rightsum/gerdoo/docs/images/front-cover-v1.png

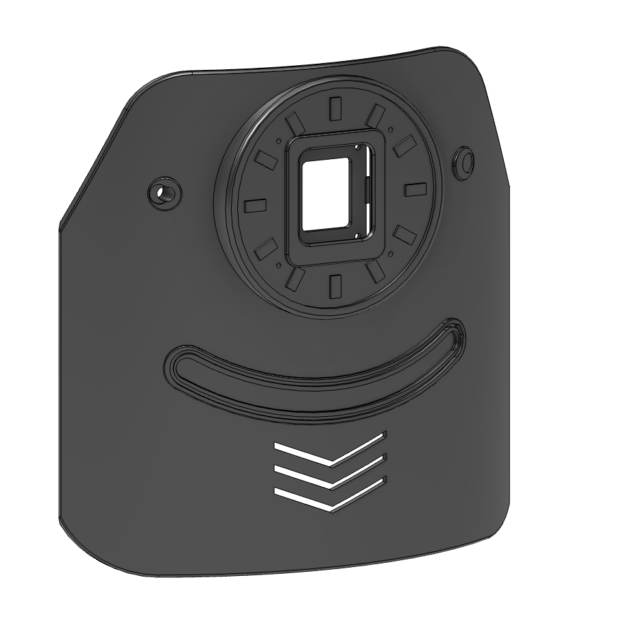
docs/images/front-cover-v1.png
