rightsum/gerdoo/print/3mf/gerdoo_coil_pads_A1.3mf

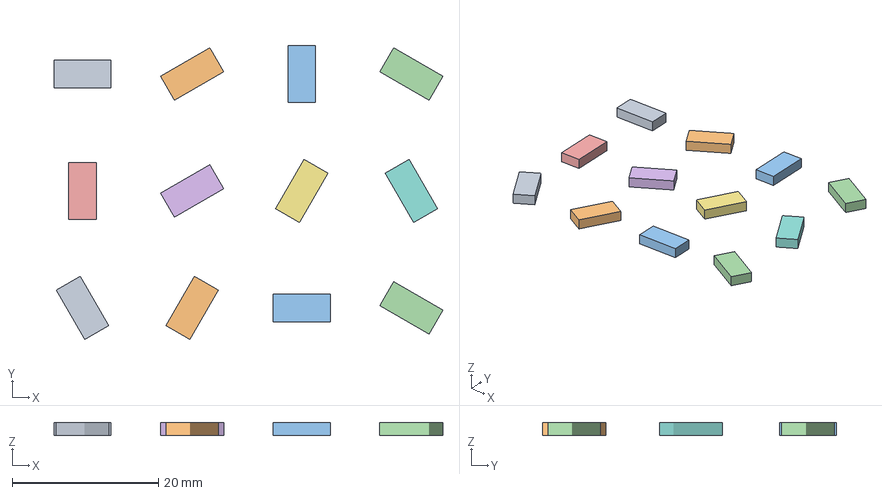
[picture p5: CAD file, 2026-11-07]
print/3mf/gerdoo_coil_pads_A1.3mf
53.2 x 40.2 x 1.80 mm
coil pad 01
coil pad 02
coil pad 03
coil pad 04
coil pad 05
coil pad 06
coil pad 07
coil pad 08
coil pad 09
coil pad 10
coil pad 11
coil pad 12
