rightsum/gerdoo/print/stl/01-1st-layer/1st-layer-v5.stl

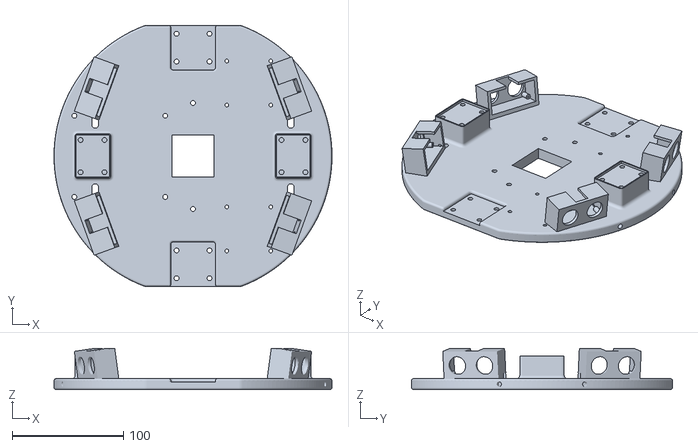
[picture p6: CAD file, 2026-11-07]
print/stl/01-1st-layer/1st-layer-v5.stl
250.0 x 234.9 x 37.3
