rightsum/gerdoo/print/stl/02-arm-bases-separators/arm-base-r.stl

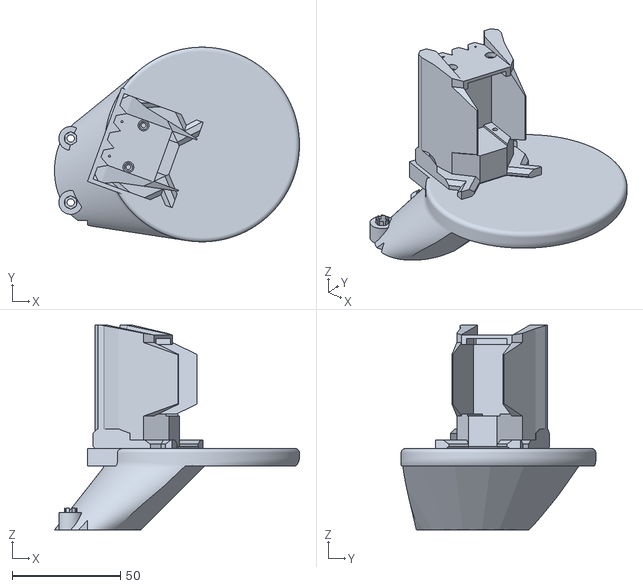
[picture p7: CAD file, 2026-11-07]
print/stl/02-arm-bases-separators/arm-base-r.stl
113.3 x 90.0 x 94.6
