rightsum/gerdoo/print/stl/04-base-board-holders/side-wall-robot-left.stl

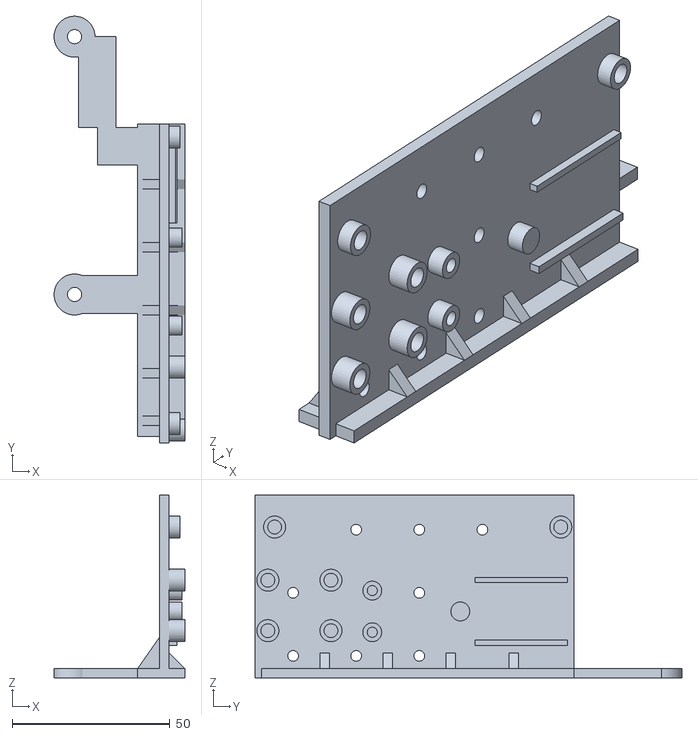
[picture p9: CAD file, 2026-11-07]
print/stl/04-base-board-holders/side-wall-robot-left.stl
41.5 x 135.2 x 58.0
