rightsum/gerdoo/print/stl/05-m3-spacers/m3-threaded-hex-spacer.stl

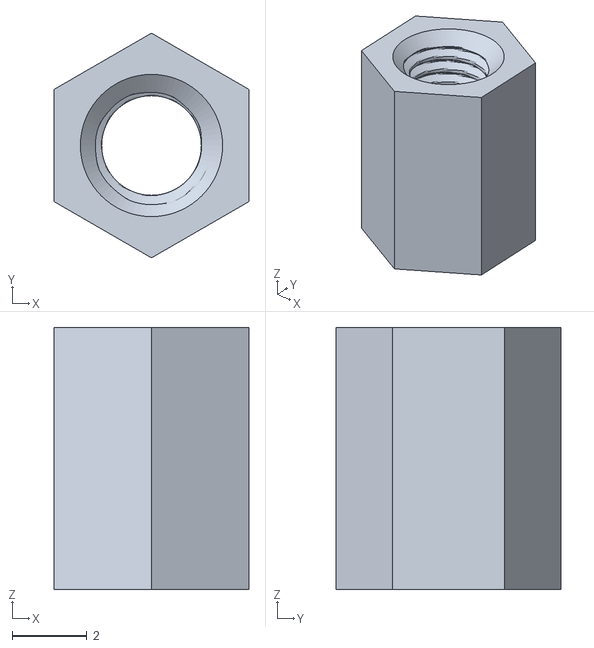
[picture p10: CAD file, 2026-11-07]
print/stl/05-m3-spacers/m3-threaded-hex-spacer.stl
5.20 x 6.00 x 7.00
