rightsum/gerdoo/print/stl/06-2nd-floor/2nd-3rd-separator.stl

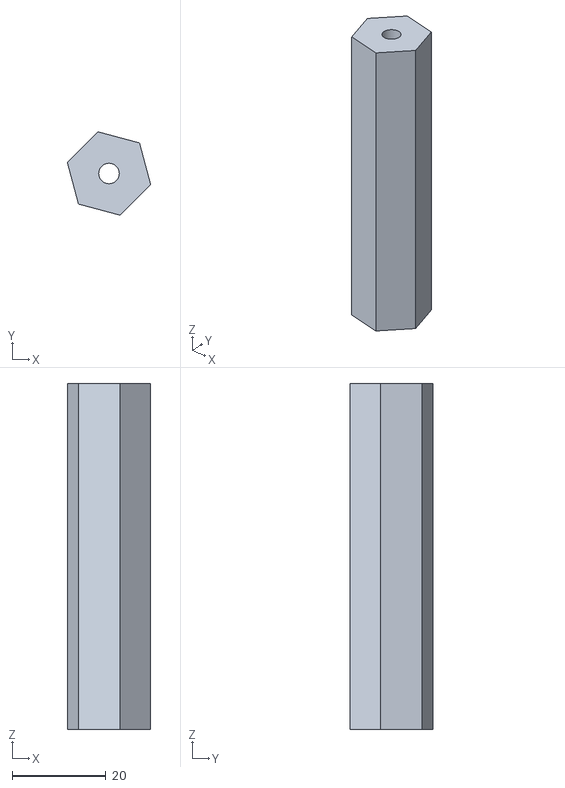
[picture p11: CAD file, 2026-11-07]
print/stl/06-2nd-floor/2nd-3rd-separator.stl
17.8 x 17.8 x 74.0
