rightsum/gerdoo/print/stl/07-3rd-floor/antenna-bracket-back-v2.stl

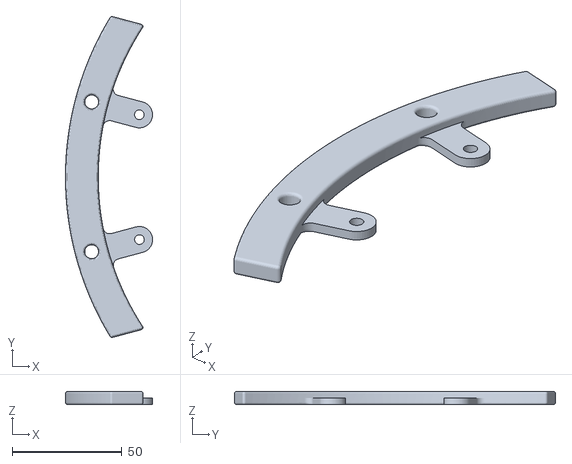
[picture p12: CAD file, 2026-11-07]
print/stl/07-3rd-floor/antenna-bracket-back-v2.stl
39.8 x 146.4 x 6.00
