rightsum/gerdoo/print/stl/08-neck-lidar/neck-pan-base.stl

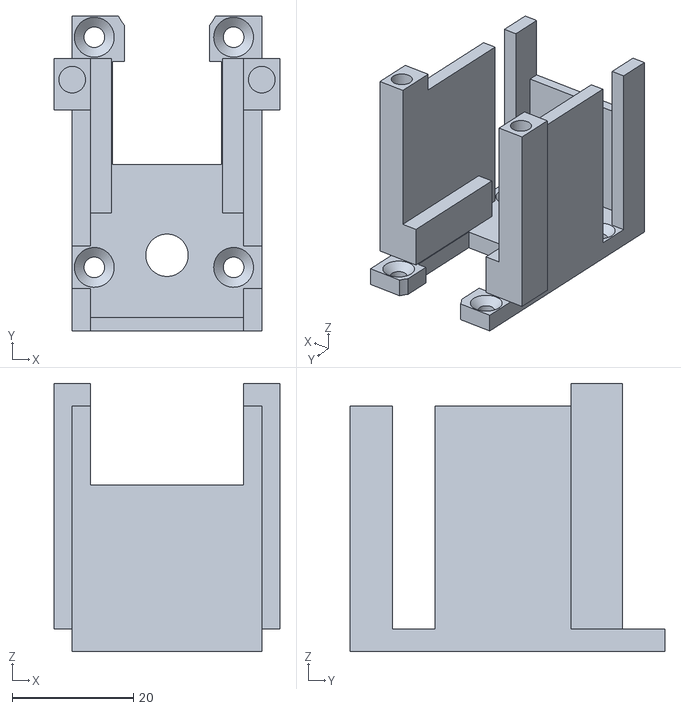
[picture p13: CAD file, 2026-11-07]
print/stl/08-neck-lidar/neck-pan-base.stl
37.3 x 52.0 x 44.2
