rightsum/gerdoo/print/stl/09-front-cover/front-cover-v12.stl

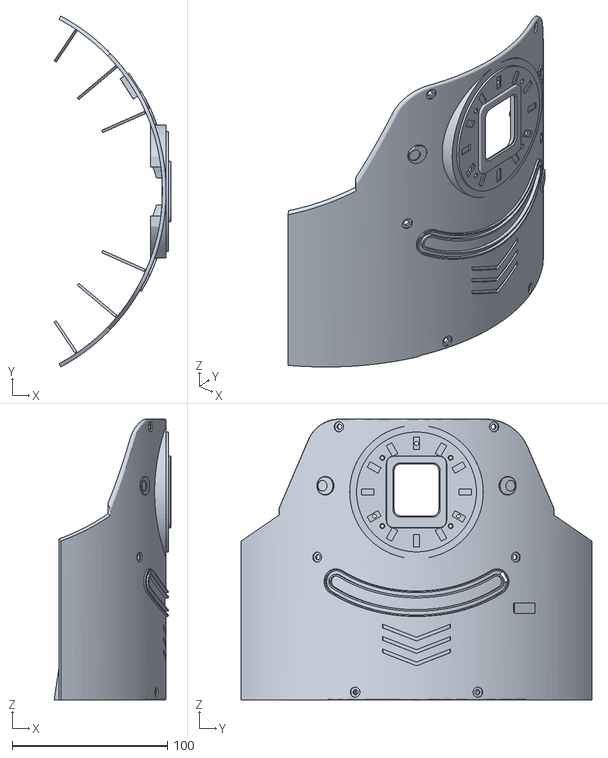
[picture p14: CAD file, 2026-11-07]
print/stl/09-front-cover/front-cover-v12.stl
75.2 x 226.0 x 181.0
