rightsum/gerdoo/print/stl/10-back-cover/ldr-cradle-v7.stl

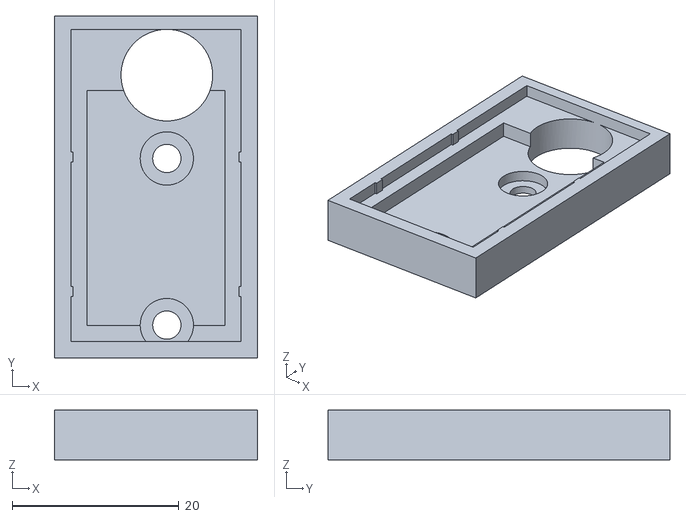
[picture p15: CAD file, 2026-11-07]
print/stl/10-back-cover/ldr-cradle-v7.stl
24.4 x 41.0 x 6.00
