rightsum/gerdoo/print/stl/11-display-retainer/display-retainer.stl

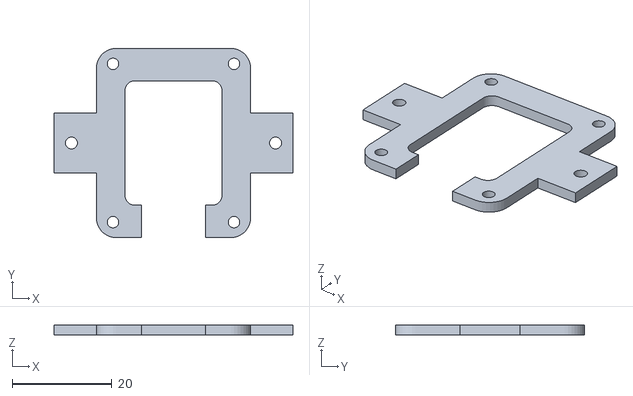
[picture p16: CAD file, 2026-11-07]
print/stl/11-display-retainer/display-retainer.stl
48.0 x 38.0 x 2.00
