rightsum/gerdoo/print/stl/12-coil-pads/coil-pad.stl

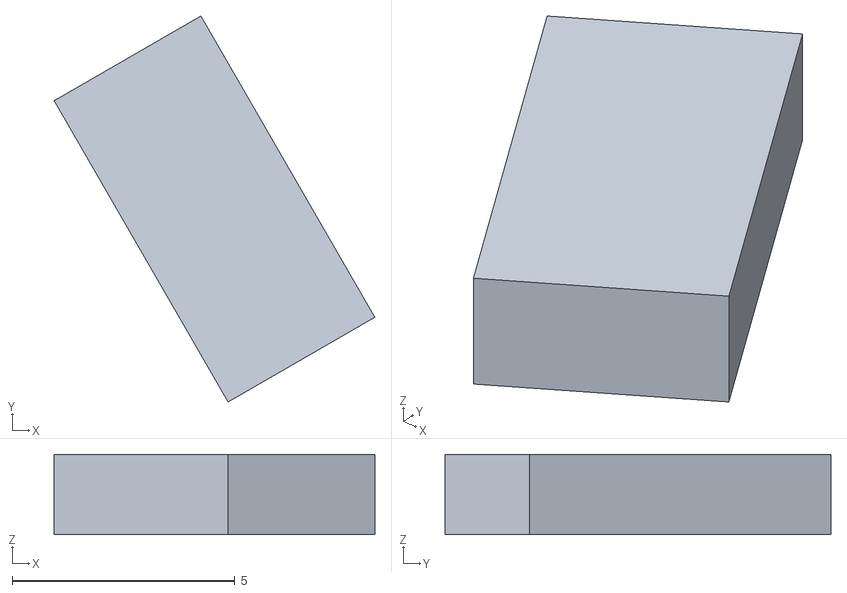
[picture p17: CAD file, 2026-11-07]
print/stl/12-coil-pads/coil-pad.stl
7.19 x 8.65 x 1.80
