rightsum/gerdoo/print/stl/15-dock-sign/sign-head.stl

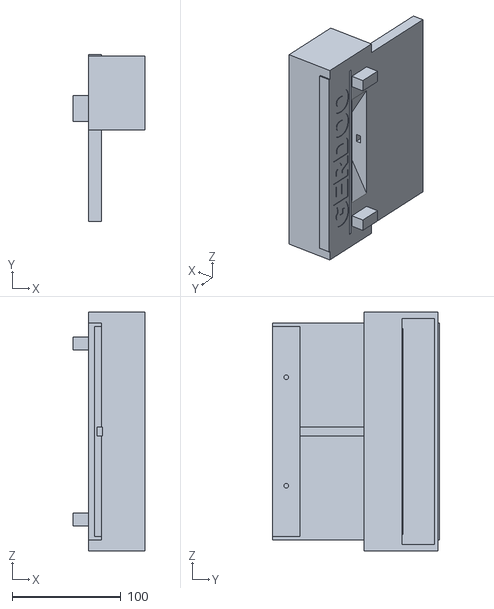
[picture p18: CAD file, 2026-11-07]
print/stl/15-dock-sign/sign-head.stl
66.0 x 153.3 x 220.0
