rightsum/gerdoo/print/stl/16-dock-letters/letter-5-r.stl

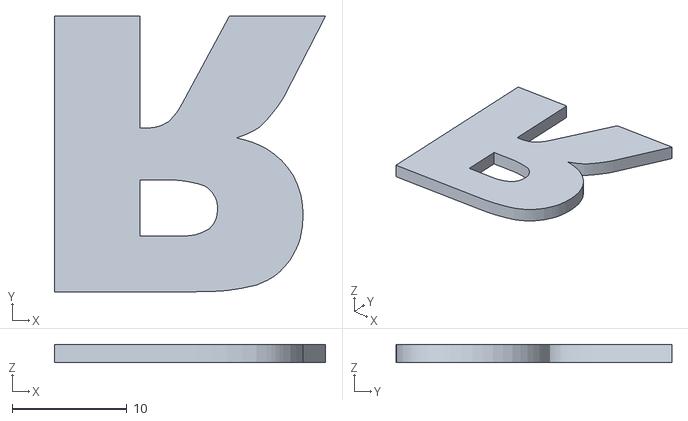
[picture p19: CAD file, 2026-11-07]
print/stl/16-dock-letters/letter-5-r.stl
23.6 x 24.0 x 1.60
