rightsum/gerdoo/sim/web/meshes/gerdoo/antennas.stl

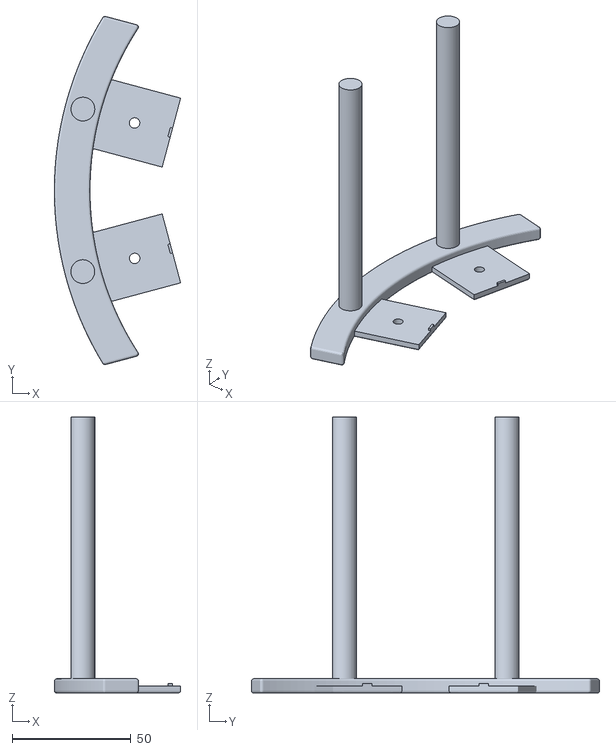
[picture p20: CAD file, 2026-11-07]
sim/web/meshes/gerdoo/antennas.stl
53.1 x 146.4 x 116.0
