rightsum/gerdoo/print/3mf/gerdoo_neck_lidar_v3_A1.3mf

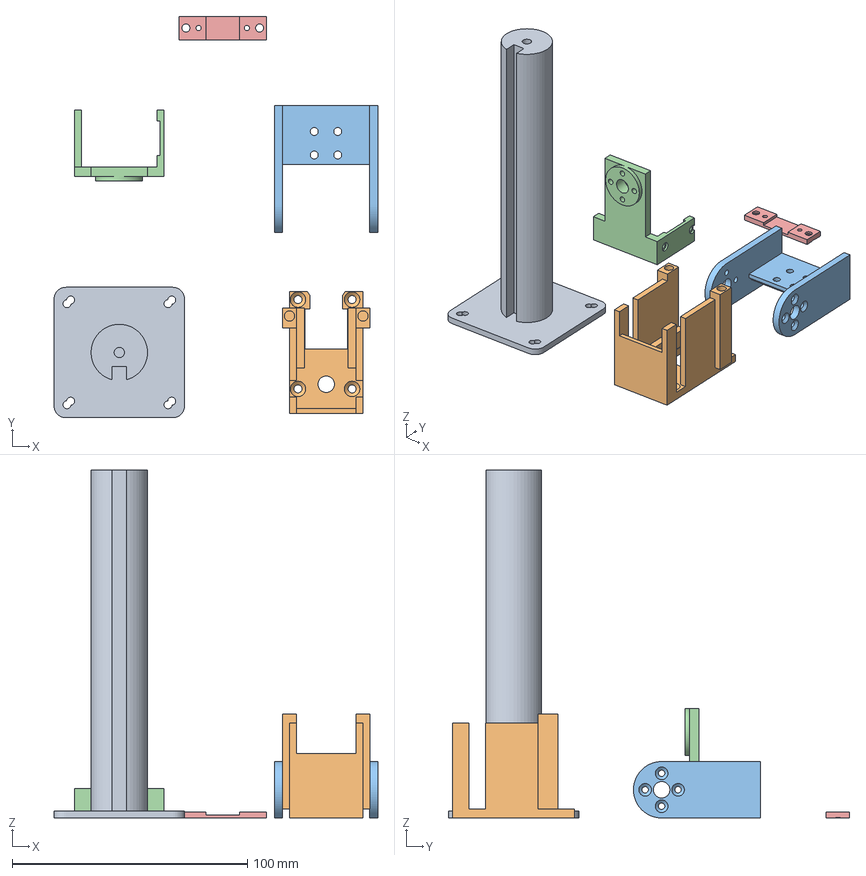
[picture p21: CAD file, 2026-11-07]
print/3mf/gerdoo_neck_lidar_v3_A1.3mf
137.8 x 170.8 x 148.0 mm
lidar holder v2 (plate down, post up)
neck pan base (floor down)
neck head yoke (on its back; support + PETG interface under the pad)
neck arm (on its side, +z up)
neck pan clamp (flipped)
