rightsum/gerdoo/print/stl/02-arm-bases-separators/separator-round-80.stl

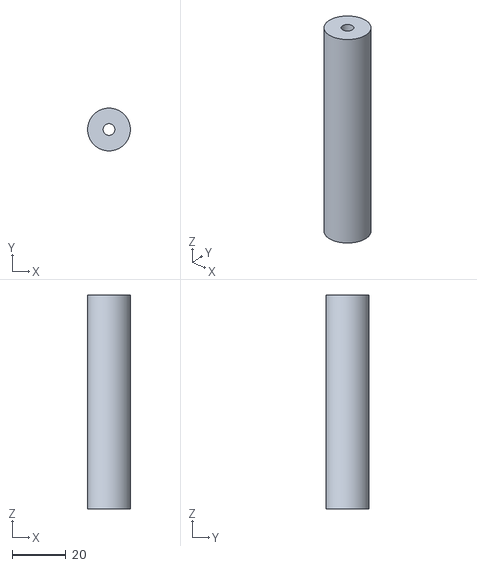
[picture p22: CAD file, 2026-11-07]
print/stl/02-arm-bases-separators/separator-round-80.stl
16.0 x 16.0 x 80.0
