rightsum/gerdoo/print/stl/03-motor-shims/motor-bracket-shim-1-48-mm.stl

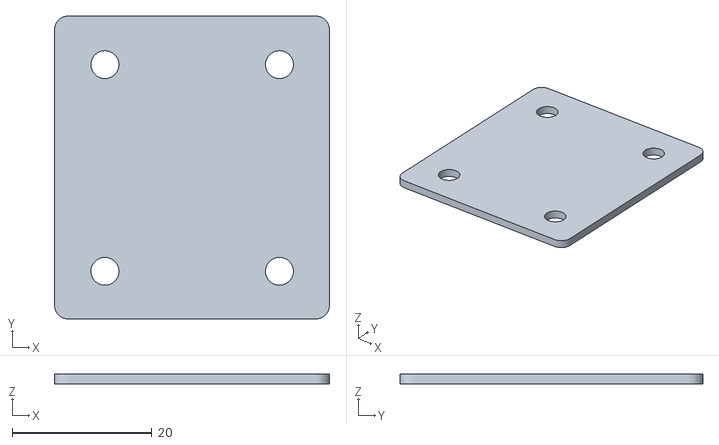
[picture p23: CAD file, 2026-11-07]
print/stl/03-motor-shims/motor-bracket-shim-1-48-mm.stl
39.4 x 43.4 x 1.48
