rightsum/gerdoo/print/stl/04-base-board-holders/side-wall-robot-right.stl

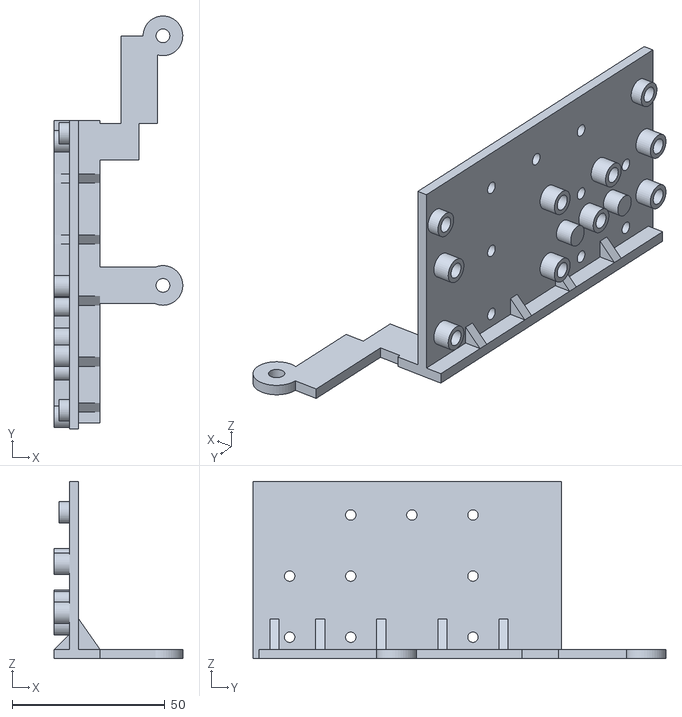
[picture p24: CAD file, 2026-11-07]
print/stl/04-base-board-holders/side-wall-robot-right.stl
42.1 x 135.2 x 58.0
