rightsum/gerdoo/print/stl/06-2nd-floor/hub-rear-spacer.stl

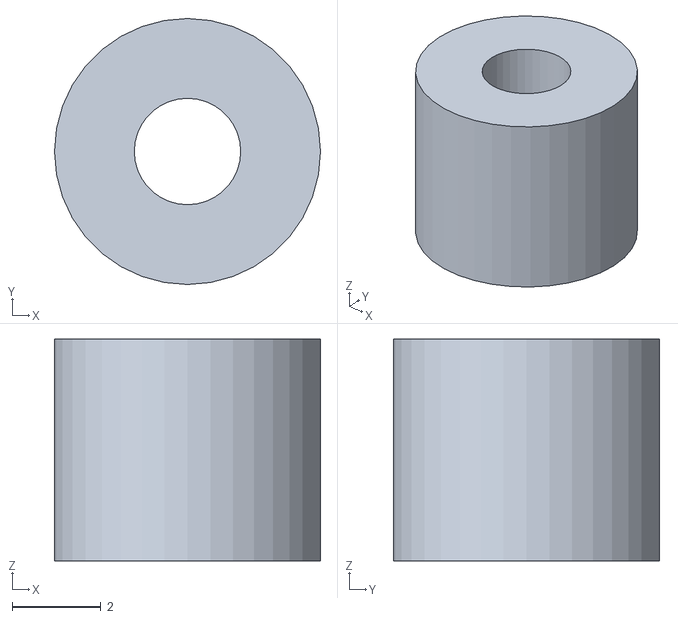
[picture p25: CAD file, 2026-11-07]
print/stl/06-2nd-floor/hub-rear-spacer.stl
6.00 x 6.00 x 5.00
