rightsum/gerdoo/print/stl/07-3rd-floor/speaker-grille-cap.stl

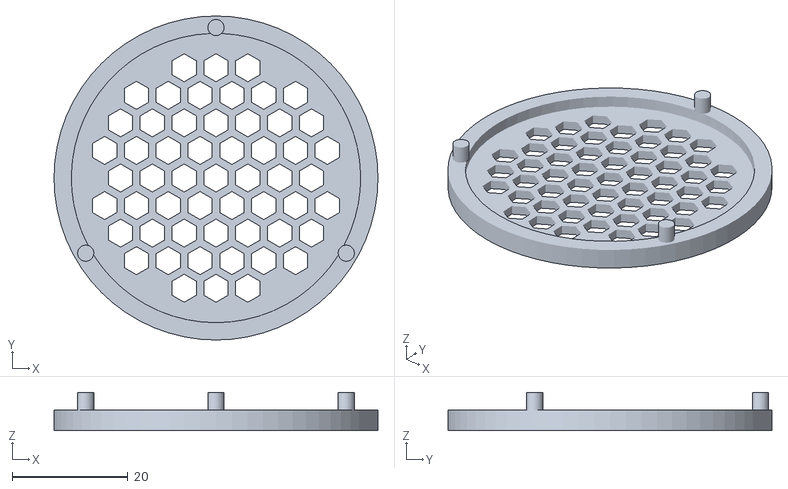
[picture p26: CAD file, 2026-11-07]
print/stl/07-3rd-floor/speaker-grille-cap.stl
56.0 x 56.0 x 6.60
