rightsum/gerdoo/print/stl/08-neck-lidar/neck-head-yoke.stl

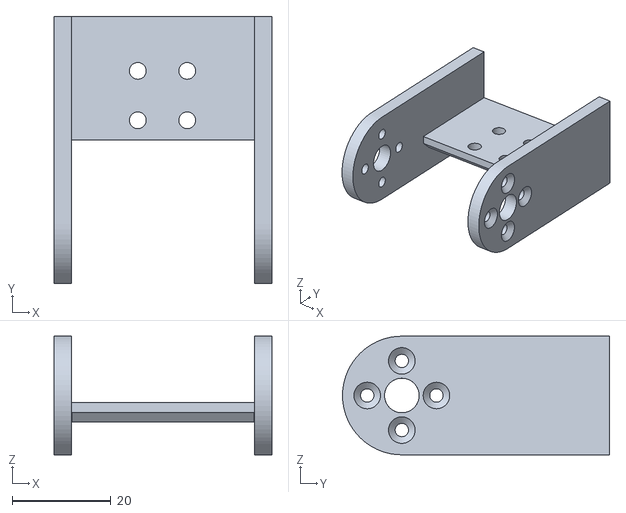
[picture p27: CAD file, 2026-11-07]
print/stl/08-neck-lidar/neck-head-yoke.stl
44.0 x 54.0 x 24.0
