rightsum/gerdoo/print/stl/10-back-cover/back-cover-v11.stl

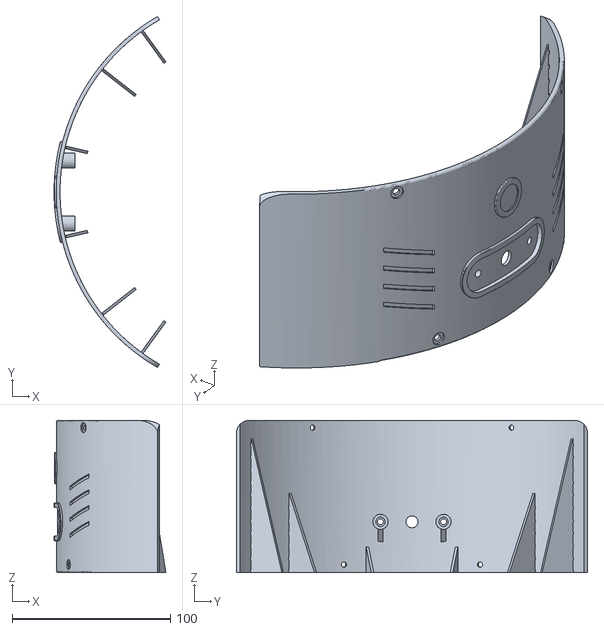
[picture p28: CAD file, 2026-11-07]
print/stl/10-back-cover/back-cover-v11.stl
70.7 x 221.7 x 96.0
