rightsum/gerdoo/print/stl/16-dock-letters/letter-o.stl

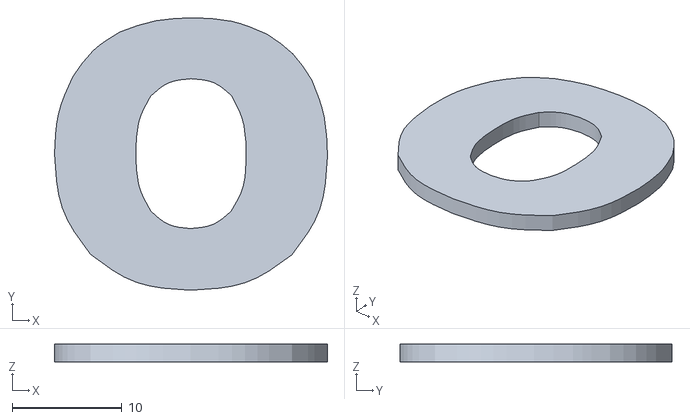
[picture p29: CAD file, 2026-11-07]
print/stl/16-dock-letters/letter-o.stl
24.9 x 24.8 x 1.60
