rightsum/gerdoo/sim/web/meshes/gerdoo/brain.stl

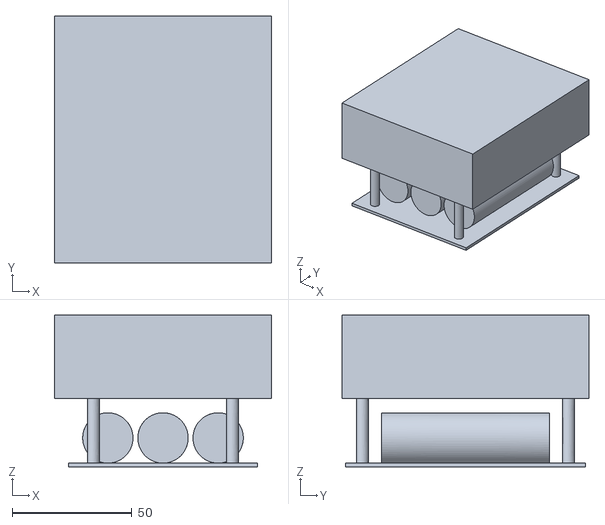
[picture p30: CAD file, 2026-11-07]
sim/web/meshes/gerdoo/brain.stl
90.5 x 103.0 x 63.4
