rightsum/gerdoo/print/stl/02-arm-bases-separators/separator-hex-77.stl

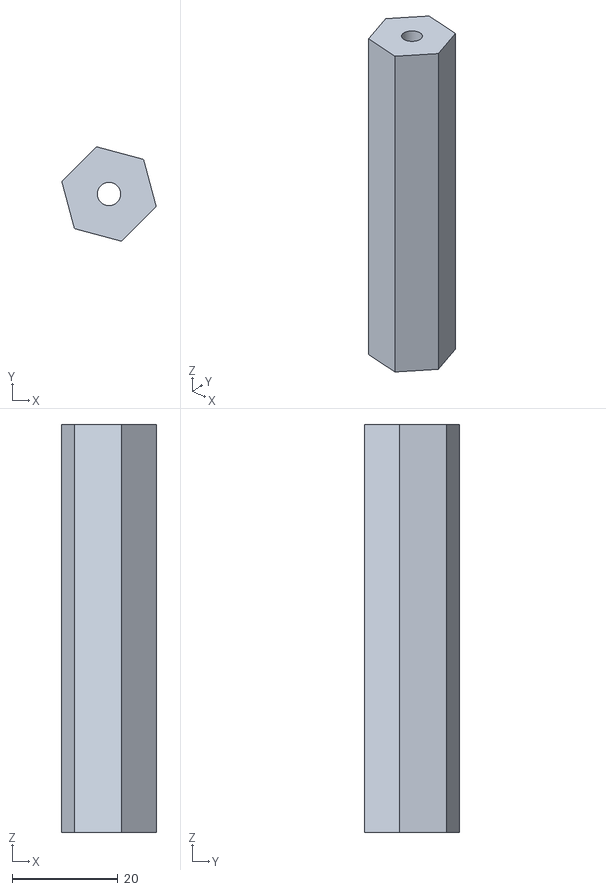
[picture p31: CAD file, 2026-11-07]
print/stl/02-arm-bases-separators/separator-hex-77.stl
17.8 x 17.8 x 77.0
