rightsum/gerdoo/print/stl/07-3rd-floor/3rd-floor-v2.stl

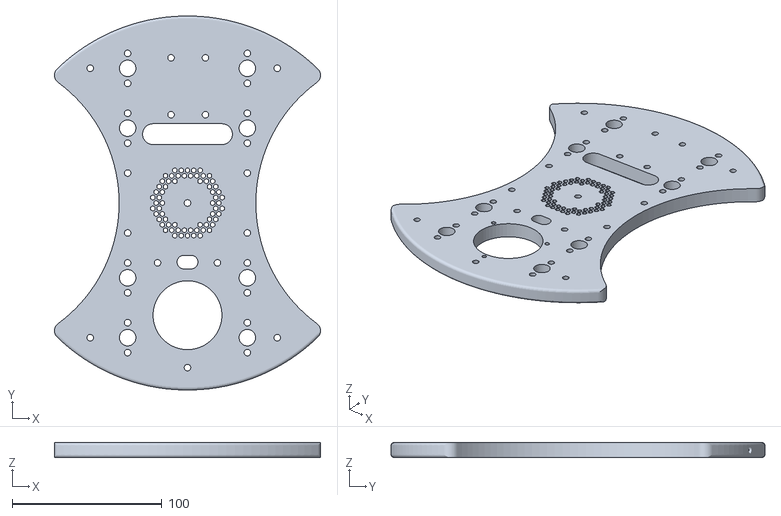
[picture p33: CAD file, 2026-11-07]
print/stl/07-3rd-floor/3rd-floor-v2.stl
177.8 x 249.9 x 10.0
