rightsum/gerdoo/print/stl/08-neck-lidar/lidar-holder-v2.stl

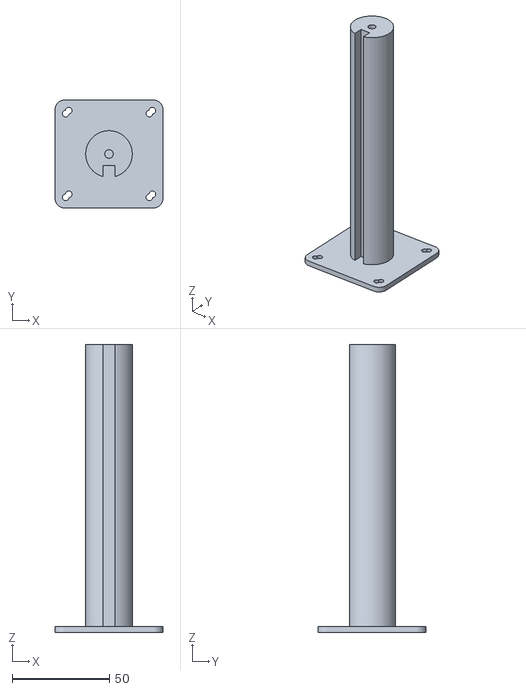
[picture p34: CAD file, 2026-11-07]
print/stl/08-neck-lidar/lidar-holder-v2.stl
55.5 x 55.5 x 148.0
