rightsum/gerdoo/print/stl/16-dock-letters/letter-4-d.stl

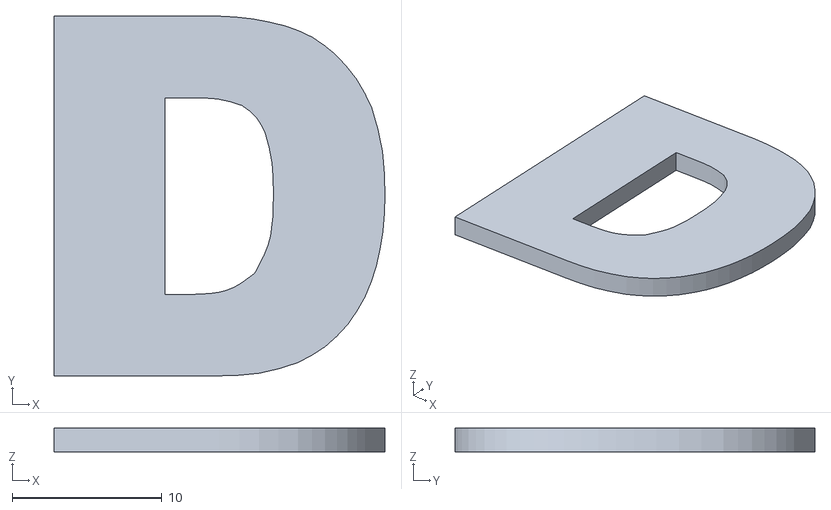
[picture p35: CAD file, 2026-11-07]
print/stl/16-dock-letters/letter-4-d.stl
22.1 x 24.0 x 1.60
