rightsum/gerdoo/sim/web/meshes/gerdoo/neck_tilt.stl

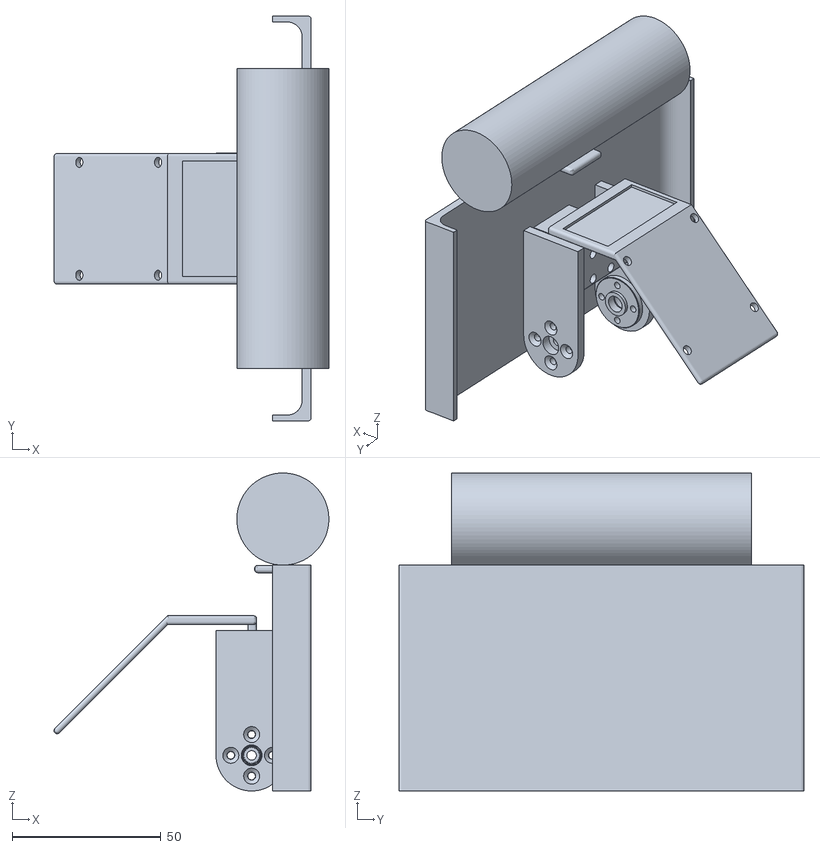
[picture p36: CAD file, 2026-11-07]
sim/web/meshes/gerdoo/neck_tilt.stl
92.5 x 136.3 x 107.0
