rightsum/gerdoo/print/3mf/gerdoo_dock_cradle_A1.3mf

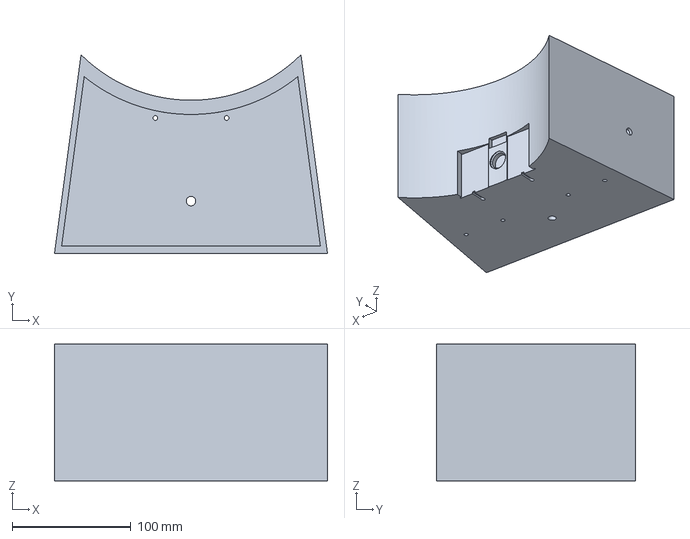
[picture p37: CAD file, 2026-11-07]
print/3mf/gerdoo_dock_cradle_A1.3mf
230.0 x 167.4 x 115.0 mm
