rightsum/gerdoo/print/stl/03-motor-shims/motor-bracket-shim-0-68-mm.stl

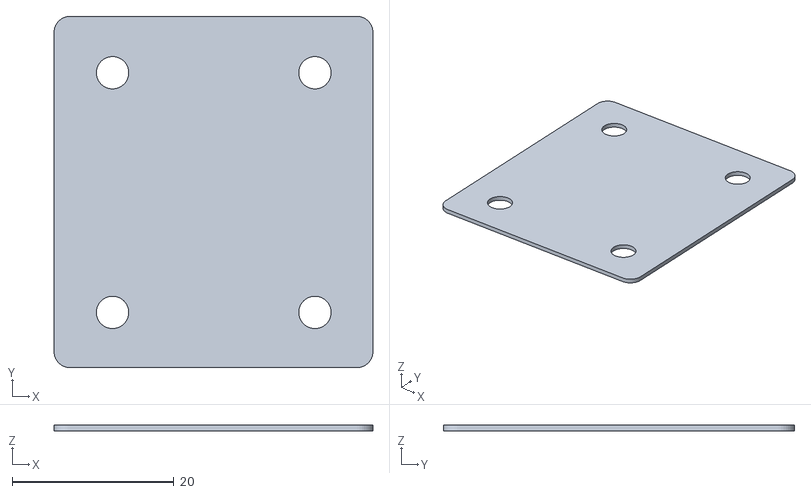
[picture p38: CAD file, 2026-11-07]
print/stl/03-motor-shims/motor-bracket-shim-0-68-mm.stl
39.4 x 43.4 x 0.68
