rightsum/gerdoo/print/stl/04-base-board-holders/servo-tower.stl

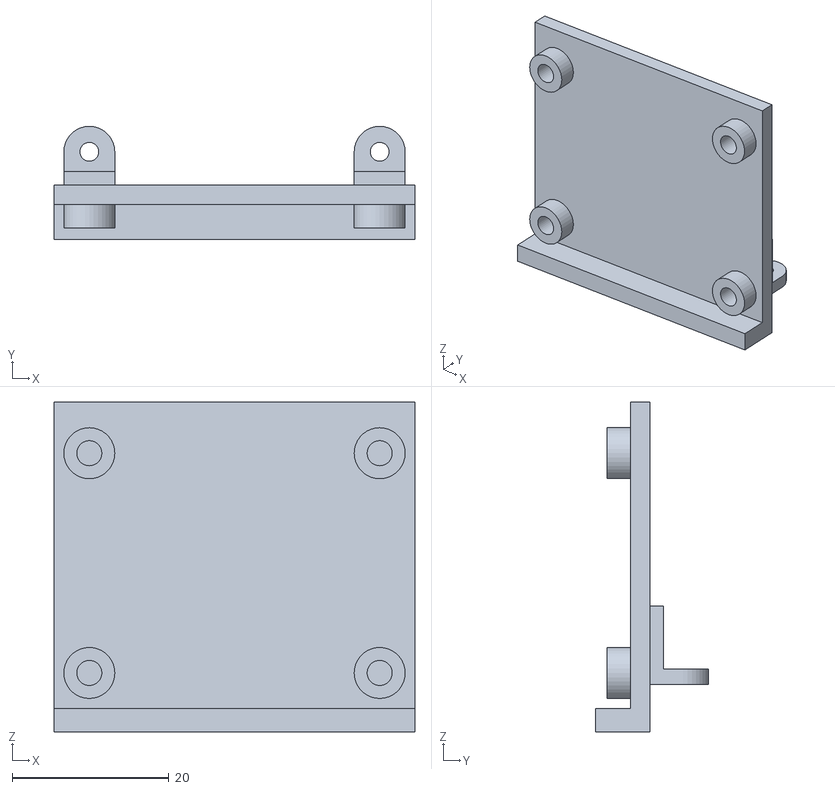
[picture p39: CAD file, 2026-11-07]
print/stl/04-base-board-holders/servo-tower.stl
46.0 x 14.4 x 42.0
