rightsum/gerdoo/print/stl/08-neck-lidar/neck-arm.stl

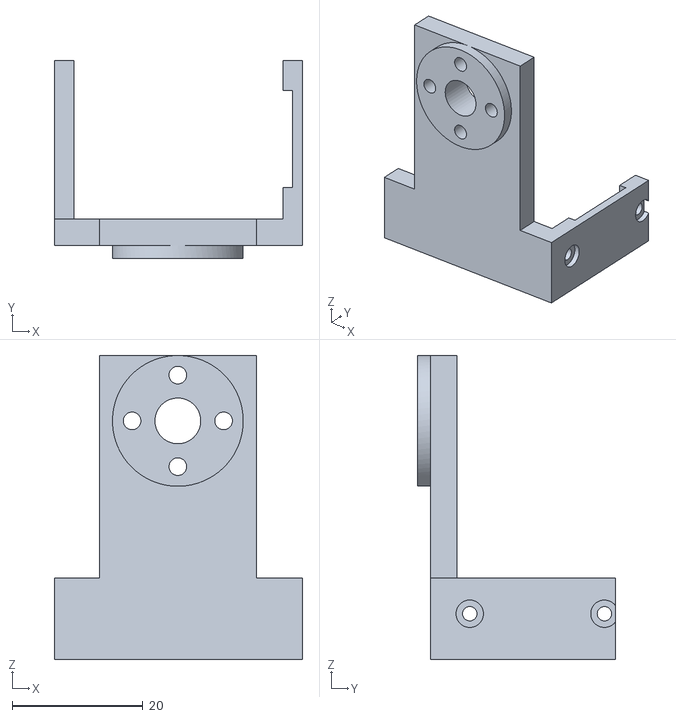
[picture p40: CAD file, 2026-11-07]
print/stl/08-neck-lidar/neck-arm.stl
38.0 x 30.3 x 46.5
