rightsum/gerdoo/sim/web/meshes/gerdoo/armbase.stl

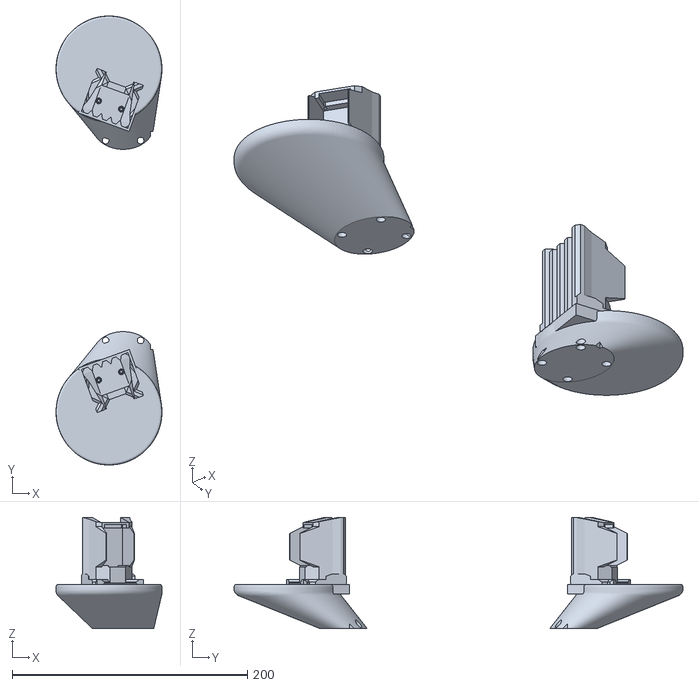
[picture p41: CAD file, 2026-11-07]
sim/web/meshes/gerdoo/armbase.stl
90.0 x 381.3 x 94.6
