rightsum/gerdoo/print/3mf/gerdoo_gold_ring_A1.3mf

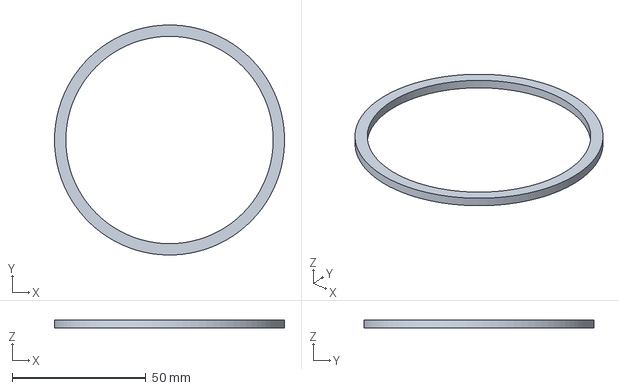
[picture p42: CAD file, 2026-11-07]
print/3mf/gerdoo_gold_ring_A1.3mf
86.0 x 86.0 x 3.00 mm
