rightsum/gerdoo/sim/web/meshes/gerdoo/cover_back.stl

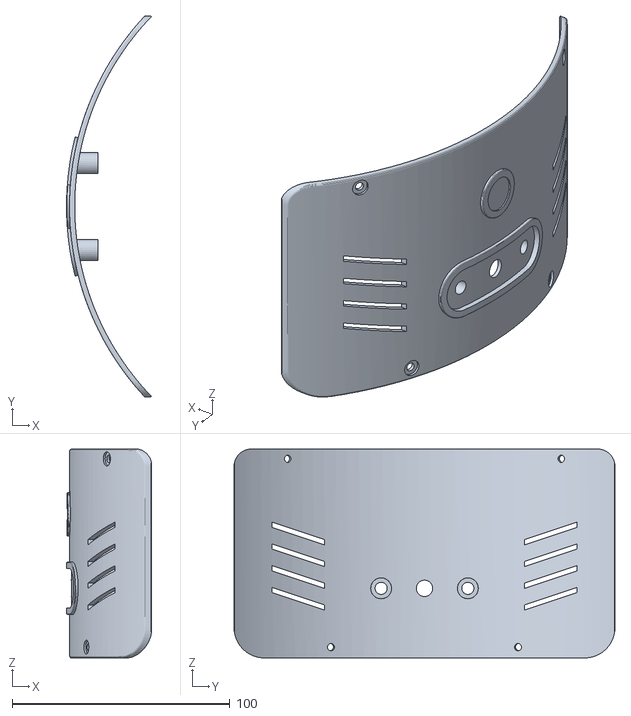
[picture p43: CAD file, 2026-11-07]
sim/web/meshes/gerdoo/cover_back.stl
39.0 x 175.0 x 96.0
