rightsum/gerdoo/print/3mf/gerdoo_base_board_holders_v5_A1.3mf

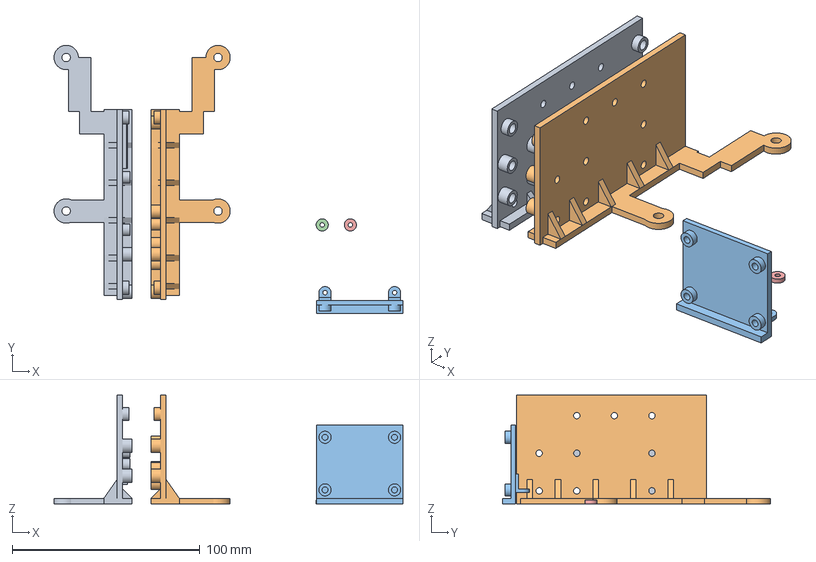
[picture p44: CAD file, 2026-11-07]
print/3mf/gerdoo_base_board_holders_v5_A1.3mf
185.7 x 142.8 x 58.0 mm
side wall robot-left (+x)
side wall robot-right (-x)
servo tower (ears supported, PETG interface)
Teensy washer 1
Teensy washer 2
