rightsum/gerdoo/print/3mf/gerdoo_2nd_floor_A1.3mf

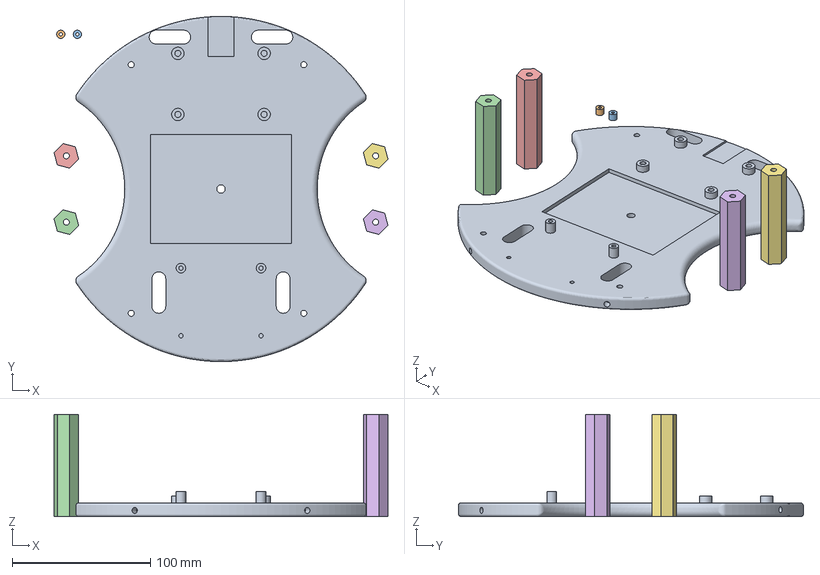
[picture p45: CAD file, 2026-11-07]
print/3mf/gerdoo_2nd_floor_A1.3mf
241.8 x 250.0 x 74.0 mm
2nd-floor-v2
hub rear spacer 1
hub rear spacer 2
2nd-3rd separator 1 (hex 74)
2nd-3rd separator 2 (hex 74)
2nd-3rd separator 3 (hex 74)
2nd-3rd separator 4 (hex 74)
