rightsum/gerdoo/print/3mf/gerdoo_arm_bases_separators_A1_v2.3mf

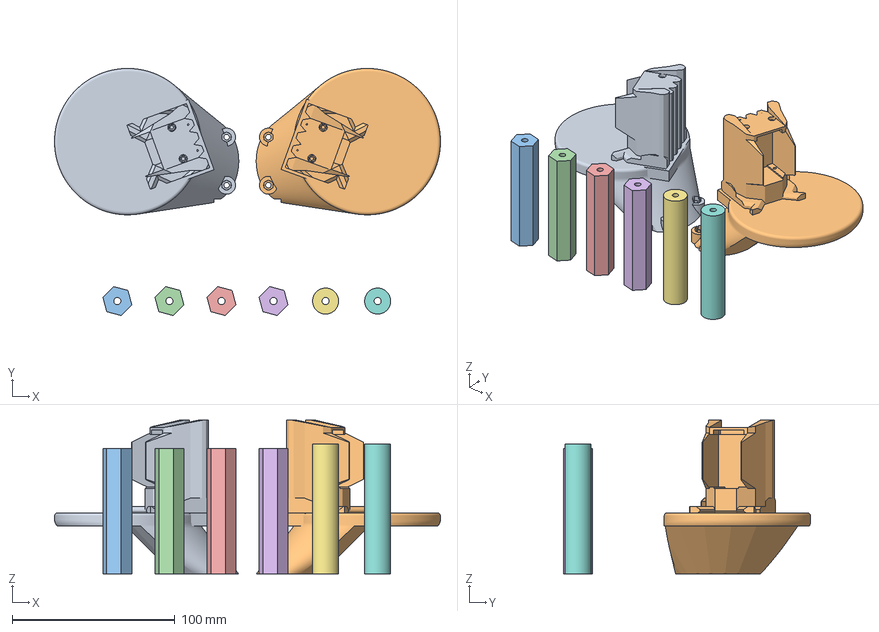
[picture p46: CAD file, 2026-11-07]
print/3mf/gerdoo_arm_bases_separators_A1_v2.3mf
237.3 x 151.9 x 94.6 mm
arm base L
arm base R
separator hex 77 #1
separator hex 77 #2
separator hex 77 #3
separator hex 77 #4
separator round 80 #1
separator round 80 #2
