rightsum/gerdoo/(list of files, cad)

Other CAD files:
print/3mf/gerdoo_1st_layer_A1_v5.3mf
print/stl/04-base-board-holders/teensy-washer.stl
