rightsum/gerdoo/teensy_microros/teensy_microros.ino

/*
  Teensy 4.1 — micro-ROS node over USB, with the debug console kept alive.

  Step 3: adds main battery voltage monitoring on A0 via a Voltage Sensor
  Module (Max 25V, 5:1 divider). The 3S pack (12.6V max) produces 2.52V on
  A0 — safely within the 3.3V ADC range.

  ---------------------------------------------------------------------------
  DUAL SERIAL — the reason this builds with usb=serial2
  ---------------------------------------------------------------------------
  micro-ROS consumes the serial port it runs on: that port becomes XRCE-DDS
  framing, so Serial.print debugging on it is impossible. On a robot still
  being brought up that is painful, and it is exactly what makes micro-ROS
  failures feel opaque.

  Teensy solves it for free. USB Type = Dual Serial gives two CDC interfaces:

    Serial      -> /dev/ttyACM0  human console. Same line protocol as
                                 teensy_bringup, so health_check.py still works.
    SerialUSB1  -> /dev/ttyACM1  micro-ROS transport. Agent attaches here.

  micro_ros_arduino's default transport is hardcoded to `Serial`
  (src/default_transport.cpp), but its four entry points are declared
  __attribute__((weak)). Defining strong versions below overrides them and
  moves micro-ROS onto SerialUSB1. No library edits, so an upgrade cannot
  silently revert this.

  ---------------------------------------------------------------------------
  ROS 2 interface
  ---------------------------------------------------------------------------
    publish   /teensy/heartbeat      std_msgs/Int32     seq, 1 Hz
    publish   /teensy/temperature    std_msgs/Float32   die temp C, 1 Hz
    publish   /teensy/battery_main   std_msgs/Float32   main battery V, 1 Hz
    subscribe /teensy/led            std_msgs/Bool      onboard LED

  The LED is the only actuator that exists yet. It proves the subscribe path
  end to end without touching a single robot peripheral.

  ---------------------------------------------------------------------------
  RECONNECTION
  ---------------------------------------------------------------------------
  A naive micro-ROS sketch hangs forever if the agent is not up at boot, and
  stays dead if the agent restarts. On a robot both happen routinely — the
  Jetson reboots, the agent gets restarted. So this runs a connection state
  machine that pings for the agent, builds its entities when one appears, and
  tears them down cleanly when it vanishes. The console keeps working in every
  state, which is the whole point of Dual Serial.
*/

#include "arm_types.h"
#include <EEPROM.h>
#include <micro_ros_arduino.h>

#include <stdio.h>
#include <rcl/rcl.h>
#include <rcl/error_handling.h>
#include <rclc/rclc.h>
#include <rclc/executor.h>

#include <std_msgs/msg/int32.h>
#include <std_msgs/msg/float32.h>
#include <std_msgs/msg/bool.h>

#include <Servo.h>  // Neck pan/tilt servos (SG90)
#include "drive_types.h"  // drive motors; encoders on the RT1062's hardware decoders

// ---------------------------------------------------------------------------
// Transport override: move micro-ROS from Serial to SerialUSB1.
// These are strong definitions of the library's weak symbols.
// ---------------------------------------------------------------------------
extern "C" {

bool arduino_transport_open(struct uxrCustomTransport * transport) {
  (void)transport;
  SerialUSB1.begin(115200);
  return true;
}

bool arduino_transport_close(struct uxrCustomTransport * transport) {
  (void)transport;
  SerialUSB1.end();
  return true;
}

// NOTE: micro_ros_arduino.h declares buf as `const uint8_t *` while
// default_transport.cpp defines it non-const. The header wins here, since we
// include it — C linkage means the symbol still overrides the weak definition.
size_t arduino_transport_write(struct uxrCustomTransport * transport,
                               const uint8_t * buf, size_t len, uint8_t * errcode) {
  (void)transport; (void)errcode;
  return SerialUSB1.write(buf, len);
}

size_t arduino_transport_read(struct uxrCustomTransport * transport,
                              uint8_t * buf, size_t len, int timeout,
                              uint8_t * errcode) {
  (void)transport; (void)errcode;
  SerialUSB1.setTimeout(timeout);
  return SerialUSB1.readBytes((char *)buf, len);
}

}  // extern "C"

// ---------------------------------------------------------------------------

const char *FW_VERSION = "microros-0.5.1";
const int LED_PIN = 13;
const uint32_t HEARTBEAT_MS = 1000;

// --- Main battery voltage sensor (A0) ---
// Voltage Sensor Module Max 25V: 30k/7.5k divider = factor 5.
// 3S Li-ion pack: 12.6V max → 2.52V on A0 (safe for 3.3V ADC).
const int BATTERY_MAIN_PIN = A0;
const float BATTERY_DIVIDER = 5.0;
const float ADC_REF = 3.3;
const int ADC_MAX = 4095;  // 12-bit

// Cached readings (updated every heartbeat, published when agent is up).
float batteryMainV = 0.0;
float powerPackV = 0.0;        // from the servos, see readPackVoltage()
uint8_t powerPackId = 0;
uint32_t lastPackRead = 0;
int   batteryMainRaw = 0;

// --- COB LED strip via D4184 MOSFET module (pin 4) ---
// Low-side switch: the strip sits across OUT+/OUT- and the module chops OUT-
// against VIN-. 18 kHz is inside the module's 0-20 kHz spec, above adult
// hearing so the strip does not whine, and far above any camera shutter so it
// cannot band the OV9281s or the Brio.
const int LED_STRIP_PIN = 4;
const int STRIP_PWM_HZ  = 18000;
const int STRIP_MAX     = 4095;   // 12-bit, matches analogWriteResolution

// Brightness ceiling. Held at ~39% while the strip shared the LM2596S 5V rail
// with the neck servos — at full brightness it sagged the pack ~200 mV and made
// the servos strain. Lifted to full 2026-08-26 once the strip moved onto its own
// MINI560 (5A) fed from the 12.6V pack. Drop it again if the strip is ever put
// back on a shared rail.
const int STRIP_DUTY_MAX = STRIP_MAX;

// --- Ambient light sensor (Keyestudio photoresistor module, A1) ---
// The 10k half of the divider is on the module; S is its midpoint. Powered
// from 3.3V, so S can never exceed the ADC limit.
const int LDR_PIN = A1;

// Which way the module's divider is wired — batches differ. true = a lit
// sensor reads high. Flip this if covering the sensor makes the strip go
// DARKER instead of brighter.
const bool LDR_BRIGHT_IS_HIGH = true;

// Raw ADC values bracketing the useful range; readings outside clamp. Tune
// with the CAL console commands, then paste the results back here — they are
// not persisted across a reboot or a reflash.
//
// Measured 2026-08-26 with the Keyestudio module on A1:
//   529  — sensor covered by a hand
//   3163 — full daylight
//   ~950-1270 — normally lit room at night
//
// The bright endpoint is deliberately NOT the 3163 daylight figure. Against
// that ceiling a lit evening room maps to ~78% brightness and the strip would
// run near-full every night. 1400 means "the room is adequately lit, strip
// off", and anything brighter simply clamps. Raise it to make the strip more
// eager, lower it to make it lazier.
int ldrRawDark   = 529;
int ldrRawBright = 1400;

// Slow enough that the strip lighting its own sensor cannot start an
// oscillation. At 20 Hz updates this is roughly a one-second time constant.
const float STRIP_SMOOTH = 0.05f;
const uint32_t STRIP_UPDATE_MS = 50;

int   ldrRaw        = 0;
float ldrNormalized = 0.0;   // 0 = dark room, 1 = bright room
float stripSmoothed = 0.0;   // 0..1, before gamma
int   stripDuty     = 0;     // last value written to the pin
float stripManual   = -1.0;  // <0 = follow the sensor, 0..1 = forced level
uint32_t lastStripUpdate = 0;

// --- Neck pan/tilt servos (SG90, 5V from LM2596S) ---
Servo servoPan;
Servo servoTilt;
const int SERVO_PAN_PIN = 2;
const int SERVO_TILT_PIN = 3;
// Straight ahead on this bracket, found by adjustment — not the midpoint of
// the servo range, because the gimbal is not mounted symmetrically.
int servoPanPos = 110;
int servoTiltPos = 110;
const int SERVO_PAN_MIN = 70;   // pan limits
const int SERVO_PAN_MAX = 140;
const int SERVO_TILT_MIN = 60;  // tilt limits
const int SERVO_TILT_MAX = 120;

// The tilt servo is mounted reversed, so a larger logical angle means a
// smaller pulse. Wrapped in a function because this has to be applied
// identically at boot and in the loop; two copies of it would drift.
static inline void writeTilt(int logical) {
  servoTilt.write(SERVO_TILT_MAX + SERVO_TILT_MIN - logical);
}

// Smooth motion.
//
// This used to ease by a fixed FRACTION per loop iteration, which sounds gentle
// until you notice the loop runs at ~999 Hz: 3% of the remaining distance a
// thousand times a second is a peak of roughly 1200 deg/s. A human neck manages
// 100-200. It looked and sounded like a machine snapping to position.
//
// Now it is time-based and speed-limited, updating at 50 Hz because that is the
// rate an SG90 actually samples its input — writing faster is churn the servo
// cannot see.
const uint32_t SERVO_UPDATE_MS = 20;      // 50 Hz, the servo's own PWM rate
const float SERVO_MAX_DPS = 70.0;         // top speed, degrees per second
const float SERVO_EASE_TAU = 0.18;        // seconds; softens the last few degrees

// Holding position is what makes an SG90 buzz. Pan carries no weight against
// gravity, so once it has settled it can be released and go quiet. Tilt holds
// the screen up and must stay energised or the head drops.
const uint32_t PAN_IDLE_DETACH_MS = 1500;

uint32_t lastServoUpdate = 0;
uint32_t panSettledAt = 0;
bool panAttached = true;

float servoPanCurrent = 110.0;
float servoTiltCurrent = 110.0;

// Move `current` toward `target` for one tick: an exponential ease so it settles
// softly, capped by a top speed so a large jump does not start out violently.
static inline float easeToward(float current, float target, float dt) {
  float delta = target - current;
  if (fabsf(delta) < 0.05f) return (float)target;
  float step = delta * (dt / SERVO_EASE_TAU);
  float cap = SERVO_MAX_DPS * dt;
  if (step > cap) step = cap;
  if (step < -cap) step = -cap;
  return current + step;
}
int lastPanWritten = 110;
int lastTiltWritten = 110;

// How often to look for an agent while disconnected. Cheap ping, so half a
// second keeps reconnection prompt without flooding the link.
const uint32_t AGENT_PING_MS = 500;

rcl_allocator_t   allocator;
rclc_support_t    support;
rcl_node_t        node;
rclc_executor_t   executor;

rcl_publisher_t   pub_heartbeat;
rcl_publisher_t   pub_temperature;
rcl_publisher_t   pub_battery_main;
rcl_publisher_t   pub_light;
rcl_subscription_t sub_led;
rcl_subscription_t sub_strip;

std_msgs__msg__Int32   msg_heartbeat;
std_msgs__msg__Float32 msg_temperature;
std_msgs__msg__Float32 msg_battery_main;
std_msgs__msg__Float32 msg_light;
std_msgs__msg__Bool    msg_led;
std_msgs__msg__Float32 msg_strip;

enum AgentState { WAITING_AGENT, AGENT_AVAILABLE, AGENT_CONNECTED, AGENT_DISCONNECTED };
AgentState agentState = WAITING_AGENT;

uint32_t bootMillis = 0;
uint32_t lastHeartbeat = 0;
uint32_t lastAgentPing = 0;
uint32_t heartbeatSeq = 0;
uint32_t loopCount = 0;
uint32_t loopsPerSec = 0;
uint32_t lastRateCalc = 0;
uint32_t agentConnects = 0;
uint32_t agentDrops = 0;
bool ledState = false;

char cmdBuf[128];
uint8_t cmdLen = 0;

// Run fn; on failure return false from the calling function. Used during
// entity creation so a partial build is reported rather than half-committed.
#define RCCHECK(fn) { rcl_ret_t rc = fn; if (rc != RCL_RET_OK) return false; }
// Fire and forget — a failed publish is reported via the console, not fatal.
#define RCSOFT(fn)  { rcl_ret_t rc = fn; (void)rc; }

const char *restartCause() {
  uint32_t s = SRC_SRSR;
  if (s & (1 << 6)) return "temp_panic";
  if (s & (1 << 5)) return "watchdog3";
  if (s & (1 << 4)) return "jtag_sw";
  if (s & (1 << 3)) return "jtag_hw";
  if (s & (1 << 2)) return "watchdog";
  if (s & (1 << 1)) return "lockup";
  if (s & (1 << 0)) return "power_on";
  return "unknown";
}

const char *agentStateName() {
  switch (agentState) {
    case WAITING_AGENT:      return "waiting";
    case AGENT_AVAILABLE:    return "available";
    case AGENT_CONNECTED:    return "connected";
    case AGENT_DISCONNECTED: return "disconnected";
  }
  return "?";
}

void led_callback(const void *msgin) {
  const std_msgs__msg__Bool *m = (const std_msgs__msg__Bool *)msgin;
  ledState = m->data;
  digitalWrite(LED_PIN, ledState ? HIGH : LOW);
  Serial.print("EVENT led=");
  Serial.println(ledState ? "on" : "off");
}

// Perceived brightness tracks roughly the square of duty cycle, so a linear
// ramp looks wrong at the bottom end. Gamma 2.0 is cheap and close enough.
static inline int stripGamma(float level) {
  return (int)(level * level * STRIP_MAX + 0.5);
}

void updateStrip() {
  ldrRaw = analogRead(LDR_PIN);

  int lo = min(ldrRawDark, ldrRawBright);
  int hi = max(ldrRawDark, ldrRawBright);
  float span = (float)(hi - lo);
  float n = (span > 1.0) ? ((float)constrain(ldrRaw, lo, hi) - lo) / span : 0.0;
  ldrNormalized = LDR_BRIGHT_IS_HIGH ? n : (1.0 - n);

  // Darker room -> brighter strip, unless a manual level is in force.
  float target = (stripManual >= 0.0) ? stripManual : (1.0 - ldrNormalized);

  stripSmoothed += (target - stripSmoothed) * STRIP_SMOOTH;
  int duty = stripGamma(constrain(stripSmoothed, 0.0, 1.0));
  duty = min(duty, STRIP_DUTY_MAX);
  if (duty != stripDuty) {
    stripDuty = duty;
    analogWrite(LED_STRIP_PIN, stripDuty);
  }
}

void strip_callback(const void *msgin) {
  const std_msgs__msg__Float32 *m = (const std_msgs__msg__Float32 *)msgin;
  // Negative hands control back to the light sensor.
  stripManual = (m->data < 0.0) ? -1.0 : constrain(m->data, 0.0, 1.0);
  Serial.print("EVENT strip=");
  if (stripManual < 0.0) Serial.println("auto");
  else                   Serial.println(stripManual, 2);
}

bool createEntities() {
  allocator = rcl_get_default_allocator();
  RCCHECK(rclc_support_init(&support, 0, NULL, &allocator));
  RCCHECK(rclc_node_init_default(&node, "teensy_node", "", &support));

  RCCHECK(rclc_publisher_init_default(
      &pub_heartbeat, &node,
      ROSIDL_GET_MSG_TYPE_SUPPORT(std_msgs, msg, Int32), "teensy/heartbeat"));

  RCCHECK(rclc_publisher_init_default(
      &pub_temperature, &node,
      ROSIDL_GET_MSG_TYPE_SUPPORT(std_msgs, msg, Float32), "teensy/temperature"));

  RCCHECK(rclc_publisher_init_default(
      &pub_battery_main, &node,
      ROSIDL_GET_MSG_TYPE_SUPPORT(std_msgs, msg, Float32), "teensy/battery_main"));

  RCCHECK(rclc_publisher_init_default(
      &pub_light, &node,
      ROSIDL_GET_MSG_TYPE_SUPPORT(std_msgs, msg, Float32), "teensy/light_level"));

  RCCHECK(rclc_subscription_init_default(
      &sub_led, &node,
      ROSIDL_GET_MSG_TYPE_SUPPORT(std_msgs, msg, Bool), "teensy/led"));

  RCCHECK(rclc_subscription_init_default(
      &sub_strip, &node,
      ROSIDL_GET_MSG_TYPE_SUPPORT(std_msgs, msg, Float32), "teensy/led_strip"));

  // Handle count must match the number of subscriptions added below.
  executor = rclc_executor_get_zero_initialized_executor();
  RCCHECK(rclc_executor_init(&executor, &support.context, 2, &allocator));
  RCCHECK(rclc_executor_add_subscription(
      &executor, &sub_led, &msg_led, &led_callback, ON_NEW_DATA));
  RCCHECK(rclc_executor_add_subscription(
      &executor, &sub_strip, &msg_strip, &strip_callback, ON_NEW_DATA));

  return true;
}

void destroyEntities() {
  // Stop the session from blocking on a dead link during teardown.
  rmw_context_t *rmw_context = rcl_context_get_rmw_context(&support.context);
  (void)rmw_uros_set_context_entity_destroy_session_timeout(rmw_context, 0);

  rcl_publisher_fini(&pub_heartbeat, &node);
  rcl_publisher_fini(&pub_temperature, &node);
  rcl_publisher_fini(&pub_battery_main, &node);
  rcl_publisher_fini(&pub_light, &node);
  rcl_subscription_fini(&sub_led, &node);
  rcl_subscription_fini(&sub_strip, &node);
  rclc_executor_fini(&executor);
  rcl_node_fini(&node);
  rclc_support_fini(&support);
}

// ---------------------------------------------------------------------------
// Console — same protocol as teensy_bringup so health_check.py still works,
// plus micro-ROS specific fields.
// ---------------------------------------------------------------------------

void sendInfo() {
  Serial.print("INFO fw=");           Serial.print(FW_VERSION);
  Serial.print(" board=teensy41 mcu=imxrt1062");
  Serial.print(" cpu_hz=");           Serial.print(F_CPU_ACTUAL);
  Serial.print(" serial=");           Serial.print(HW_OCOTP_MAC0 & 0xFFFFFF);
  Serial.print(" usb=serial");        // Dual Serial: this is CDC #1
  Serial.print(" transport=SerialUSB1");
  Serial.print(" built=" __DATE__ " " __TIME__);
  Serial.println();
}

void sendHealth() {
  Serial.print("HEALTH temp_c=");     Serial.print(tempmonGetTemp(), 1);
  Serial.print(" uptime_ms=");        Serial.print(millis() - bootMillis);
  Serial.print(" loop_hz=");          Serial.print(loopsPerSec);
  Serial.print(" restart=");          Serial.print(restartCause());
  Serial.print(" heartbeats=");       Serial.print(heartbeatSeq);
  Serial.println();
}

void sendRos() {
  Serial.print("ROS agent=");         Serial.print(agentStateName());
  Serial.print(" connects=");         Serial.print(agentConnects);
  Serial.print(" drops=");            Serial.print(agentDrops);
  Serial.print(" led=");              Serial.print(ledState ? "on" : "off");
  Serial.println();
}

void sendBattery() {
  Serial.print("BATTERY main_v=");    Serial.print(batteryMainV, 3);
  Serial.print(" raw=");              Serial.print(batteryMainRaw);
  Serial.print(" pin_v=");            Serial.print((float)batteryMainRaw * ADC_REF / ADC_MAX, 3);
  Serial.print(" pack_v=");           Serial.print(powerPackV, 1);
  Serial.print(" pack_from_id=");     Serial.print(powerPackId);
  Serial.print(" source=");           Serial.print(batteryMainV > 0 && batteryMainV == powerPackV ? "servo" : "a0");
  Serial.println();
}

void sendLight() {
  Serial.print("LIGHT raw=");      Serial.print(ldrRaw);
  Serial.print(" norm=");          Serial.print(ldrNormalized, 3);
  Serial.print(" cal_dark=");      Serial.print(ldrRawDark);
  Serial.print(" cal_bright=");    Serial.print(ldrRawBright);
  Serial.print(" duty=");          Serial.print(stripDuty);
  Serial.print("/");               Serial.print(STRIP_DUTY_MAX);
  Serial.print(" (cap of ");       Serial.print(STRIP_MAX);  Serial.print(")");
  Serial.print(" mode=");          Serial.print(stripManual >= 0.0 ? "manual" : "auto");
  Serial.print(" level=");         Serial.print(stripManual, 2);   // manual level 0..1, -1 in auto
  Serial.println();
}

// ---------------------------------------------------------------------------
// Arm servo bus — Feetech STS3215 through the Waveshare driver board
// ---------------------------------------------------------------------------
// READ-ONLY. BUS SCAN sends PING (0x01) and READ (0x02) packets and nothing
// else: no WRITE, no SYNC_WRITE, no torque enable, no RESET. A servo answers
// a ping or a read without moving.
//
// Wiring: Teensy SerialN TX/RX to the board's UART header, board jumper on A
// (UART mode), grounds common. The board turns the two-wire UART into the
// servos' one-wire bus. The port is opened on the first scan, not at boot, so
// nothing drives its pins until asked to. Serial3 is not offered: its RX is
// pin 15, the light sensor.

const uint32_t BUS_BAUD = 1000000;           // ElRobot / Feetech factory default
const uint8_t  STS_PING = 0x01, STS_READ = 0x02;
const uint8_t  STS_REG_MODEL = 3;            // u16
const uint8_t  STS_REG_TORQUE_ENABLE = 40;   // u8
const uint8_t  STS_REG_PRESENT = 56;         // position u16, speed u16, load u16, volt u8 (0.1 V), temp u8
const uint32_t BUS_REPLY_US = 2000;
bool busOpened[9] = {false};
uint32_t busRxBytes = 0;     // every byte seen during a scan, echoes included

HardwareSerial *busPort(int n) {
  switch (n) {
    case 1: return &Serial1;
    case 2: return &Serial2;
    case 7: return &Serial7;
    case 8: return &Serial8;
  }
  return nullptr;
}

// Find a valid status packet from `id` in buf. The board's one-wire bus can
// echo our own request back on RX, so an exact copy of it at the start is
// skipped. Returns the parameter count, -1 if nothing valid yet, and sets
// *garbled when bytes arrived that do not form a valid reply — what two
// servos with the same ID answering at once looks like.
int busParse(const uint8_t *buf, uint8_t n, const uint8_t *req, uint8_t reqLen, uint8_t id,
             uint8_t *out, uint8_t outMax, uint8_t *err, bool *garbled) {
  uint8_t i = (n >= reqLen && memcmp(buf, req, reqLen) == 0) ? reqLen : 0;
  *garbled = n > i;
  for (; i + 4 <= n; i++) {
    if (buf[i] != 0xFF || buf[i + 1] != 0xFF || buf[i + 2] != id) continue;
    uint8_t len = buf[i + 3];
    if (len < 2 || i + 4 + len > n) return -1;
    uint8_t sum = 0;
    for (uint8_t k = i + 2; k <= i + 2 + len; k++) sum += buf[k];
    if ((uint8_t)~sum != buf[i + 3 + len]) continue;
    *err = buf[i + 4];
    uint8_t m = min((uint8_t)(len - 2), outMax);
    memcpy(out, buf + i + 5, m);
    *garbled = false;
    return m;
  }
  return -1;
}

// One request and its reply. Returns the reply's parameter count, or -1.
int busTransact(HardwareSerial &s, uint8_t id, uint8_t instr, const uint8_t *params, uint8_t np,
                uint8_t *out, uint8_t outMax, uint8_t *err, bool *garbled) {
  uint8_t req[16];          // header 5 + up to 10 params + checksum
  uint8_t len = np + 2, sum = id + len + instr;
  req[0] = 0xFF; req[1] = 0xFF; req[2] = id; req[3] = len; req[4] = instr;
  for (uint8_t i = 0; i < np; i++) { req[5 + i] = params[i]; sum += params[i]; }
  req[5 + np] = ~sum;
  uint8_t reqLen = 6 + np;

  while (s.available()) s.read();
  s.write(req, reqLen);
  s.flush();

  uint8_t buf[64];
  uint8_t n = 0;
  int got = -1;
  *garbled = false;
  elapsedMicros t;
  while (t < BUS_REPLY_US && n < sizeof(buf)) {
    if (!s.available()) continue;
    buf[n++] = s.read();
    busRxBytes++;
    got = busParse(buf, n, req, reqLen, id, out, outMax, err, garbled);
    if (got >= 0) return got;
  }
  if (n > 0) busParse(buf, n, req, reqLen, id, out, outMax, err, garbled);
  return got;
}

void busScan(int portNum) {
  HardwareSerial *s = busPort(portNum);
  if (!s) {
    Serial.println("ERR bus_port (use 1, 2, 7 or 8)");
    return;
  }
  if (!busOpened[portNum]) {
    s->begin(BUS_BAUD);
    busOpened[portNum] = true;
  }
  Serial.print("BUS SCAN port=Serial");  Serial.print(portNum);
  Serial.print(" baud=");                Serial.print(BUS_BAUD);
  Serial.println(" (ping + read only)");

  uint8_t found[253], nFound = 0;
  busRxBytes = 0;
  uint8_t out[8], err;
  bool garbled;
  for (int id = 0; id <= 252; id++) {
    if (busTransact(*s, id, STS_PING, nullptr, 0, out, sizeof(out), &err, &garbled) >= 0) {
      found[nFound++] = id;
    } else if (garbled) {
      Serial.print("BUS id=");  Serial.print(id);
      Serial.println(" garbled reply (two servos sharing this ID?)");
    }
  }

  for (uint8_t k = 0; k < nFound; k++) {
    uint8_t id = found[k];
    uint8_t model[2] = {0, 0}, torque[1] = {0}, present[8] = {0};
    const uint8_t qModel[2] = {STS_REG_MODEL, 2};
    const uint8_t qTorque[2] = {STS_REG_TORQUE_ENABLE, 1};
    const uint8_t qPresent[2] = {STS_REG_PRESENT, 8};
    bool okModel = busTransact(*s, id, STS_READ, qModel, 2, model, 2, &err, &garbled) == 2;
    bool okTorque = busTransact(*s, id, STS_READ, qTorque, 2, torque, 1, &err, &garbled) == 1;
    bool okPresent = busTransact(*s, id, STS_READ, qPresent, 2, present, 8, &err, &garbled) == 8;
    Serial.print("BUS id=");  Serial.print(id);
    if (okModel) { Serial.print(" model=");  Serial.print(model[0] | (model[1] << 8)); }
    if (okPresent) {
      Serial.print(" pos=");    Serial.print(present[0] | (present[1] << 8));
      Serial.print(" volt=");   Serial.print(present[6] / 10.0, 1);
      Serial.print(" temp=");   Serial.print(present[7]);
    }
    if (okTorque) { Serial.print(" torque=");  Serial.print(torque[0]); }
    Serial.print(" err=0x");  Serial.println(err, HEX);
  }

  // rx_bytes=0 means nothing reached RX at all: wiring, jumper or power,
  // not the servos.
  Serial.print("BUS SCAN done rx_bytes=");  Serial.print(busRxBytes);
  Serial.print(" found=");  Serial.print(nFound);
  Serial.print(" ids=");
  for (uint8_t k = 0; k < nFound; k++) {
    if (k) Serial.print(",");
    Serial.print(found[k]);
  }
  Serial.println();
}

// Debug: one READ to one ID, then every byte that comes back, raw. Read-only.
void busReadRaw(int portNum, int id, int addr, int len) {
  HardwareSerial *s = busPort(portNum);
  if (!s || id < 0 || id > 252 || addr < 0 || addr > 255 || len < 1 || len > 32) {
    Serial.println("ERR usage: BUS READ <id> <addr> <len>  (port 7)");
    return;
  }
  if (!busOpened[portNum]) {
    s->begin(BUS_BAUD);
    busOpened[portNum] = true;
  }
  uint8_t req[8] = {0xFF, 0xFF, (uint8_t)id, 4, STS_READ, (uint8_t)addr, (uint8_t)len, 0};
  req[7] = ~(uint8_t)(req[2] + req[3] + req[4] + req[5] + req[6]);
  while (s->available()) s->read();
  s->write(req, 8);
  s->flush();
  uint8_t buf[64];
  uint8_t n = 0;
  elapsedMicros t;
  while (t < 5000 && n < sizeof(buf)) {
    if (s->available()) buf[n++] = s->read();
  }
  Serial.print("BUS RAW id=");  Serial.print(id);
  Serial.print(" addr=");       Serial.print(addr);
  Serial.print(" len=");        Serial.print(len);
  Serial.print(" got=");        Serial.print(n);
  Serial.print(" :");
  for (uint8_t i = 0; i < n; i++) {
    Serial.print(buf[i] < 16 ? " 0" : " ");
    Serial.print(buf[i], HEX);
  }
  Serial.println();
}

// Change one servo's ID. The only write in this file. It touches the EEPROM
// lock (55) and the ID register (5) and nothing else, so torque stays off and
// nothing moves. Refuses unless exactly one servo answers at `from` (five
// clean position reads in a row; two servos with one ID garble their replies)
// and nothing answers at `to`.
const uint8_t STS_WRITE = 0x03, STS_REG_ID = 5, STS_REG_LOCK = 55;

bool busOnlyOne(HardwareSerial &s, uint8_t id) {
  const uint8_t q[2] = {STS_REG_PRESENT, 2};
  uint8_t out[2], err;
  bool garbled;
  for (int i = 0; i < 5; i++) {
    if (busTransact(s, id, STS_READ, q, 2, out, 2, &err, &garbled) != 2) return false;
  }
  return true;
}

void busSetId(int portNum, int from, int to) {
  HardwareSerial *s = busPort(portNum);
  if (!s || from < 0 || from > 252 || to < 1 || to > 252 || from == to) {
    Serial.println("ERR usage: BUS SETID <from> <to>  (to = 1..252, port 7)");
    return;
  }
  if (!busOpened[portNum]) {
    s->begin(BUS_BAUD);
    busOpened[portNum] = true;
  }
  uint8_t out[2], err;
  bool garbled;
  if (busTransact(*s, to, STS_PING, nullptr, 0, out, 2, &err, &garbled) >= 0 || garbled) {
    Serial.print("BUS SETID refused: something already answers at id=");  Serial.println(to);
    return;
  }
  if (!busOnlyOne(*s, from)) {
    Serial.print("BUS SETID refused: id=");  Serial.print(from);
    Serial.println(" is missing or shared by more than one servo; isolate one servo first");
    return;
  }
  const uint8_t unlock[2] = {STS_REG_LOCK, 0};
  const uint8_t setId[2] = {STS_REG_ID, (uint8_t)to};
  const uint8_t lock[2] = {STS_REG_LOCK, 1};
  busTransact(*s, from, STS_WRITE, unlock, 2, out, 2, &err, &garbled);
  busTransact(*s, from, STS_WRITE, setId, 2, out, 2, &err, &garbled);
  delay(20);
  busTransact(*s, to, STS_WRITE, lock, 2, out, 2, &err, &garbled);
  delay(20);

  const uint8_t qId[2] = {STS_REG_ID, 1};
  uint8_t idNow[1] = {0};
  bool ok = busTransact(*s, to, STS_READ, qId, 2, idNow, 1, &err, &garbled) == 1 && idNow[0] == to;
  bool oldGone = busTransact(*s, from, STS_PING, nullptr, 0, out, 2, &err, &garbled) < 0 && !garbled;
  Serial.print(ok && oldGone ? "BUS SETID ok " : "BUS SETID FAILED ");
  Serial.print(from);  Serial.print(" -> ");  Serial.print(to);
  Serial.print(" (reads back id=");  Serial.print(idNow[0]);
  Serial.print(", old id ");  Serial.print(oldGone ? "silent" : "STILL ANSWERS");
  Serial.println(")");
}

// ---------------------------------------------------------------------------
// Arms — position control for the control panel
// ---------------------------------------------------------------------------
// Two ElRobot followers on one bus: L = IDs 1..8, R = IDs 11..18, base to
// gripper. Commands: "ARM <L|R> STATE | TORQUE ON | TORQUE OFF | SPEED <n> |
// MOVE <joint 1-8> <pos 0-4095> | CALIBRATE <joint> <mid> <half> |
// MULTITURN | RANGE <joint> <lo> <hi>".
//
// Two frames (log 028):
//   * The servo's own position, signed. Each servo's encoder rolls over at a
//     physical point that, on most of these joints, sits inside the joint's
//     travel. In single-turn mode the servo can never drive through it and
//     takes the long way round into its end stop instead. Multi-turn mode
//     (Phase bit 4 on, servo angle limits 0/0) counts straight through it.
//   * The display position: the servo's position mod 4096. After calibration
//     each joint's travel is one contiguous stretch of it, centred on 2048.
//     That is what the panel shows and sends.
// A move is sent as "this far from where the servo is now":
//   goal = present + (target - present display)
// which takes the physical short path from any starting count, including after
// a power cycle resets the servo's turn count.
//
// With the servos' own limits at 0/0, each joint's limits live here, in the
// Teensy's EEPROM, one record per servo ID.
//
// Guard rails:
//   * MOVE is refused while that arm's torque is off, for a joint not in
//     multi-turn mode, outside the joint's limits, or (uncalibrated joint)
//     more than half a turn away.
//   * TORQUE ON writes each joint's present position as its goal before
//     enabling it, and reads back that torque really came on.
//   * Strength (the servos' torque limit) starts at 300/1000, ElRobot's value
//     while exploring a joint's range, and is set per arm with STRENGTH
//     (100-1000). 30% cannot hold the joints that carry the arm (log 028).
//     Speed starts at 400 steps/s (about 35 deg/s).
//   * A watchdog resets any holding joint whose goal is more than half a turn
//     from where it is.
// TORQUE OFF releases all eight joints of that arm: the panel's emergency stop.

const uint8_t  ARM_PORT = 7, ARM_JOINTS = 8;
const uint8_t  STS_REG_ACC = 41, STS_REG_GOAL = 42, STS_REG_TORQUE_LIMIT = 48;   // goal block starts at ACC
const uint8_t  STS_REG_MIN_LIMIT = 9;          // min u16, then max u16 at 11
const uint8_t  STS_REG_PHASE = 18, STS_REG_OFFSET = 31, STS_REG_MODE = 33;
const uint8_t  ARM_ACC = 50;
const int      ARM_SEAM_LIMIT = 2048;          // half a turn
const int      ARM_CAL_MARGIN = 30;            // steps (about 2.6 deg) kept clear of each recorded end stop
const uint32_t ARM_WATCH_MS = 200;
const int      RANGE_EEPROM_BASE = 256;        // 8 bytes per servo ID
uint32_t armLastWatch = 0;

// 2026-11-06: the arm with servos 1-8 is mounted on the robot's right and 11-18 on
// its left, so the sides are relabelled here. Joint limits are stored per servo ID,
// and calibration offsets live in the servos, so both follow their arm unchanged.
Arm arms[2] = {{'L', 11, false, 400, 300, 0}, {'R', 1, false, 400, 300, 0}};

Arm *armBySide(char c) {
  if (c == 'L') return &arms[0];
  if (c == 'R') return &arms[1];
  return nullptr;
}

int mod4096(int v) { return ((v % 4096) + 4096) % 4096; }
int decodeSigned15(uint16_t v) { return (v & 0x8000) ? -(int)(v & 0x7FFF) : (int)(v & 0x7FFF); }
uint16_t encodeSigned15(int v) { return v < 0 ? (uint16_t)(0x8000 | (-v & 0x7FFF)) : (uint16_t)(v & 0x7FFF); }
int decodeOffset(uint16_t v) { return (v & 0x800) ? -(int)(v & 0x7FF) : (int)(v & 0x7FF); }
uint16_t encodeOffset(int o) { return (uint16_t)((o < 0 ? 0x800 : 0) | (abs(o) & 0x7FF)); }

// --- joint limits, in the Teensy's EEPROM --------------------------------
// Record per servo ID: magic 0xC7, lo u16, hi u16, checksum. Missing or
// damaged records read as uncalibrated, 0..4095.
void rangeLoad(uint8_t id, int16_t *lo, int16_t *hi) {
  int addr = RANGE_EEPROM_BASE + id * 8;
  uint8_t b[6];
  for (int i = 0; i < 6; i++) b[i] = EEPROM.read(addr + i);
  uint8_t sum = (b[0] + b[1] + b[2] + b[3] + b[4]) & 0xFF;
  int l = b[1] | (b[2] << 8), h = b[3] | (b[4] << 8);
  if (b[0] == 0xC7 && b[5] == sum && l >= 0 && h <= 4095 && l < h) {
    *lo = l;
    *hi = h;
  } else {
    *lo = 0;
    *hi = 4095;
  }
}

void rangeSave(uint8_t id, int lo, int hi) {
  int addr = RANGE_EEPROM_BASE + id * 8;
  uint8_t b[6] = {0xC7, (uint8_t)(lo & 0xFF), (uint8_t)(lo >> 8), (uint8_t)(hi & 0xFF), (uint8_t)(hi >> 8), 0};
  b[5] = (b[0] + b[1] + b[2] + b[3] + b[4]) & 0xFF;
  for (int i = 0; i < 6; i++) EEPROM.update(addr + i, b[i]);
}

void armLoadRanges() {
  for (Arm &a : arms)
    for (uint8_t j = 0; j < ARM_JOINTS; j++) rangeLoad(a.firstId + j, &a.lo[j], &a.hi[j]);
}

bool armCalibrated(const Arm &a, uint8_t j) { return !(a.lo[j] == 0 && a.hi[j] == 4095); }

// --- bus helpers -----------------------------------------------------------
HardwareSerial *armBus() {
  HardwareSerial *s = busPort(ARM_PORT);
  if (!busOpened[ARM_PORT]) {
    s->begin(BUS_BAUD);
    busOpened[ARM_PORT] = true;
  }
  return s;
}

// The power pack's voltage, as measured by the servos it feeds (register 62, 0.1 V steps).
// Fallback for the A0 voltage sensor: batteryMainV uses A0 when it reads a real voltage and
// this otherwise (log 055: on 2026-11-05 the sensor's input got no 12 V; it was rewired to the
// motor pack on 11-06, log 056). The neck servos are asked first: they are idle most of the
// time, so their reading is the least sagged. 0 when no servo answers.
const uint8_t STS_REG_VOLT = 62;
const uint8_t PACK_VOLT_IDS[] = {21, 22, 1, 11};
const uint32_t PACK_READ_MS = 5000;
void readPackVoltage() {
  HardwareSerial &s = *armBus();
  for (uint8_t id : PACK_VOLT_IDS) {
    uint8_t v;
    if (busReadBytes(s, id, STS_REG_VOLT, 1, &v) && v > 0) {
      powerPackV = v / 10.0;
      powerPackId = id;
      return;
    }
  }
  powerPackV = 0.0;
  powerPackId = 0;
}

bool busWrite(HardwareSerial &s, uint8_t id, const uint8_t *params, uint8_t np) {
  uint8_t out[2], err;
  bool garbled;
  return busTransact(s, id, STS_WRITE, params, np, out, 2, &err, &garbled) >= 0;
}

bool busReadBytes(HardwareSerial &s, uint8_t id, uint8_t addr, uint8_t n, uint8_t *out) {
  const uint8_t q[2] = {addr, n};
  uint8_t err;
  bool garbled;
  return busTransact(s, id, STS_READ, q, 2, out, n, &err, &garbled) == n;
}

// The servo's own position, signed: in multi-turn mode it counts past 4095
// and below 0. In single-turn mode it is 0..4095 and this reads the same.
bool readPos(HardwareSerial &s, uint8_t id, int *pos) {
  uint8_t out[2];
  if (!busReadBytes(s, id, STS_REG_PRESENT, 2, out)) return false;
  *pos = decodeSigned15(out[0] | (out[1] << 8));
  return true;
}

bool isMultiturn(HardwareSerial &s, uint8_t id) {
  uint8_t ph[1], lim[4];
  return busReadBytes(s, id, STS_REG_PHASE, 1, ph) && busReadBytes(s, id, STS_REG_MIN_LIMIT, 4, lim) &&
         (ph[0] & 0x10) && !lim[0] && !lim[1] && !lim[2] && !lim[3];
}

// Acceleration, goal (signed), goal time 0, goal speed — one write, as the
// Feetech SDK's WritePosEx does it.
bool armWriteGoal(HardwareSerial &s, uint8_t id, int goal, uint16_t speed) {
  uint16_t g = encodeSigned15(constrain(goal, -30719, 30719));
  const uint8_t p[8] = {STS_REG_ACC, ARM_ACC, (uint8_t)(g & 0xFF), (uint8_t)(g >> 8),
                        0, 0, (uint8_t)(speed & 0xFF), (uint8_t)(speed >> 8)};
  return busWrite(s, id, p, 8);
}

// A write's status reply only says the packet arrived. Torque is read back:
// the first multi-turn test showed a torque write can simply not happen.
bool armSetTorque(HardwareSerial &s, uint8_t id, bool on) {
  const uint8_t p[2] = {STS_REG_TORQUE_ENABLE, (uint8_t)(on ? 1 : 0)};
  for (int attempt = 0; attempt < 3; attempt++) {
    busWrite(s, id, p, 2);
    uint8_t te[1];
    if (busReadBytes(s, id, STS_REG_TORQUE_ENABLE, 1, te) && te[0] == (on ? 1 : 0)) return true;
    delay(5);
  }
  return false;
}

// Offset, Phase and angle limits go to the servo's EEPROM. Each write is
// spaced out and the registers are read back; up to three attempts. limits
// 0/0 together with Phase bit 4 is multi-turn mode.
bool servoWriteConfig(HardwareSerial &s, uint8_t id, int ofs, uint8_t phase, int lo, int hi) {
  uint16_t v = encodeOffset(ofs);
  const uint8_t unlock[2] = {STS_REG_LOCK, 0};
  const uint8_t wofs[3] = {STS_REG_OFFSET, (uint8_t)(v & 0xFF), (uint8_t)(v >> 8)};
  const uint8_t wph[2] = {STS_REG_PHASE, phase};
  const uint8_t wlim[5] = {STS_REG_MIN_LIMIT, (uint8_t)(lo & 0xFF), (uint8_t)(lo >> 8),
                           (uint8_t)(hi & 0xFF), (uint8_t)(hi >> 8)};
  const uint8_t lock[2] = {STS_REG_LOCK, 1};
  for (int attempt = 0; attempt < 3; attempt++) {
    busWrite(s, id, unlock, 2);  delay(15);
    busWrite(s, id, wofs, 3);    delay(15);
    busWrite(s, id, wph, 2);     delay(15);
    busWrite(s, id, wlim, 5);    delay(15);
    busWrite(s, id, lock, 2);    delay(15);
    uint8_t o[2], ph[1], l[4];
    if (busReadBytes(s, id, STS_REG_OFFSET, 2, o) && busReadBytes(s, id, STS_REG_PHASE, 1, ph) &&
        busReadBytes(s, id, STS_REG_MIN_LIMIT, 4, l) &&
        (uint16_t)(o[0] | (o[1] << 8)) == v && ph[0] == phase &&
        (l[0] | (l[1] << 8)) == lo && (l[2] | (l[3] << 8)) == hi)
      return true;
  }
  return false;
}

// --- commands ----------------------------------------------------------------
void armState(Arm &a) {
  HardwareSerial &s = *armBus();
  int pos[ARM_JOINTS], load[ARM_JOINTS], temp[ARM_JOINTS], seam[ARM_JOINTS];
  int lmin[ARM_JOINTS], lmax[ARM_JOINTS], mt[ARM_JOINTS];
  uint8_t torqued = 0;
  for (uint8_t j = 0; j < ARM_JOINTS; j++) {
    uint8_t id = a.firstId + j;
    // Torque as the servos report it, not as this firmware remembers it: a
    // reboot or reflash forgets, while the servos keep holding.
    uint8_t te[1];
    if (busReadBytes(s, id, STS_REG_TORQUE_ENABLE, 1, te) && te[0]) torqued++;
    uint8_t out[8];
    if (busReadBytes(s, id, STS_REG_PRESENT, 8, out)) {
      pos[j] = mod4096(decodeSigned15(out[0] | (out[1] << 8)));
      load[j] = ((out[4] | (out[5] << 8)) & 0x3FF) / 10;   // magnitude, percent
      temp[j] = out[7];
      mt[j] = isMultiturn(s, id) ? 1 : 0;
    } else {
      pos[j] = load[j] = temp[j] = mt[j] = -1;
    }
    seam[j] = (a.seamTrips >> j) & 1;
    lmin[j] = a.lo[j];
    lmax[j] = a.hi[j];
  }
  a.seamTrips = 0;                    // reported once
  a.torque = torqued == ARM_JOINTS;
  Serial.print("ARM ");  Serial.print(a.side);
  Serial.print(" STATE torque=");  Serial.print(a.torque ? 1 : 0);
  Serial.print(" speed=");         Serial.print(a.speed);
  Serial.print(" strength=");      Serial.print(a.strength);
  const char *names[7] = {" pos=", " load=", " temp=", " seam=", " min=", " max=", " mt="};
  int *cols[7] = {pos, load, temp, seam, lmin, lmax, mt};
  for (uint8_t c = 0; c < 7; c++) {
    Serial.print(names[c]);
    for (uint8_t j = 0; j < ARM_JOINTS; j++) {
      if (j) Serial.print(",");
      Serial.print(cols[c][j]);
    }
  }
  Serial.println();
}

void armTorqueCmd(Arm &a, bool on) {
  HardwareSerial &s = *armBus();
  Serial.print("ARM ");  Serial.print(a.side);
  if (!on) {
    uint8_t ok = 0;
    for (uint8_t j = 0; j < ARM_JOINTS; j++) ok += armSetTorque(s, a.firstId + j, false);
    a.torque = false;
    Serial.print(" TORQUE off ok=");  Serial.println(ok);
    return;
  }
  // Every joint must answer before any of them gets torque.
  int pos[ARM_JOINTS];
  for (uint8_t j = 0; j < ARM_JOINTS; j++) {
    if (!readPos(s, a.firstId + j, &pos[j])) {
      Serial.print(" TORQUE refused: J");  Serial.print(j + 1);
      Serial.println(" did not answer");
      return;
    }
  }
  const uint8_t lim[3] = {STS_REG_TORQUE_LIMIT, (uint8_t)(a.strength & 0xFF),
                          (uint8_t)(a.strength >> 8)};
  uint8_t ok = 0;
  String failed;
  for (uint8_t j = 0; j < ARM_JOINTS; j++) {
    uint8_t id = a.firstId + j;
    busWrite(s, id, lim, 3);
    if (armWriteGoal(s, id, pos[j], a.speed) && armSetTorque(s, id, true)) ok++;
    else failed += " J" + String(j + 1);
  }
  a.torque = ok == ARM_JOINTS;
  Serial.print(" TORQUE on ok=");  Serial.print(ok);
  if (failed.length()) { Serial.print(" failed:");  Serial.print(failed); }
  Serial.println();
}

// Torque limit for every joint of the arm, applied at once (the register is in
// RAM, so this wears nothing) and used by every later TORQUE ON.
void armStrength(Arm &a, int value) {
  a.strength = constrain(value, 100, 1000);
  HardwareSerial &s = *armBus();
  const uint8_t lim[3] = {STS_REG_TORQUE_LIMIT, (uint8_t)(a.strength & 0xFF), (uint8_t)(a.strength >> 8)};
  uint8_t ok = 0;
  for (uint8_t j = 0; j < ARM_JOINTS; j++) ok += busWrite(s, a.firstId + j, lim, 3);
  Serial.print("ARM ");          Serial.print(a.side);
  Serial.print(" STRENGTH ");    Serial.print(a.strength);
  Serial.print(" applied=");     Serial.println(ok);
}

void armMove(Arm &a, int joint, int target) {
  Serial.print("ARM ");  Serial.print(a.side);
  if (joint < 1 || joint > ARM_JOINTS || target < 0 || target > 4095) {
    Serial.println(" MOVE refused: usage MOVE <joint 1-8> <pos 0-4095>");
    return;
  }
  HardwareSerial &s = *armBus();
  uint8_t j = joint - 1, id = a.firstId + j;
  int now;
  if (!readPos(s, id, &now)) {
    Serial.print(" MOVE refused: J");  Serial.print(joint);  Serial.println(" did not answer");
    return;
  }
  int nowD = mod4096(now);
  if (!isMultiturn(s, id)) {
    Serial.print(" MOVE refused: J");  Serial.print(joint);
    Serial.println(" is not in multi-turn mode; run ARM MULTITURN");
    return;
  }
  if (armCalibrated(a, j)) {
    if (target < a.lo[j] || target > a.hi[j]) {
      Serial.print(" MOVE refused: J");  Serial.print(joint);
      Serial.print(" range is ");        Serial.print(a.lo[j]);
      Serial.print("..");                Serial.println(a.hi[j]);
      return;
    }
  } else if (abs(target - nowD) > ARM_SEAM_LIMIT) {
    Serial.print(" MOVE refused: J");     Serial.print(joint);
    Serial.print(" is at ");               Serial.print(nowD);
    Serial.print(", and ");                Serial.print(target);
    Serial.println(" is more than half a turn away. Calibrate the arm, or move in two steps");
    return;
  }
  if (!a.torque) {
    Serial.println(" MOVE refused: torque is off");
    return;
  }
  bool ok = armWriteGoal(s, id, now + (target - nowD), a.speed);
  Serial.print(" MOVE joint=");  Serial.print(joint);
  Serial.print(" goal=");        Serial.print(target);
  Serial.println(ok ? " ok" : " failed");
}

// Calibrate one joint from a range recorded by hand on the panel. `mid` is the
// middle of the recorded range and `half` half its span, in display readings.
// Afterwards the middle reads 2048, the limits 2048 +/- (half - margin) are
// stored in the Teensy, and the servo is in multi-turn mode. The display
// reading must move by exactly the offset change; otherwise everything goes
// back.
void armCalibrate(Arm &a, int joint, int mid, int half) {
  Serial.print("ARM ");  Serial.print(a.side);
  if (joint < 1 || joint > ARM_JOINTS || mid < 0 || mid > 4095 || half < 100 || half > 2047) {
    Serial.println(" CALIBRATE refused: usage CALIBRATE <joint 1-8> <mid 0-4095> <half 100-2047>");
    return;
  }
  HardwareSerial &s = *armBus();
  uint8_t j = joint - 1, id = a.firstId + j;
  uint8_t te[1], o[2], ph[1], l[4];
  int now;
  if (!busReadBytes(s, id, STS_REG_TORQUE_ENABLE, 1, te) || te[0] != 0) {
    Serial.print(" CALIBRATE refused: J");  Serial.print(joint);
    Serial.println(" must be answering with torque off");
    return;
  }
  if (!busReadBytes(s, id, STS_REG_OFFSET, 2, o) || !busReadBytes(s, id, STS_REG_PHASE, 1, ph) ||
      !busReadBytes(s, id, STS_REG_MIN_LIMIT, 4, l) || !readPos(s, id, &now)) {
    Serial.println(" CALIBRATE refused: could not read the joint's current calibration");
    return;
  }
  int oldOfs = decodeOffset(o[0] | (o[1] << 8));
  uint8_t oldPhase = ph[0];
  int oldLo = l[0] | (l[1] << 8), oldHi = l[2] | (l[3] << 8);
  int16_t oldRangeLo = a.lo[j], oldRangeHi = a.hi[j];

  int newOfs = oldOfs + (mid - 2048);
  while (newOfs > 2047) newOfs -= 4096;
  while (newOfs < -2047) newOfs += 4096;
  int lo = max(0, 2048 - half + ARM_CAL_MARGIN);
  int hi = min(4095, 2048 + half - ARM_CAL_MARGIN);

  if (!servoWriteConfig(s, id, newOfs, oldPhase | 0x10, 0, 0)) {
    bool restored = servoWriteConfig(s, id, oldOfs, oldPhase, oldLo, oldHi);
    Serial.print(" CALIBRATE FAILED J");  Serial.print(joint);
    Serial.print(": the servo did not keep the new settings; old ones ");
    Serial.println(restored ? "restored" : "NOT confirmed restored");
    return;
  }
  int expected = mod4096(mod4096(now) - (newOfs - oldOfs));
  int after = -1;
  bool landed = false;
  for (int t = 0; t < 25 && !landed; t++) {      // the servo applies an offset with a delay
    delay(20);
    if (!readPos(s, id, &after)) continue;
    int diff = mod4096(mod4096(after) - expected);
    landed = diff <= 15 || diff >= 4096 - 15;     // the arm may shift a hair while held
  }
  if (!landed) {
    bool restored = servoWriteConfig(s, id, oldOfs, oldPhase, oldLo, oldHi);
    Serial.print(" CALIBRATE FAILED J");  Serial.print(joint);
    Serial.print(": reading went ");      Serial.print(mod4096(now));
    Serial.print(" -> ");                 Serial.print(mod4096(after));
    Serial.print(", expected ");          Serial.print(expected);
    Serial.print("; old settings ");
    Serial.println(restored ? "restored" : "NOT confirmed restored");
    a.lo[j] = oldRangeLo;
    a.hi[j] = oldRangeHi;
    return;
  }
  rangeSave(id, lo, hi);
  a.lo[j] = lo;
  a.hi[j] = hi;
  Serial.print(" CALIBRATE joint=");  Serial.print(joint);
  Serial.print(" ok offset=");        Serial.print(oldOfs);
  Serial.print("->");                 Serial.print(newOfs);
  Serial.print(" limits=");           Serial.print(lo);
  Serial.print("..");                 Serial.print(hi);
  Serial.print(" reading=");          Serial.print(mod4096(now));
  Serial.print("->");                 Serial.println(mod4096(after));
}

// Switch every joint of an arm to multi-turn mode, keeping its offset. A
// joint calibrated the old way has its limits in the servo; those move to the
// Teensy's EEPROM first, then the servo's limits go to 0/0. Joints must be
// limp. Joints already in multi-turn mode are left alone.
void armMultiturn(Arm &a) {
  HardwareSerial &s = *armBus();
  uint8_t done = 0;
  for (uint8_t j = 0; j < ARM_JOINTS; j++) {
    uint8_t id = a.firstId + j;
    Serial.print("ARM ");  Serial.print(a.side);
    Serial.print(" MULTITURN J");  Serial.print(j + 1);
    uint8_t te[1], o[2], ph[1], l[4];
    if (!busReadBytes(s, id, STS_REG_TORQUE_ENABLE, 1, te) || !busReadBytes(s, id, STS_REG_OFFSET, 2, o) ||
        !busReadBytes(s, id, STS_REG_PHASE, 1, ph) || !busReadBytes(s, id, STS_REG_MIN_LIMIT, 4, l)) {
      Serial.println(" skipped: no reply");
      continue;
    }
    if (te[0]) {
      Serial.println(" skipped: torque is on");
      continue;
    }
    int ofs = decodeOffset(o[0] | (o[1] << 8));
    int lo = l[0] | (l[1] << 8), hi = l[2] | (l[3] << 8);
    if ((ph[0] & 0x10) && lo == 0 && hi == 0) {
      Serial.println(" already multi-turn");
      done++;
      continue;
    }
    if (!(lo == 0 && hi == 4095) && lo < hi) {    // calibrated the old way: keep its range
      rangeSave(id, lo, hi);
      a.lo[j] = lo;
      a.hi[j] = hi;
    }
    if (servoWriteConfig(s, id, ofs, ph[0] | 0x10, 0, 0)) {
      done++;
      Serial.print(" ok range=");  Serial.print(a.lo[j]);
      Serial.print("..");          Serial.println(a.hi[j]);
    } else {
      bool restored = servoWriteConfig(s, id, ofs, ph[0], lo, hi);
      Serial.print(" FAILED; old settings ");
      Serial.println(restored ? "restored" : "NOT confirmed restored");
    }
  }
  Serial.print("ARM ");  Serial.print(a.side);
  Serial.print(" MULTITURN done ok=");  Serial.println(done);
}

void armRange(Arm &a, int joint, int lo, int hi) {
  Serial.print("ARM ");  Serial.print(a.side);
  if (joint < 1 || joint > ARM_JOINTS || lo < 0 || hi > 4095 || hi - lo < 100) {
    Serial.println(" RANGE refused: usage RANGE <joint 1-8> <lo> <hi>, 0..4095, at least 100 apart");
    return;
  }
  rangeSave(a.firstId + joint - 1, lo, hi);
  a.lo[joint - 1] = lo;
  a.hi[joint - 1] = hi;
  Serial.print(" RANGE joint=");  Serial.print(joint);
  Serial.print(" ");              Serial.print(lo);
  Serial.print("..");             Serial.print(hi);
  Serial.println(" ok");
}

void armWatchdog() {
  if (millis() - armLastWatch < ARM_WATCH_MS) return;
  armLastWatch = millis();
  for (Arm &a : arms) {
    if (!a.torque) continue;
    HardwareSerial &s = *armBus();
    for (uint8_t j = 0; j < ARM_JOINTS; j++) {
      uint8_t id = a.firstId + j;
      uint8_t g[2];
      int now;
      if (!busReadBytes(s, id, STS_REG_GOAL, 2, g) || !readPos(s, id, &now)) continue;
      int goal = decodeSigned15(g[0] | (g[1] << 8));
      if (abs(goal - now) <= ARM_SEAM_LIMIT) continue;
      armWriteGoal(s, id, now, a.speed);
      a.seamTrips |= 1 << j;
      Serial.print("ARM ");          Serial.print(a.side);
      Serial.print(" SEAM joint=");  Serial.print(j + 1);
      Serial.print(" present=");     Serial.print(now);
      Serial.print(" goal=");        Serial.print(goal);
      Serial.println(" -> now holding at present");
    }
  }
}

// --- diagnostics (log 028's multi-turn experiment) ----------------------------
// BUS POS reads one servo's position as signed. BUS WRITE changes configuration
// registers only, and only with that servo's torque off, so it cannot move
// anything. JOINT TEST moves one multi-turn joint by a small delta at 25%
// torque, prints where it goes, and switches torque off by itself.

bool isConfigRegister(int addr) {
  return (addr >= STS_REG_MIN_LIMIT && addr <= STS_REG_MIN_LIMIT + 3) ||
         addr == STS_REG_PHASE || addr == STS_REG_MODE || addr == STS_REG_LOCK;
}

void busPos(int id) {
  uint8_t out[2];
  if (id < 0 || id > 252 || !busReadBytes(*armBus(), id, STS_REG_PRESENT, 2, out)) {
    Serial.println("BUS POS no reply");
    return;
  }
  uint16_t raw = out[0] | (out[1] << 8);
  Serial.print("BUS POS id=");  Serial.print(id);
  Serial.print(" raw=0x");      Serial.print(raw, HEX);
  Serial.print(" signed=");     Serial.print(decodeSigned15(raw));
  Serial.print(" mod4096=");    Serial.println(mod4096(decodeSigned15(raw)));
}

void busWriteConfig(int id, int addr, const int *vals, int n) {
  HardwareSerial &s = *armBus();
  bool okRange = n >= 1 && addr >= 0 && addr + n - 1 <= 255;
  for (int i = 0; okRange && i < n; i++) okRange = isConfigRegister(addr + i) && vals[i] >= 0 && vals[i] <= 255;
  if (id < 0 || id > 252 || !okRange) {
    Serial.println("BUS WRITE refused: config registers only (9-12, 18, 33, 55), bytes 0-255");
    return;
  }
  uint8_t te[1];
  if (!busReadBytes(s, id, STS_REG_TORQUE_ENABLE, 1, te) || te[0] != 0) {
    Serial.println("BUS WRITE refused: the servo must answer with torque off");
    return;
  }
  uint8_t p[6];
  p[0] = addr;
  for (int i = 0; i < n; i++) p[1 + i] = vals[i];
  bool ok = busWrite(s, id, p, 1 + n);
  delay(15);
  Serial.print("BUS WRITE id=");  Serial.print(id);
  Serial.print(" addr=");         Serial.print(addr);
  Serial.println(ok ? " ok" : " failed");
}

void jointTest(int id, int delta) {
  HardwareSerial &s = *armBus();
  if (id < 0 || id > 252 || delta == 0 || abs(delta) > 400) {
    Serial.println("TEST refused: usage JOINT TEST <id> <delta, |delta| 1-400>");
    return;
  }
  if (!isMultiturn(s, id)) {
    Serial.println("TEST refused: not in multi-turn mode (Phase bit 4 and limits 0/0)");
    return;
  }
  int p0;
  if (!readPos(s, id, &p0)) {
    Serial.println("TEST refused: no position reply");
    return;
  }
  int goal = constrain(p0 + delta, -30719, 30719);
  const uint8_t tlim[3] = {STS_REG_TORQUE_LIMIT, 250, 0};            // 25 %
  busWrite(s, id, tlim, 3);
  armWriteGoal(s, id, goal, 300);       // goal first, then torque: no stale-goal jump
  bool on = armSetTorque(s, id, true);
  Serial.print("TEST id=");  Serial.print(id);
  Serial.print(" start=");   Serial.print(p0);
  Serial.print(" goal=");    Serial.print(goal);
  Serial.print(" torque=");  Serial.println(on ? 1 : 0);
  int last = p0;
  for (int t = 1; t <= 25; t++) {
    delay(100);
    uint8_t out[11];                    // position .. moving flag (66)
    if (!busReadBytes(s, id, STS_REG_PRESENT, 11, out)) continue;
    last = decodeSigned15(out[0] | (out[1] << 8));
    Serial.print("TEST t=");    Serial.print(t * 100);
    Serial.print("ms pos=");    Serial.print(last);
    Serial.print(" load=");     Serial.print(((out[4] | (out[5] << 8)) & 0x3FF) / 10);
    Serial.print("% status=");  Serial.print(out[9]);
    Serial.print(" moving=");   Serial.println(out[10]);
  }
  armSetTorque(s, id, false);
  Serial.print("TEST done id=");  Serial.print(id);
  Serial.print(" start=");        Serial.print(p0);
  Serial.print(" goal=");         Serial.print(goal);
  Serial.print(" final=");        Serial.print(last);
  Serial.print(abs(last - goal) <= 20 ? " REACHED" : " NOT reached");
  Serial.println(" (torque off)");
}

void armCommand(Arm &a, const char *rest) {
  if (strcmp(rest, "STATE") == 0) {
    armState(a);
  } else if (strcmp(rest, "TORQUE ON") == 0) {
    armTorqueCmd(a, true);
  } else if (strcmp(rest, "TORQUE OFF") == 0) {
    armTorqueCmd(a, false);
  } else if (strcmp(rest, "MULTITURN") == 0) {
    armMultiturn(a);
  } else if (strncmp(rest, "SPEED ", 6) == 0) {
    a.speed = constrain(atoi(rest + 6), 50, 3000);
    Serial.print("ARM ");  Serial.print(a.side);
    Serial.print(" SPEED ");  Serial.println(a.speed);
  } else if (strncmp(rest, "STRENGTH ", 9) == 0) {
    armStrength(a, atoi(rest + 9));
  } else if (strncmp(rest, "CALIBRATE ", 10) == 0) {
    int joint = -1, mid = -1, half = -1;
    sscanf(rest + 10, "%d %d %d", &joint, &mid, &half);
    armCalibrate(a, joint, mid, half);
  } else if (strncmp(rest, "RANGE ", 6) == 0) {
    int joint = -1, lo = -1, hi = -1;
    sscanf(rest + 6, "%d %d %d", &joint, &lo, &hi);
    armRange(a, joint, lo, hi);
  } else if (strncmp(rest, "MOVE ", 5) == 0) {
    int joint = -1, pos = -1;
    sscanf(rest + 5, "%d %d", &joint, &pos);
    armMove(a, joint, pos);
  } else {
    Serial.print("ERR arm_command ");  Serial.println(rest);
  }
}

// ---------------------------------------------------------------------------
// Drive motors, encoders and ultrasonic sensors — bring-up test (log 046)
// ---------------------------------------------------------------------------
// Two IBT-2 (BTS7960) bridges and the 36GP-555 Hall encoders, on the pins in
// the inventory's pin map. R_EN and L_EN are joined on each board and held low
// by a 10 k pull-down, so a bridge stays off until its EN pin is driven high.
//
// These are test limits, not driving limits: duty is capped at
// DRIVE_TEST_MAX_PCT, and every run stops by itself within DRIVE_TEST_MAX_MS.
// Run them with the wheels off the ground.

QuadEncoder encLeft(1, 30, 31, 1);    // hardware channel 1, 22 k pull-ups
QuadEncoder encRight(2, 0, 1, 1);     // channel 2; Serial1 is free since the lidar moved to USB

Drive drives[2] = {
  {"L", 5, 6, 7, encLeft, false, 0, 0, 0, 0, 0},
  {"R", 22, 23, 21, encRight, false, 0, 0, 0, 0, 0},
};

const int      DRIVE_PWM_HZ = 20000;      // inaudible, under the BTS7960's 25 kHz limit
const int      DRIVE_TEST_MAX_PCT = 30;
const uint32_t DRIVE_TEST_MAX_MS = 3000;
const int      DRIVE_RAMP_PER_MS = 4;     // 12-bit counts: 0 -> 30 % in about 0.3 s
uint32_t lastDriveUpdate = 0;
uint32_t encWatchUntil = 0, lastEncWatch = 0;

// Called first in setup(). With the pull-downs fitted this is belt and braces;
// without them it is the only thing holding the bridges off.
void driveSafePins() {
  for (Drive &d : drives) {
    pinMode(d.en, OUTPUT);    digitalWrite(d.en, LOW);
    pinMode(d.rpwm, OUTPUT);  digitalWrite(d.rpwm, LOW);
    pinMode(d.lpwm, OUTPUT);  digitalWrite(d.lpwm, LOW);
  }
}

void driveSetup() {
  for (Drive &d : drives) {
    analogWriteFrequency(d.rpwm, DRIVE_PWM_HZ);
    analogWriteFrequency(d.lpwm, DRIVE_PWM_HZ);
    analogWrite(d.rpwm, 0);
    analogWrite(d.lpwm, 0);
    d.enc.setInitConfig();
    d.enc.EncConfig.filterCount = 5;          // ignore glitches shorter than about 1 us
    d.enc.EncConfig.filterSamplePeriod = 20;  // (motor PWM noise); real edges are 100s of us apart
    d.enc.init();
  }
}

// Never both PWM pins high: that would brake the motor through the high sides.
void driveApply(Drive &d) {
  analogWrite(d.rpwm, d.duty > 0 ? d.duty : 0);
  analogWrite(d.lpwm, d.duty < 0 ? -d.duty : 0);
}

void driveStop(Drive &d, const char *why) {
  bool was = d.running;
  d.running = false;
  d.targetDuty = d.duty = 0;
  driveApply(d);
  digitalWrite(d.en, LOW);
  if (!was) return;
  Serial.print("MOTOR ");         Serial.print(d.name);
  Serial.print(" stopped=");      Serial.print(why);
  Serial.print(" ran_ms=");       Serial.print(millis() - d.startedAt);
  Serial.print(" enc_delta=");    Serial.println(d.enc.read() - d.encAtStart);
}

void driveStart(Drive &d, int pct, int ms) {
  if (pct == 0 || abs(pct) > DRIVE_TEST_MAX_PCT || ms <= 0 || ms > (int)DRIVE_TEST_MAX_MS) {
    Serial.print("MOTOR ERR range: percent -");  Serial.print(DRIVE_TEST_MAX_PCT);
    Serial.print("..");                          Serial.print(DRIVE_TEST_MAX_PCT);
    Serial.print(" (not 0), ms 1..");            Serial.println(DRIVE_TEST_MAX_MS);
    return;
  }
  driveStop(d, "replaced");
  d.targetDuty = pct * 4095 / 100;
  d.encAtStart = d.enc.read();
  d.startedAt = millis();
  d.stopAt = d.startedAt + ms;
  d.running = true;
  digitalWrite(d.en, HIGH);
  Serial.print("MOTOR ");       Serial.print(d.name);
  Serial.print(" start percent=");  Serial.print(pct);
  Serial.print(" ms=");         Serial.println(ms);
}

void driveUpdate() {
  uint32_t now = millis();
  if (now == lastDriveUpdate) return;
  int step = DRIVE_RAMP_PER_MS * (int)(now - lastDriveUpdate);
  lastDriveUpdate = now;
  for (Drive &d : drives) {
    if (!d.running) continue;
    if ((int32_t)(now - d.stopAt) >= 0) { driveStop(d, "time"); continue; }
    int next = d.duty < d.targetDuty ? min(d.duty + step, d.targetDuty)
                                     : max(d.duty - step, d.targetDuty);
    if (next != d.duty) { d.duty = next; driveApply(d); }
  }
}

void sendEnc() {
  Serial.print("ENC L=");  Serial.print(encLeft.read());
  Serial.print(" R=");     Serial.println(encRight.read());
}

// --- Ultrasonic: 4 x HC-SR04P, fired one at a time ---
// One sensor per 60 ms slot: no cross-talk between them, and it is the
// HC-SR04's own minimum cycle. A full sweep takes 240 ms.
const uint8_t SONAR_N = 4;
const char *const SONAR_NAME[SONAR_N] = {"FL", "FR", "BL", "BR"};
const uint8_t SONAR_TRIG[SONAR_N] = {33, 35, 37, 39};
const uint8_t SONAR_ECHO[SONAR_N] = {34, 36, 38, 40};
const uint32_t SONAR_SLOT_MS = 60;
const uint32_t SONAR_MAX_ECHO_US = 25000;   // about 4.3 m; longer means nothing came back
enum SonarState : uint8_t { SONAR_NONE, SONAR_OK, SONAR_FAR, SONAR_SILENT };
volatile uint32_t sonarRiseUs[SONAR_N], sonarFallUs[SONAR_N];
volatile uint8_t sonarEdges[SONAR_N];       // bit 0 = rose, bit 1 = fell
float sonarCm[SONAR_N];
SonarState sonarState[SONAR_N];
uint8_t sonarIdx = 0;
uint32_t sonarSlotStart = 0;
uint32_t sonarWatchUntil = 0, lastSonarWatch = 0;

void sonarEdge(uint8_t i) {
  uint32_t t = micros();
  if (digitalReadFast(SONAR_ECHO[i])) { sonarRiseUs[i] = t; sonarEdges[i] |= 1; }
  else if (sonarEdges[i] & 1)         { sonarFallUs[i] = t; sonarEdges[i] |= 2; }
}
void sonarIsr0() { sonarEdge(0); }
void sonarIsr1() { sonarEdge(1); }
void sonarIsr2() { sonarEdge(2); }
void sonarIsr3() { sonarEdge(3); }
void (*const SONAR_ISR[SONAR_N])() = {sonarIsr0, sonarIsr1, sonarIsr2, sonarIsr3};

void sonarSetup() {
  for (uint8_t i = 0; i < SONAR_N; i++) {
    pinMode(SONAR_TRIG[i], OUTPUT);
    digitalWrite(SONAR_TRIG[i], LOW);
    pinMode(SONAR_ECHO[i], INPUT_PULLDOWN);   // an unpowered or missing sensor reads "silent", not noise
    attachInterrupt(digitalPinToInterrupt(SONAR_ECHO[i]), SONAR_ISR[i], CHANGE);
  }
}

void sonarUpdate() {
  uint32_t now = millis();
  if (sonarSlotStart && now - sonarSlotStart < SONAR_SLOT_MS) return;
  if (sonarSlotStart) {                       // close the slot that just ended
    uint8_t i = sonarIdx;
    noInterrupts();
    uint8_t e = sonarEdges[i];
    uint32_t w = sonarFallUs[i] - sonarRiseUs[i];
    interrupts();
    if (!(e & 1))                              { sonarState[i] = SONAR_SILENT; sonarCm[i] = -1; }
    else if (!(e & 2) || w > SONAR_MAX_ECHO_US) { sonarState[i] = SONAR_FAR;   sonarCm[i] = -1; }
    else                                       { sonarState[i] = SONAR_OK;    sonarCm[i] = w / 58.0f; }
    sonarIdx = (sonarIdx + 1) % SONAR_N;
  }
  uint8_t i = sonarIdx;                        // fire the next one
  sonarEdges[i] = 0;
  digitalWriteFast(SONAR_TRIG[i], HIGH);
  delayMicroseconds(10);
  digitalWriteFast(SONAR_TRIG[i], LOW);
  sonarSlotStart = now ? now : 1;
}

void sendSonar() {
  Serial.print("SONAR");
  for (uint8_t i = 0; i < SONAR_N; i++) {
    Serial.print(' ');  Serial.print(SONAR_NAME[i]);  Serial.print('=');
    switch (sonarState[i]) {
      case SONAR_OK:     Serial.print(sonarCm[i], 1);  Serial.print("cm");  break;
      case SONAR_FAR:    Serial.print("far");     break;    // pulse but no return in range
      case SONAR_SILENT: Serial.print("silent");  break;    // no echo pulse at all: power, TRIG or ECHO wiring
      default:           Serial.print("--");      break;
    }
  }
  Serial.println();
}

// One line with everything the control panel's Drive card shows, so a poll is
// a single round trip. sonar: centimetres, or -1 far, -2 silent, -3 not read yet.
void sendDrive() {
  Serial.print("DRIVE run=");  Serial.print(drives[0].running);  Serial.print(',');  Serial.print(drives[1].running);
  Serial.print(" duty=");      Serial.print(drives[0].duty * 100 / 4095);  Serial.print(',');  Serial.print(drives[1].duty * 100 / 4095);
  Serial.print(" enc=");       Serial.print(encLeft.read());  Serial.print(',');  Serial.print(encRight.read());
  Serial.print(" sonar=");
  for (uint8_t i = 0; i < SONAR_N; i++) {
    if (i) Serial.print(',');
    switch (sonarState[i]) {
      case SONAR_OK:     Serial.print(sonarCm[i], 1);  break;
      case SONAR_FAR:    Serial.print(-1);  break;
      case SONAR_SILENT: Serial.print(-2);  break;
      default:           Serial.print(-3);  break;
    }
  }
  Serial.println();
}

void sendIo() {
  Serial.print("IO en_L(7)=");    Serial.print(digitalRead(7));
  Serial.print(" en_R(21)=");     Serial.print(digitalRead(21));
  for (uint8_t i = 0; i < SONAR_N; i++) {
    Serial.print(" echo_");  Serial.print(SONAR_NAME[i]);
    Serial.print('(');       Serial.print(SONAR_ECHO[i]);  Serial.print(")=");
    Serial.print(digitalRead(SONAR_ECHO[i]));
  }
  Serial.print(" enc_L=");  Serial.print(encLeft.read());
  Serial.print(" enc_R=");  Serial.println(encRight.read());
}

void driveWatchUpdate() {
  uint32_t now = millis();
  if (encWatchUntil && now - lastEncWatch >= 250) {
    lastEncWatch = now;
    sendEnc();
    if ((int32_t)(now - encWatchUntil) >= 0) encWatchUntil = 0;
  }
  if (sonarWatchUntil && now - lastSonarWatch >= 250) {
    lastSonarWatch = now;
    sendSonar();
    if ((int32_t)(now - sonarWatchUntil) >= 0) sonarWatchUntil = 0;
  }
}

void motorCommand(const char *rest) {
  if (strcmp(rest, "STOP") == 0) {
    for (Drive &d : drives) driveStop(d, "command");
    Serial.println("MOTOR stopped");
    return;
  }
  char side = 0;
  int pct = 0, ms = 1000;
  if (sscanf(rest, "%c %d %d", &side, &pct, &ms) < 2 || (side != 'L' && side != 'R')) {
    Serial.println("MOTOR usage: MOTOR <L|R> <percent -30..30> [ms <= 3000] | MOTOR STOP");
    return;
  }
  driveStart(drives[side == 'L' ? 0 : 1], pct, ms);
}

void handleCommand(char *cmd) {
  size_t n = strlen(cmd);
  while (n > 0 && (cmd[n - 1] == '\r' || cmd[n - 1] == ' ')) cmd[--n] = '\0';
  if (n == 0) return;

  if (strcmp(cmd, "PING") == 0) {
    Serial.print("PONG ");  Serial.println(millis());
  } else if (strcmp(cmd, "INFO") == 0) {
    sendInfo();
  } else if (strcmp(cmd, "HEALTH") == 0) {
    sendHealth();
  } else if (strcmp(cmd, "ROS") == 0) {
    sendRos();
  } else if (strcmp(cmd, "BATTERY") == 0) {
    sendBattery();
  } else if (strcmp(cmd, "LIGHT") == 0) {
    sendLight();
  } else if (strcmp(cmd, "CAL dark") == 0) {
    // Cover the sensor, then send this.
    ldrRawDark = analogRead(LDR_PIN);
    Serial.print("CAL dark=");    Serial.println(ldrRawDark);
  } else if (strcmp(cmd, "CAL bright") == 0) {
    // Shine a torch on the sensor, then send this.
    ldrRawBright = analogRead(LDR_PIN);
    Serial.print("CAL bright=");  Serial.println(ldrRawBright);
  } else if (strcmp(cmd, "STRIP") == 0) {
    Serial.println("STRIP usage: STRIP auto | STRIP 0-100");
    sendLight();
  } else if (strncmp(cmd, "STRIP ", 6) == 0) {
    char *p = cmd + 6;
    while (*p == ' ') p++;
    if (strcmp(p, "auto") == 0) {
      stripManual = -1.0;
      Serial.println("STRIP mode=auto");
    } else {
      stripManual = constrain(atoi(p), 0, 100) / 100.0;
      Serial.print("STRIP mode=manual level=");  Serial.println(stripManual, 2);
    }
  } else if (strcmp(cmd, "SERVO") == 0) {
    Serial.println("SERVO usage: SERVO pan=90 tilt=90  (0-180)");
    Serial.print("SERVO current pan="); Serial.print(servoPanPos);
    Serial.print(" tilt="); Serial.println(servoTiltPos);
  } else if (strncmp(cmd, "SERVO ", 6) == 0) {
    // Parse: SERVO pan=90 tilt=80
    char *p = cmd + 6;
    while (*p) {
      if (strncmp(p, "pan=", 4) == 0) {
        servoPanPos = constrain(atoi(p + 4), SERVO_PAN_MIN, SERVO_PAN_MAX);
      } else if (strncmp(p, "tilt=", 5) == 0) {
        servoTiltPos = constrain(atoi(p + 5), SERVO_TILT_MIN, SERVO_TILT_MAX);
      }
      while (*p && *p != ' ') p++;
      while (*p == ' ') p++;
    }
    Serial.print("SERVO set pan="); Serial.print(servoPanPos);
    Serial.print(" tilt="); Serial.println(servoTiltPos);
  } else if (strcmp(cmd, "BUS SCAN") == 0) {
    busScan(7);
  } else if (strncmp(cmd, "BUS SCAN ", 9) == 0) {
    busScan(atoi(cmd + 9));
  } else if (strncmp(cmd, "BUS READ ", 9) == 0) {
    int id = -1, addr = -1, len = -1;
    sscanf(cmd + 9, "%d %d %d", &id, &addr, &len);
    busReadRaw(7, id, addr, len);
  } else if (strncmp(cmd, "ARM ", 4) == 0 && armBySide(cmd[4]) && cmd[5] == ' ') {
    armCommand(*armBySide(cmd[4]), cmd + 6);
  } else if (strncmp(cmd, "BUS POS ", 8) == 0) {
    busPos(atoi(cmd + 8));
  } else if (strncmp(cmd, "BUS WRITE ", 10) == 0) {
    int id = -1, addr = -1, vals[5], n = 0, used = 0;
    const char *p = cmd + 10;
    if (sscanf(p, "%d %d%n", &id, &addr, &used) == 2) {
      p += used;
      while (n < 5 && sscanf(p, "%d%n", &vals[n], &used) == 1) { p += used; n++; }
    }
    busWriteConfig(id, addr, vals, n);
  } else if (strncmp(cmd, "JOINT TEST ", 11) == 0) {
    int id = -1, delta = 0;
    sscanf(cmd + 11, "%d %d", &id, &delta);
    jointTest(id, delta);
  } else if (strncmp(cmd, "BUS SETID ", 10) == 0) {
    int from = -1, to = -1;
    sscanf(cmd + 10, "%d %d", &from, &to);
    busSetId(7, from, to);
  } else if (strcmp(cmd, "MOTOR") == 0 || strncmp(cmd, "MOTOR ", 6) == 0) {
    motorCommand(cmd[5] ? cmd + 6 : "");
  } else if (strcmp(cmd, "ENC") == 0) {
    sendEnc();
  } else if (strcmp(cmd, "ENC ZERO") == 0) {
    encLeft.write(0);
    encRight.write(0);
    sendEnc();
  } else if (strncmp(cmd, "ENC WATCH ", 10) == 0) {
    encWatchUntil = millis() + constrain(atoi(cmd + 10), 1, 60) * 1000UL;
  } else if (strcmp(cmd, "SONAR") == 0) {
    sendSonar();
  } else if (strncmp(cmd, "SONAR WATCH ", 12) == 0) {
    sonarWatchUntil = millis() + constrain(atoi(cmd + 12), 1, 60) * 1000UL;
  } else if (strcmp(cmd, "IO") == 0) {
    sendIo();
  } else if (strcmp(cmd, "DRIVE") == 0) {
    sendDrive();
  } else if (strncmp(cmd, "PINTEST ", 8) == 0) {
    // Tell an open wire from a dead source without opening the robot: read an analog pin
    // with the internal pull-up, then pull-down, then neither. Open: ~4095 / ~0 / anything.
    // Tied to the voltage sensor's 7.5 k leg with no input: the pull-up only reaches ~0.8 V.
    // Shorted to GND: 0 / 0 / 0. Only analog pins that carry nothing else are allowed.
    int pin = atoi(cmd + 8);
    if (pin != 14 && !(pin >= 16 && pin <= 27)) {
      Serial.println("PINTEST ERR only pin 14 or 16-27");
    } else {
      pinMode(pin, INPUT_PULLUP);   delay(20); int up = analogRead(pin);
      pinMode(pin, INPUT_PULLDOWN); delay(20); int down = analogRead(pin);
      pinMode(pin, INPUT_DISABLE);  delay(20); int plain = analogRead(pin);
      Serial.print("PINTEST pin=");  Serial.print(pin);
      Serial.print(" pullup=");      Serial.print(up);
      Serial.print(" pulldown=");    Serial.print(down);
      Serial.print(" plain=");       Serial.println(plain);
    }
  } else {
    Serial.print("ERR unknown_command ");  Serial.println(cmd);
  }
}

void pollConsole() {
  while (Serial.available() > 0) {
    char c = Serial.read();
    if (c == '\n') {
      cmdBuf[cmdLen] = '\0';
      handleCommand(cmdBuf);
      cmdLen = 0;
    } else if (cmdLen < sizeof(cmdBuf) - 1) {
      cmdBuf[cmdLen++] = c;
    } else {
      cmdLen = 0;
      Serial.println("ERR line_too_long");
    }
  }
}

// ---------------------------------------------------------------------------

void setup() {
  driveSafePins();                      // bridges off before anything else runs
  pinMode(LED_PIN, OUTPUT);
  digitalWrite(LED_PIN, LOW);
  armLoadRanges();                      // joint limits, kept in EEPROM (log 028)

  Serial.begin(115200);
  // No `while (!Serial)`. Headless robot: blocking on a host that may never
  // open the console would stop the ROS side coming up at all.

  analogReadResolution(12);    // use full 12-bit ADC (default is 10-bit)
  analogReadAveraging(8);      // average 8 samples for noise reduction

  // LED strip. analogWriteResolution is global to analogWrite; the Servo
  // library does not use it, so the neck servos are unaffected.
  analogWriteResolution(12);
  analogWriteFrequency(LED_STRIP_PIN, STRIP_PWM_HZ);
  pinMode(LED_STRIP_PIN, OUTPUT);
  analogWrite(LED_STRIP_PIN, 0);

  driveSetup();                // drive PWM at 20 kHz, encoders on the hardware decoders
  sonarSetup();

  // Neck servos
  servoPan.attach(SERVO_PAN_PIN);
  servoTilt.attach(SERVO_TILT_PIN);
  servoPanCurrent = servoPanPos;
  servoTiltCurrent = servoTiltPos;

  // Command the servos NOW. The loop only writes when the value changes, and
  // lastPanWritten/lastTiltWritten start equal to the target — so without this
  // the servos are never driven at boot. They hold whatever position they
  // powered up in while the firmware reports the centre, and the first nudge
  // then snaps them across the whole error in about a tenth of a second.
  servoPan.write(servoPanPos);
  writeTilt(servoTiltPos);

  set_microros_transports();   // uses our SerialUSB1 overrides

  bootMillis    = millis();
  lastRateCalc  = bootMillis;
  lastHeartbeat = bootMillis;

  Serial.println();
  Serial.println("BOOT teensy41 microros");
  sendInfo();
}

void loop() {
  loopCount++;
  armWatchdog();
  driveUpdate();
  sonarUpdate();
  driveWatchUpdate();

  // --- Smooth servo motion: time-based, speed-limited, 50 Hz ---
  uint32_t nowMs = millis();
  if (nowMs - lastServoUpdate >= SERVO_UPDATE_MS) {
    float dt = (nowMs - lastServoUpdate) / 1000.0f;
    lastServoUpdate = nowMs;
    if (dt > 0.2f) dt = 0.2f;             // after a stall, do not lurch

    servoPanCurrent  = easeToward(servoPanCurrent,  servoPanPos,  dt);
    servoTiltCurrent = easeToward(servoTiltCurrent, servoTiltPos, dt);

    int newPan = (int)(servoPanCurrent + 0.5);
    int newTilt = (int)(servoTiltCurrent + 0.5);

    if (newPan != lastPanWritten) {
      if (!panAttached) {                 // woken: drive it again
        servoPan.attach(SERVO_PAN_PIN);
        panAttached = true;
      }
      servoPan.write(newPan);
      lastPanWritten = newPan;
      panSettledAt = nowMs;
    } else if (panAttached && panSettledAt &&
               nowMs - panSettledAt > PAN_IDLE_DETACH_MS) {
      servoPan.detach();                  // settled and still: stop buzzing
      panAttached = false;
    }

    if (newTilt != lastTiltWritten) {
      writeTilt(newTilt);
      lastTiltWritten = newTilt;
    }
  }
  pollConsole();          // always works, in every agent state

  uint32_t now = millis();

  // Ambient-light tracking runs at 20 Hz — fast enough to look smooth, slow
  // enough to stay cheap next to the servo easing.
  if (now - lastStripUpdate >= STRIP_UPDATE_MS) {
    lastStripUpdate = now;
    updateStrip();
  }

  if (now - lastRateCalc >= 1000) {
    loopsPerSec = loopCount;
    loopCount = 0;
    lastRateCalc = now;
  }

  switch (agentState) {
    case WAITING_AGENT:
      if (now - lastAgentPing >= AGENT_PING_MS) {
        lastAgentPing = now;
        agentState = (rmw_uros_ping_agent(100, 1) == RMW_RET_OK)
                     ? AGENT_AVAILABLE : WAITING_AGENT;
      }
      break;

    case AGENT_AVAILABLE:
      if (createEntities()) {
        agentState = AGENT_CONNECTED;
        agentConnects++;
        Serial.println("EVENT agent=connected");
      } else {
        destroyEntities();
        agentState = WAITING_AGENT;
        Serial.println("EVENT agent=create_failed");
      }
      break;

    case AGENT_CONNECTED:
      if (now - lastAgentPing >= AGENT_PING_MS * 4) {
        lastAgentPing = now;
        if (rmw_uros_ping_agent(200, 1) != RMW_RET_OK) {
          agentState = AGENT_DISCONNECTED;
          break;
        }
      }
      rclc_executor_spin_some(&executor, RCL_MS_TO_NS(1));
      break;

    case AGENT_DISCONNECTED:
      destroyEntities();
      agentDrops++;
      agentState = WAITING_AGENT;
      Serial.println("EVENT agent=disconnected");
      break;
  }

  if (now - lastHeartbeat >= HEARTBEAT_MS) {
    lastHeartbeat = now;
    heartbeatSeq++;

    // The LED is owned by the ROS subscriber once connected; only blink it as
    // a liveness indicator while there is no agent to drive it.
    if (agentState != AGENT_CONNECTED) {
      digitalWrite(LED_PIN, !digitalRead(LED_PIN));
    }

    // Read main battery voltage (every heartbeat, regardless of agent state).
    batteryMainRaw = analogRead(BATTERY_MAIN_PIN);
    float pinV = (float)batteryMainRaw * ADC_REF / ADC_MAX;
    if (now - lastPackRead >= PACK_READ_MS) {
      lastPackRead = now;
      readPackVoltage();
    }
    // The A0 sensor when it reads a real pack; otherwise the servos' own reading.
    batteryMainV = pinV * BATTERY_DIVIDER > 3.0 ? pinV * BATTERY_DIVIDER : powerPackV;

    if (agentState == AGENT_CONNECTED) {
      msg_heartbeat.data     = (int32_t)heartbeatSeq;
      msg_temperature.data   = tempmonGetTemp();
      msg_battery_main.data  = batteryMainV;
      msg_light.data         = ldrNormalized;
      RCSOFT(rcl_publish(&pub_heartbeat, &msg_heartbeat, NULL));
      RCSOFT(rcl_publish(&pub_temperature, &msg_temperature, NULL));
      RCSOFT(rcl_publish(&pub_battery_main, &msg_battery_main, NULL));
      RCSOFT(rcl_publish(&pub_light, &msg_light, NULL));
    }

    Serial.print("HEARTBEAT seq=");  Serial.print(heartbeatSeq);
    Serial.print(" uptime_ms=");     Serial.print(now - bootMillis);
    Serial.print(" temp_c=");        Serial.print(tempmonGetTemp(), 1);
    Serial.print(" loop_hz=");       Serial.print(loopsPerSec);
    Serial.print(" agent=");         Serial.print(agentStateName());
    Serial.print(" bat_v=");         Serial.print(batteryMainV, 2);
    Serial.print(" ldr=");           Serial.print(ldrRaw);
    Serial.print(" strip=");         Serial.print(stripDuty);
    Serial.println();
  }
}
