rightsum/gerdoo/robot-face/app.py

#!/usr/bin/env python3
"""
Robot Face — Flask backend.

Serves three things on one port:
  /            the kiosk "face" (opened full-screen by Firefox on the robot)
  /control     a password-protected panel to change the mood (opened from a desktop on the LAN)
  /api/*       state + live event stream that ties the two together

Mood changes made in /control are pushed to every open face over Server-Sent Events,
so the robot's expression updates instantly with no page refresh.
"""
import hmac
import json
import os
import time
import queue
import subprocess
import threading

from flask import (
    Flask, request, jsonify, Response, render_template,
    redirect, session, url_for, make_response,
)
from werkzeug.security import check_password_hash

import audio
import lidar
import face_track
import teensy
import video
# The path, from the module that writes it. It was hardcoded here once, and
# when battery_bridge.py moved on, the constant was deleted from this file
# while the handler that read it stayed — leaving /api/battery raising
# NameError and the panel's battery bars silently blank for sixteen days.
from battery_bridge import STATUS_FILE as BATTERY_FILE
from camera import camera, cameras, CameraError
import voice


def local_only():
    """True if the request came from this machine.

    The app binds 0.0.0.0, so this is the only thing keeping the internal
    ingest/frame endpoints off the LAN.
    """
    return request.remote_addr in ("127.0.0.1", "::1", "localhost")

BASE = os.path.dirname(os.path.abspath(__file__))
STATE_FILE = os.path.join(BASE, "state.json")
CONFIG_FILE = os.path.join(BASE, "config.json")

# --- Moods -----------------------------------------------------------------
# These ids map 1:1 to the <robot-face> component's `emotion` attribute, so a
# mood change is just an attribute swap on the face. "auto" makes the face
# autonomously cycle expressions (a lively default). The canonical list lives
# in config.json ("moods"); this is the first-run fallback.
DEFAULT_MOODS = [
    {"id": "auto",      "label": "Auto",      "emoji": "🔄"},
    {"id": "idle",      "label": "Idle",      "emoji": "😐"},
    {"id": "happy",     "label": "Happy",     "emoji": "😄"},
    {"id": "curious",   "label": "Curious",   "emoji": "🤨"},
    {"id": "love",      "label": "Love",      "emoji": "😍"},
    {"id": "thinking",  "label": "Thinking",  "emoji": "🤔"},
    {"id": "surprised", "label": "Surprised", "emoji": "😮"},
    {"id": "sleepy",    "label": "Sleepy",    "emoji": "😴"},
    {"id": "sad",       "label": "Sad",       "emoji": "😢"},
    {"id": "angry",     "label": "Angry",     "emoji": "😠"},
]

# Curated eye colours offered by the design (Look → color).
DEFAULT_COLORS = ["#FFAE1E", "#FF7A1E", "#FFD34D", "#2AD4FF"]

_state_lock = threading.Lock()
_sub_lock = threading.Lock()
_subscribers = set()  # set[queue.Queue]


# --- Config / state persistence -------------------------------------------
def load_config():
    if os.path.exists(CONFIG_FILE):
        with open(CONFIG_FILE) as f:
            cfg = json.load(f)
    else:
        cfg = {}
    cfg.setdefault("moods", DEFAULT_MOODS)
    cfg.setdefault("colors", DEFAULT_COLORS)
    cfg.setdefault("port", 8080)
    # "gl" = WebGL/SDF renderer (falls back to 2D automatically), "2d" = force 2D.
    cfg.setdefault("renderer", "gl")
    # secret_key must be stable so login sessions survive restarts.
    if not cfg.get("secret_key"):
        cfg["secret_key"] = os.urandom(24).hex()
        save_config(cfg)
    return cfg


def save_config(cfg):
    tmp = CONFIG_FILE + ".tmp"
    with open(tmp, "w") as f:
        json.dump(cfg, f, indent=2)
    os.replace(tmp, CONFIG_FILE)


def load_state():
    with _state_lock:
        if os.path.exists(STATE_FILE):
            try:
                with open(STATE_FILE) as f:
                    return json.load(f)
            except (json.JSONDecodeError, OSError):
                pass
        return {"mood": "auto", "color": DEFAULT_COLORS[0], "updated": time.time()}


def save_state(state):
    with _state_lock:
        tmp = STATE_FILE + ".tmp"
        with open(tmp, "w") as f:
            json.dump(state, f)
        os.replace(tmp, STATE_FILE)


# --- Pub/sub for Server-Sent Events ---------------------------------------
def broadcast(payload):
    dead = []
    with _sub_lock:
        for q in _subscribers:
            try:
                q.put_nowait(payload)
            except queue.Full:
                dead.append(q)
        for q in dead:
            _subscribers.discard(q)


# --- App -------------------------------------------------------------------
app = Flask(__name__)
_config = load_config()
app.secret_key = _config["secret_key"]
app.permanent_session_lifetime = 60 * 60 * 24 * 30  # 30 days


def mood_ids():
    return {m["id"] for m in load_config()["moods"]}


def logged_in():
    return bool(session.get("auth"))


def password_is_set():
    return bool(load_config().get("password_hash"))


def sensor_guard():
    """Gate for the camera and lidar endpoints.

    Returns a Flask response to abort with, or None to proceed.

    These are held to a HIGHER bar than mood control. With no password the
    panel auto-authenticates every visitor (see /login), which is a tolerable
    default for changing a face — and completely unacceptable for a live
    camera feed of someone's home, or for spinning up hardware. So these
    endpoints require a password to actually EXIST, not merely a session.
    """
    # Processes on this machine are already inside the trust boundary — the
    # face tracker starts the camera for the duration of a voice call, and it
    # has no session to log in with. This is the same latitude the wake-word
    # service and the frame endpoint already get.
    if local_only():
        return None
    if not logged_in():
        return jsonify(error="unauthorized"), 401
    if not password_is_set():
        return jsonify(
            error="password_required",
            message="Set a control-panel password before enabling the camera or "
                    "lidar: python3 manage.py set-password",
        ), 403
    return None


# ---- Face (public, kiosk) ----
@app.route("/")
def face():
    # No-store, because the kiosk browser has no one to press reload. A cached
    # face.html silently runs whatever JS shipped when it was cached, which
    # looks exactly like the new code being broken.
    resp = make_response(
        render_template("face.html", state=load_state(),
                        renderer=load_config()["renderer"])
    )
    resp.headers["Cache-Control"] = "no-store, must-revalidate"
    return resp


@app.route("/api/state")
def api_state():
    return jsonify(load_state())


@app.route("/api/events")
def api_events():
    def stream():
        q = queue.Queue(maxsize=10)
        with _sub_lock:
            _subscribers.add(q)
        try:
            # Prime the connection with the current state.
            yield "data: " + json.dumps(load_state()) + "\n\n"
            while True:
                try:
                    payload = q.get(timeout=20)
                    yield "data: " + json.dumps(payload) + "\n\n"
                except queue.Empty:
                    # Comment line keeps the connection alive through timeouts.
                    yield ": keepalive\n\n"
        finally:
            with _sub_lock:
                _subscribers.discard(q)

    return Response(
        stream(),
        mimetype="text/event-stream",
        headers={
            "Cache-Control": "no-cache",
            "X-Accel-Buffering": "no",
            "Connection": "keep-alive",
        },
    )


# ---- Voice sessions ----
# The room is fixed: one robot, one conversation. The agent on the Mac is
# auto-dispatched when this room is created, so joining is all the robot does.
VOICE_ROOM = "gerdoo"


def _voice_cfg():
    cfg = load_config()
    return (
        # Real key pair lives in the robot's config.json (gitignored) — see
        # voice-agent/livekit.yaml.example. These placeholders are inert; set
        # the real values there: livekit_url, livekit_api_key, livekit_api_secret.
        cfg.get("livekit_url", "ws://localhost:7880"),
        cfg.get("livekit_api_key", ""),
        cfg.get("livekit_api_secret", ""),
    )


def _current_url():
    """The URL mpv is playing, for remembering across a call."""
    return video.command("get_property", "path")


def _video_yield_to_call():
    """
    Stop a playing video and remember where it was.

    Pausing would leave mpv's window on screen covering the face, so a call
    would happen behind a frozen frame. Stopping takes the window away; the
    position comes back on resume. The cost is a second of re-buffering
    afterwards, which is cheaper than juggling windows with the WM.

    Whether there is something to yield is decided from mpv's `path` (via
    _current_url()), not status()["playing"]. loadfile is asynchronous and
    mpv's own ytdl_hook re-resolves the URL, so `playing` stays false for
    seconds after play_url() returns while `path` is set as soon as loadfile
    is accepted. Keying off `playing` let a call starting in that window see
    "not playing", record nothing, and return — the video then appeared
    fullscreen over the call with no pending record and nothing left to stop
    it. Once there is a path, stop() runs unconditionally: stopping an
    already-idle player is harmless, and doing it every time is what
    guarantees nothing survives into the call.
    """
    try:
        url = _current_url()
        if not url:
            return
        st = video.status()
        # Position is unavailable while mpv is still resolving the URL (the
        # window above). Reuse whichever start time is already on file for
        # this video rather than inventing one — 0 only if nothing was ever
        # recorded.
        position = st.get("position")
        if position is None:
            position = (_pending() or {}).get("start") or 0
        _set_pending({"url": url, "title": st.get("title"), "start": position})
        video.stop()
    except video.VideoError as e:
        app.logger.warning("video: could not pause for the call (%s)", e)


def _video_resume_after_call():
    record = _pending()
    if not record:
        return
    # Clear the record whether the resume succeeds or fails. A stuck record
    # asserts "this video is coming" to /api/video/status forever, so the
    # panel would advertise a video that will never play. The player unit
    # restarts itself (Restart=always), so a failure here is usually worse
    # than a transient blip a silent retry could heal, and recovery is one
    # click away — the panel's Play button or asking again by voice. Do not
    # "fix" this back into a retry without dealing with that lie.
    try:
        video.play_url(record["url"], start=record.get("start") or None)
    except video.VideoError as e:
        app.logger.warning(
            "video: could not resume after the call (%s) - dropping pending video", e)
    finally:
        _set_pending(None)


def _set_voice(state, detail=""):
    """Update voice state and push it to the face over the existing SSE."""
    was = load_state().get("voice", "idle")
    # The screen belongs to the call: a video steps aside when one starts and
    # comes back when it ends. This is also what makes a video requested DURING
    # a call start afterwards — both use the same pending record.
    if state != "idle" and was == "idle":
        _video_yield_to_call()
    s = load_state()
    s["voice"] = state
    s["voice_detail"] = detail
    s["updated"] = time.time()
    save_state(s)
    broadcast(s)
    if state == "idle" and was != "idle":
        _video_resume_after_call()
    return s


def stt_language():
    """Panel-selected speech-recognition language: auto, fa or en."""
    code = load_config().get("stt_language", "auto")
    return code if voice.is_valid_language(code) else "auto"


@app.route("/api/facetrack/status")
def api_facetrack_status():
    if not local_only() and not logged_in():
        return jsonify(error="unauthorized"), 401
    return jsonify(face_track.status())


@app.route("/api/facetrack/<action>", methods=["POST"])
def api_facetrack_control(action):
    """
    Start or stop the tracker. The tracker itself decides when to look — it
    only moves the neck during a voice call — so this is a master switch, not
    a "track now" button.
    """
    guard = sensor_guard()
    if guard:
        return guard
    if action == "start":
        ok, out = face_track.start()
    elif action == "stop":
        ok, out = face_track.stop()
    else:
        return jsonify(error="unknown action"), 400
    if not ok:
        return jsonify(error=out or "systemctl failed"), 500
    return jsonify(face_track.status())


@app.route("/api/voice/language", methods=["GET", "POST"])
def api_voice_language():
    if request.method == "POST":
        if not local_only() and not logged_in():
            return jsonify(error="unauthorized"), 401
        code = (request.get_json(force=True, silent=True) or {}).get("language")
        if not voice.is_valid_language(code):
            return jsonify(error="unknown language", got=code), 400
        cfg = load_config()
        cfg["stt_language"] = code
        save_config(cfg)
        app.logger.warning("stt language -> %s", code)
    return jsonify({"language": stt_language(),
                    "choices": voice.STT_LANGUAGES})


def voice_enabled():
    """Whether the robot answers to its name at all. Persisted in config."""
    return bool(load_config().get("voice_enabled", True))


@app.route("/api/voice/enabled", methods=["GET", "POST"])
def api_voice_enabled():
    """Master switch for the wake word and conversation. Used by the panel."""
    if request.method == "POST":
        # logged_in() is the app's own helper. An earlier version invented a
        # session key that is never set, so every POST from the panel returned
        # 403 and the toggle silently sprang back on the next poll.
        if not local_only() and not logged_in():
            return jsonify(error="unauthorized"), 401
        data = request.get_json(force=True, silent=True) or {}
        cfg = load_config()
        cfg["voice_enabled"] = bool(data.get("enabled", True))
        save_config(cfg)
        # Ending any live session immediately is the point of an off switch.
        if not cfg["voice_enabled"] and load_state().get("voice") != "idle":
            _set_voice("idle")
        app.logger.warning("voice %s", "enabled" if cfg["voice_enabled"] else "DISABLED")
    return jsonify({"enabled": voice_enabled()})


AUDIO_SETUP = os.path.expanduser("~/wake-word/audio-setup.sh")
MIC_SOURCE = "gerdoo_mic"


def _ensure_mic():
    """
    Make sure the echo-cancelled microphone exists before a call starts.

    `gerdoo_mic` carries only the XVF3800's processed channel. PulseAudio drops a
    remapped source when its master disappears for a moment — a USB blip is
    enough — and nothing puts it back, because audio-setup.sh runs only when the
    wake-word service starts. With it gone the browser falls back to the raw
    six-channel input, which mixes the UN-cancelled microphones back in, and the
    robot transcribes its own voice.

    That happened in service, and the worst part is how quiet the failure is:
    every service reports healthy and the only symptom is the robot talking to
    itself. A call is the one moment this must be right, so it is checked here.
    Failure to check is never allowed to block the call.
    """
    try:
        listed = subprocess.run(["pactl", "list", "short", "sources"],
                                capture_output=True, text=True, timeout=5)
        if MIC_SOURCE in listed.stdout:
            return
        app.logger.warning("%s missing before a call — re-running audio setup",
                           MIC_SOURCE)
        subprocess.run([AUDIO_SETUP], capture_output=True, text=True, timeout=30)
    except Exception as e:
        app.logger.warning("microphone check failed (%s)", e)


@app.route("/api/voice/wake", methods=["POST"])
def api_voice_wake():
    """Called by the wake-word service. Mints a token and tells the face to join."""
    if not local_only():
        return jsonify(error="forbidden"), 403
    if not voice_enabled():
        return jsonify({"error": "voice disabled"}), 409
    _ensure_mic()
    url, key, secret = _voice_cfg()
    token = voice.mint_token(VOICE_ROOM, "face", key, secret,
                             metadata={"stt_language": stt_language()})
    _set_voice("connecting")
    return jsonify({"url": url, "token": token, "room": VOICE_ROOM})


@app.route("/api/voice/state", methods=["POST"])
def api_voice_state():
    """Called by the browser as the session progresses."""
    if not local_only():
        return jsonify(error="forbidden"), 403
    data = request.get_json(force=True, silent=True) or {}
    state = data.get("voice")
    if not voice.is_valid_state(state):
        return jsonify({"error": "unknown voice state", "got": state}), 400
    # The kiosk has no console anyone can open, so the browser's own reason for
    # failing has to come back here to be readable at all.
    detail = str(data.get("detail") or "")[:300]
    if detail:
        app.logger.warning("voice %s: %s", state, detail)
    return jsonify(_set_voice(state, detail))


# Breadcrumbs from the kiosk browser. It has no console anyone can open, so
# without this a JS failure is indistinguishable from the network hanging.
_voice_log = []


@app.route("/api/voice/log", methods=["POST"])
def api_voice_log():
    if not local_only():
        return jsonify(error="forbidden"), 403
    msg = str((request.get_json(force=True, silent=True) or {}).get("msg", ""))[:400]
    _voice_log.append(f"{time.strftime('%H:%M:%S')} {msg}")
    del _voice_log[:-60]
    app.logger.warning("voice-js: %s", msg)
    return jsonify(ok=True)


@app.route("/api/voice/log")
def api_voice_log_read():
    if not local_only():
        return jsonify(error="forbidden"), 403
    return jsonify(lines=_voice_log)


@app.route("/api/voice/status")
def api_voice_status():
    """
    Polled by the wake-word service so it knows when to resume listening, and by
    the control panel to paint the Voice switch.

    Read-only, so a logged-in panel on the LAN is allowed as well as localhost.
    Locking this to localhost made the panel's poll return 403 every three
    seconds, which the page then misread as "enabled" and repainted — the switch
    appeared to turn itself back on.
    """
    if not local_only() and not logged_in():
        return jsonify(error="unauthorized"), 401
    st = load_state()
    return jsonify({"voice": st.get("voice", "idle"),
                    "detail": st.get("voice_detail", ""),
                    "enabled": voice_enabled(),
                    "language": stt_language()})


# ---- Video ----
# The agent runs on another machine, so local_only() cannot be the gate here.
# A shared token opens these routes and ONLY these routes; everything else keeps
# session login. The token lives in config.json, which is gitignored.
def video_guard():
    """None to proceed, or a response to abort with."""
    token = load_config().get("video_token", "")
    sent = request.headers.get("X-Video-Token", "")
    # Constant-time compare: this is the one shared secret in the system, and
    # a plain `==` leaks how many leading bytes matched through its timing. A
    # future reader must not "simplify" this back to `==`. Comparing as UTF-8
    # bytes (not str) also keeps a non-ASCII header from raising TypeError out
    # of compare_digest — it must deny cleanly, not 500.
    if token and sent and hmac.compare_digest(
            token.encode("utf-8"), sent.encode("utf-8")):
        return None
    if logged_in() or local_only():
        return None
    app.logger.warning("video: rejected request from %s", request.remote_addr)
    return jsonify(error="forbidden"), 403


def _pending():
    return load_state().get("video_pending")


def _set_pending(record):
    s = load_state()
    s["video_pending"] = record
    s["updated"] = time.time()
    save_state(s)


@app.route("/api/video/play", methods=["POST"])
def api_video_play():
    guard = video_guard()
    if guard:
        return guard
    data = request.get_json(force=True, silent=True) or {}
    target = (data.get("url_or_query") or "").strip()
    if not target:
        return jsonify(error="nothing to play"), 400
    try:
        url, title = video.resolve(target)
        start = video.parse_start(data.get("start"), url=url)
    except ValueError as e:
        return jsonify(error=str(e)), 400
    except video.VideoError as e:
        return jsonify(error=str(e)), 400

    # Deferral is a rule, not a parameter: anything asked for during a call
    # starts when the call ends. One record serves both this and a video
    # interrupted BY a call, so the two can never both fire.
    if load_state().get("voice", "idle") != "idle":
        _set_pending({"url": url, "title": title, "start": start or 0})
        return jsonify(ok=True, title=title, deferred=True)

    try:
        video.play_url(url, start=start)
    except video.VideoError as e:
        return jsonify(error=str(e)), 503
    _set_pending(None)
    return jsonify(ok=True, title=title, deferred=False)


@app.route("/api/video/stop", methods=["POST"])
def api_video_stop():
    guard = video_guard()
    if guard:
        return guard
    _set_pending(None)
    try:
        video.stop()
    except video.VideoError as e:
        return jsonify(error=str(e)), 503
    return jsonify(ok=True)


@app.route("/api/video/<action>", methods=["POST"])
def api_video_pause_resume(action):
    guard = video_guard()
    if guard:
        return guard
    if action not in ("pause", "resume"):
        return jsonify(error="unknown action"), 400
    try:
        getattr(video, action)()
    except video.VideoError as e:
        return jsonify(error=str(e)), 503
    return jsonify(ok=True)


@app.route("/api/video/status")
def api_video_status():
    guard = video_guard()
    if guard:
        return guard
    try:
        st = video.status()
    except video.VideoError as e:
        return jsonify(error=str(e), playing=False, deferred=bool(_pending())), 503
    st["deferred"] = bool(_pending())
    return jsonify(st)


# ---- Auth ----
@app.route("/login", methods=["GET", "POST"])
def login():
    cfg = load_config()
    if not cfg.get("password_hash"):
        # No password configured yet: control panel is open. Warn in the UI.
        session["auth"] = True
        session.permanent = True
        return redirect(url_for("control"))
    if request.method == "POST":
        pw = request.form.get("password", "")
        if check_password_hash(cfg["password_hash"], pw):
            session["auth"] = True
            session.permanent = True
            return redirect(url_for("control"))
        return render_template("login.html", error="Incorrect password"), 401
    if logged_in():
        return redirect(url_for("control"))
    return render_template("login.html")


@app.route("/logout", methods=["POST", "GET"])
def logout():
    session.clear()
    return redirect(url_for("login"))


# ---- Control panel (auth required) ----
@app.route("/control")
def control():
    if not logged_in():
        return redirect(url_for("login"))
    cfg = load_config()
    # no-store, for the same reason as the face page: the panel's JavaScript
    # changes, and a browser serving a cached copy runs old code against a new
    # API. That presented as a toggle that flipped and then sprang back with no
    # error shown.
    resp = make_response(render_template(
        "control.html",
        moods=cfg["moods"],
        colors=cfg["colors"],
        state=load_state(),
        has_password=bool(cfg.get("password_hash")),
        camera_present=camera.status()["present"],
        arm_cameras=[
            {"name": name, "label": cameras[name].label.capitalize(),
             "present": cameras[name].status()["present"]}
            for name in ("arm_left", "arm_right")
        ],
        facetrack_installed=face_track.unit_installed(),
        lidar_installed=lidar.unit_installed(),
    ))
    resp.headers["Cache-Control"] = "no-store, must-revalidate"
    return resp


@app.route("/api/state", methods=["POST"])
def api_set_state():
    """Set the mood and/or eye colour. Body may contain either or both."""
    if not logged_in():
        return jsonify(error="unauthorized"), 401
    data = request.get_json(silent=True) if request.is_json else request.form
    data = data or {}
    cfg = load_config()
    state = load_state()

    if "mood" in data and data["mood"]:
        if data["mood"] not in mood_ids():
            return jsonify(error="unknown mood"), 400
        state["mood"] = data["mood"]
    if "color" in data and data["color"]:
        if data["color"] not in cfg["colors"]:
            return jsonify(error="unknown color"), 400
        state["color"] = data["color"]

    state["updated"] = time.time()
    save_state(state)
    broadcast(state)
    return jsonify(state)


# ---- Camera (auth + password required) ----
# The head camera keeps its original routes — the face tracker speaks them.
# Every camera, head included, is also reachable by name under /api/cameras/.
def _camera_status(cam):
    guard = sensor_guard()
    if guard:
        return guard
    return jsonify(cam.status())


def _camera_control(cam, action):
    guard = sensor_guard()
    if guard:
        return guard
    if action == "start":
        try:
            cam.start()
        except CameraError as exc:
            return jsonify(error=str(exc)), 503
    elif action == "stop":
        cam.stop()
    else:
        return jsonify(error="unknown action"), 400
    return jsonify(cam.status())


def _camera_stream(cam):
    guard = sensor_guard()
    if guard:
        return guard
    try:
        cam.start()             # idempotent; lets a reload resume the stream
    except CameraError as exc:
        return jsonify(error=str(exc)), 503

    boundary = "frame"

    def generate():
        for jpeg in cam.frames():
            yield (
                b"--" + boundary.encode() + b"\r\n"
                b"Content-Type: image/jpeg\r\n"
                b"Content-Length: " + str(len(jpeg)).encode() + b"\r\n\r\n"
                + jpeg + b"\r\n"
            )

    return Response(
        generate(),
        mimetype=f"multipart/x-mixed-replace; boundary={boundary}",
        headers={"Cache-Control": "no-cache, no-store", "X-Accel-Buffering": "no"},
    )


@app.route("/api/camera/status")
def api_camera_status():
    return _camera_status(camera)


@app.route("/api/camera/<action>", methods=["POST"])
def api_camera_control(action):
    return _camera_control(camera, action)


@app.route("/camera/stream.mjpg")
def camera_stream():
    return _camera_stream(camera)


def _unknown_camera():
    return jsonify(error="unknown camera"), 404


@app.route("/api/cameras/<name>/status")
def api_named_camera_status(name):
    cam = cameras.get(name)
    return _camera_status(cam) if cam else _unknown_camera()


@app.route("/api/cameras/<name>/<action>", methods=["POST"])
def api_named_camera_control(name, action):
    cam = cameras.get(name)
    return _camera_control(cam, action) if cam else _unknown_camera()


@app.route("/cameras/<name>/stream.mjpg")
def named_camera_stream(name):
    cam = cameras.get(name)
    return _camera_stream(cam) if cam else _unknown_camera()


# ---- LiDAR (auth + password required) ----
@app.route("/api/lidar/status")
def api_lidar_status():
    guard = sensor_guard()
    if guard:
        return guard
    return jsonify(lidar.status())


@app.route("/api/lidar/<action>", methods=["POST"])
def api_lidar_control(action):
    guard = sensor_guard()
    if guard:
        return guard
    if action == "start":
        ok, out = lidar.start()
    elif action == "stop":
        ok, out = lidar.stop()
    else:
        return jsonify(error="unknown action"), 400
    if not ok:
        return jsonify(error=out), 503
    status = lidar.status()
    status["message"] = out
    return jsonify(status)


@app.route("/api/lidar/ingest", methods=["POST"])
def api_lidar_ingest():
    """Receives scans from scan_bridge.py.

    Localhost only, and no session: the bridge is a local ROS process, not a
    browser.
    """
    if not local_only():
        return jsonify(error="forbidden"), 403
    scan = request.get_json(silent=True)
    if not scan or "ranges" not in scan:
        return jsonify(error="bad scan"), 400
    lidar.ingest(scan)
    return jsonify(ok=True)


@app.route("/api/lidar/stream")
def api_lidar_stream():
    guard = sensor_guard()
    if guard:
        return guard
    q = lidar.subscribe()

    def stream():
        latest = lidar.latest()
        if latest:
            yield "data: " + json.dumps(latest) + "\n\n"
        try:
            while True:
                try:
                    yield "data: " + q.get(timeout=15) + "\n\n"
                except queue.Empty:
                    yield ": keepalive\n\n"
        finally:
            lidar.unsubscribe(q)

    return Response(
        stream(),
        mimetype="text/event-stream",
        headers={
            "Cache-Control": "no-cache",
            "X-Accel-Buffering": "no",
            "Connection": "keep-alive",
        },
    )


# ---- Gesture detection (auth + password required) ----
@app.route("/api/camera/frame.jpg")
def api_camera_frame():
    """Single latest frame, for the local face tracker.

    Localhost only. V4L2 allows one reader and this process owns the camera,
    so the detector cannot open the device itself — it gets frames from here.
    Reading also refreshes the camera's idle timer, so detection keeps the
    camera alive exactly as a browser viewer would.
    """
    if not local_only():
        return jsonify(error="forbidden"), 403
    for frame in camera.frames():          # yields as soon as one is ready
        return Response(frame, mimetype="image/jpeg",
                        headers={"Cache-Control": "no-store"})
    return jsonify(error="camera not running"), 503


@app.route("/api/battery")
def api_battery():
    try:
        with open(BATTERY_FILE) as f:
            return jsonify(json.load(f))
    except (FileNotFoundError, json.JSONDecodeError):
        return jsonify({"main_battery": None, "jetson_battery": None})

# ---- Servo (neck pan/tilt) ----

@app.route("/api/servo")
def api_servo_get():
    """Where the neck is pointing, according to the firmware."""
    try:
        (pan, tilt), raw = teensy.servo_get()
    except teensy.TeensyError as e:
        return jsonify(error=str(e)), 503
    return jsonify({"pan": pan, "tilt": tilt, "raw": raw})


@app.route("/api/servo", methods=["POST"])
def api_servo_set():
    """Move the neck. The firmware clamps to its own limits."""
    data = request.get_json(force=True, silent=True) or {}
    pan, tilt = data.get("pan"), data.get("tilt")
    if pan is None and tilt is None:
        return jsonify({"error": "no pan or tilt specified"}), 400
    try:
        (pan, tilt), raw = teensy.servo_set(pan, tilt)
    except (ValueError, TypeError):
        return jsonify({"error": "pan and tilt must be numbers"}), 400
    except teensy.TeensyError as e:
        return jsonify(error=str(e)), 503
    return jsonify({"pan": pan, "tilt": tilt, "raw": raw})


# ---- Arms (auth + password required: they move) ----
# Same bar as the cameras, not the neck: eight 30 kg-cm servos per arm are not
# something to hand to anyone on the LAN when no password is set.
ARM_SIDES = {"left": "L", "right": "R"}


def _arm_side(name):
    side = ARM_SIDES.get(name)
    if side is None:
        return None, (jsonify(error="unknown arm"), 404)
    guard = sensor_guard()
    return side, guard


@app.route("/api/arm/<name>")
def api_arm_state(name):
    side, refusal = _arm_side(name)
    if refusal:
        return refusal
    try:
        state, _ = teensy.arm_state(side)
    except teensy.TeensyError as e:
        return jsonify(error=str(e)), 503
    return jsonify(state)


@app.route("/api/arm/<name>/torque", methods=["POST"])
def api_arm_torque(name):
    side, refusal = _arm_side(name)
    if refusal:
        return refusal
    data = request.get_json(silent=True) or {}
    if "on" not in data:
        return jsonify(error="body must be {\"on\": true|false}"), 400
    try:
        line = teensy.arm_torque(side, bool(data["on"]))
    except teensy.TeensyError as e:
        return jsonify(error=str(e)), 503
    if "refused" in line:
        return jsonify(error=line), 409
    return jsonify(ok=True, reply=line)


@app.route("/api/arm/<name>/speed", methods=["POST"])
def api_arm_speed(name):
    side, refusal = _arm_side(name)
    if refusal:
        return refusal
    data = request.get_json(silent=True) or {}
    try:
        speed = int(data["speed"])
    except (KeyError, TypeError, ValueError):
        return jsonify(error="body must be {\"speed\": 50-3000}"), 400
    if not 50 <= speed <= 3000:
        return jsonify(error="speed must be 50-3000 steps/s"), 400
    try:
        speed = teensy.arm_speed(side, speed)
    except teensy.TeensyError as e:
        return jsonify(error=str(e)), 503
    return jsonify(ok=True, speed=speed)


@app.route("/api/arm/<name>/strength", methods=["POST"])
def api_arm_strength(name):
    """How hard the arm may push, as a percentage of the servos' full torque."""
    side, refusal = _arm_side(name)
    if refusal:
        return refusal
    data = request.get_json(silent=True) or {}
    try:
        percent = int(data["percent"])
    except (KeyError, TypeError, ValueError):
        return jsonify(error="body must be {\"percent\": 10-100}"), 400
    if not 10 <= percent <= 100:
        return jsonify(error="percent must be 10-100"), 400
    try:
        limit = teensy.arm_strength(side, percent * 10)
    except teensy.TeensyError as e:
        return jsonify(error=str(e)), 503
    return jsonify(ok=True, percent=limit // 10)


@app.route("/api/arm/<name>/calibrate", methods=["POST"])
def api_arm_calibrate(name):
    side, refusal = _arm_side(name)
    if refusal:
        return refusal
    data = request.get_json(silent=True) or {}
    try:
        joint, mid, half = int(data["joint"]), int(data["mid"]), int(data["half_span"])
    except (KeyError, TypeError, ValueError):
        return jsonify(error="body must be {\"joint\": 1-8, \"mid\": 0-4095, \"half_span\": 100-2047}"), 400
    if not (1 <= joint <= 8 and 0 <= mid <= 4095 and 100 <= half <= 2047):
        return jsonify(error="joint 1-8, mid 0-4095, half_span 100-2047"), 400
    try:
        line = teensy.arm_calibrate(side, joint, mid, half)
    except teensy.TeensyError as e:
        return jsonify(error=str(e)), 503
    if " ok " not in line:
        return jsonify(error=line), 409
    return jsonify(ok=True, reply=line)


@app.route("/api/arm/<name>/move", methods=["POST"])
def api_arm_move(name):
    side, refusal = _arm_side(name)
    if refusal:
        return refusal
    data = request.get_json(silent=True) or {}
    try:
        joint, pos = int(data["joint"]), int(data["pos"])
    except (KeyError, TypeError, ValueError):
        return jsonify(error="body must be {\"joint\": 1-8, \"pos\": 0-4095}"), 400
    if not (1 <= joint <= 8 and 0 <= pos <= 4095):
        return jsonify(error="joint must be 1-8 and pos 0-4095"), 400
    try:
        line = teensy.arm_move(side, joint, pos)
    except teensy.TeensyError as e:
        return jsonify(error=str(e)), 503
    if not line.endswith(" ok"):
        return jsonify(error=line), 409
    return jsonify(ok=True, joint=joint, pos=pos)


# ---- Speaker volume ----

@app.route("/api/audio")
def api_audio_get():
    """How loud the speaker is, 0-100."""
    try:
        return jsonify({"percent": audio.get_volume()})
    except audio.AudioError as e:
        return jsonify(error=str(e)), 503


@app.route("/api/audio", methods=["POST"])
def api_audio_set():
    """Set the speaker volume. Writes BOTH of the board's playback controls.

    Same tier as the neck servos: a session is enough. Loud is recoverable;
    the camera and lidar are the things held to a higher bar.
    """
    data = request.get_json(force=True, silent=True) or {}
    if "percent" not in data:
        return jsonify(error="no percent specified"), 400
    try:
        return jsonify({"percent": audio.set_volume(data["percent"])})
    except audio.AudioError as e:
        return jsonify(error=str(e)), 503


if __name__ == "__main__":
    cfg = load_config()
    app.run(host="0.0.0.0", port=cfg["port"], threaded=True)
