rightsum/gerdoo/(commit log)

2026-08-04 Initial commit — Jetson + Teensy 4.1 robot
    Hardware reference, engineering log, and working firmware/services for the
    Arduino Nano -> Teensy 4.1 migration.
    Working and verified:
    - Teensy 4.1 on micro-ROS as /teensy_node, Dual Serial so the debug console
    survives alongside the XRCE-DDS transport; agent runs as a systemd user
    unit with unattended reconnect
    - RPLIDAR C1 on Jetson USB publishing /scan at 10.008 Hz
    - robot-face kiosk + LAN control panel: mood, eye colour, authenticated
    camera stream, live LiDAR polar plot
    Documentation:
    - inventory.md datasheet-backed wiring reference and power architecture
    - ACTION-PLAN.md numbered tasks with measurable pass conditions
    - logs/001-008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
2026-08-04 fix(lidar): stop the motor on shutdown
    The C1's motor holds its last commanded state. Killing the driver mid-scan
    left it spinning indefinitely — the only way to stop it was unplugging USB.
    It does not free-run on power; nothing had ever told it to stop.
    rplidar_node::stop() does call setMotorSpeed(0), but only when rclcpp runs
    its shutdown handler, which needs SIGINT. run-lidar.sh was sending SIGTERM,
    and `ros2 launch` does not reliably convert that.
    - rplidar.service: KillSignal=SIGINT, TimeoutStopSec=20, KillMode=mixed
    - run-lidar.sh: SIGINT + wait for exit, then write the raw RPLIDAR STOP
    (0xA5 0x25) to the port as a backstop. Runs on both the trap and the
    child-exit path; previo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
2026-08-04 feat(vision): MediaPipe gesture detection + hand tracking
    Detects Closed_Fist (and 6 other gestures) and publishes hand position for
    future neck tracking. Runs on CPU at 4 Hz, ~57% of one core of six.
    Architecture mirrors the lidar bridge, for two forced reasons:
    - MediaPipe needs numpy 2.2 / cv2 5.0, which would break the system
    cv2 4.8 and ROS Humble. It runs in ~/gesture-venv, isolated.
    - V4L2 allows one reader and the Flask app owns the camera, so the
    detector pulls frames from a localhost-only endpoint instead.
    Position comes free from the 21 landmarks already computed for
    classification: x/y, err_x/err_y from frame centre (what a pan/tilt
    controller consumes), size as a distance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
2026-08-04 docs: log 010 — gesture detection, tracking, and GPU evaluation
    Records the shipped CPU implementation plus a complete, benchmarked
    evaluation of GPU acceleration that was deliberately not built.
    Everything needed to resume the GPU work later without re-deriving it:
    - measured numbers: palm 2.83ms, landmarks 1.41ms, ~4.2ms combined,
    against 120ms on CPU (~28x). Engines were actually built on this
    board with trtexec --fp16 and benchmarked, not estimated.
    - model URLs, including the Git LFS media endpoint (the normal raw
    URL returns a 132-byte pointer, not the model)
    - exact tensor shapes, including that inputs are NHWC not NCHW
    - reference pre/post-processing sources, and the five st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
2026-08-06 docs: power architecture, fusing, and arm power
    inventory.md described a single 12V pack and a MINI560-based 5V rail.
    Both were wrong: there are two independent 3S packs, and MINI560 is out
    of the design.
    - Two-pack architecture documented as the core of the design: 40T
    (35A high-drain) for motors and arm servos, 50E (10A high-capacity)
    for the Jetson and logic, each with its own 40A BMS. The point is
    that an arm stall tripping the 40A BMS cannot brown out the Jetson.
    - Fusing section. A BMS protects cells, a fuse protects wiring, and
    there were no fuses anywhere. Per-branch ratings against wire
    ampacity, Standard ATO blade type, placement at the battery.
    - Arm power. Honest treat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
2026-08-26 feat(control-panel): battery readouts and neck servo controls
    Adds a battery bridge that collects both voltages and publishes them as
    JSON for the Flask app, plus the panel UI to display them and to drive
    the neck.
    - battery_bridge.py subscribes /teensy/battery_main for the main pack and
    reads the INA219 on I2C bus 7 for the UPS, writing
    /tmp/battery_status.json every 3s. It touches only register 0x02 (bus
    voltage) — reading other registers on bus 7 rebooted the system during
    testing, so I2C access is kept deliberately minimal.
    - /api/battery serves that file; /api/servo gets and sets neck position by
    talking to the Teensy console.
    - control.html gains a battery panel with per-p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
    [app.py, battery_bridge.py]
2026-08-26 docs: log 011 — charger bench test, and the SG90 tilt servo failure
    Two write-ups that were sitting uncommitted.
    - log 011 covers the 19V charger through the XL4015 into a 3S pack: the
    target CC/CV settings, the safety guards, and the pack that would not
    charge past 11.69 V because of cell imbalance. Still open.
    - servo-problem.md records the tilt servo that locked hard after an
    aggressive 0-180 sweep, including the pin-swap tests and why the
    burned-out-from-stalling timeline fits the evidence.
2026-08-26 feat(lighting): COB LED strip with ambient-brightness control
    Firmware 0.4.0. The strip runs from a D4184 MOSFET module on pin 4 at
    18 kHz, with brightness following a photoresistor on A1 — darker room,
    brighter strip.
    - /teensy/light_level publishes normalised ambient light at 1 Hz.
    - /teensy/led_strip forces a level 0-1, or hands control back to the
    sensor on any negative value.
    - Console gains LIGHT, CAL dark/bright, and STRIP auto|0-100.
    18 kHz sits inside the D4184's 0-20 kHz spec, above adult hearing so the
    strip does not whine, and far above any camera shutter so it cannot band
    the OV9281s or the Brio. The 20 Hz update with 0.05 smoothing is
    deliberate: the strip lights its own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
2026-08-26 docs: log 012, and resolve the 5V rail open questions
    Documents the LED strip bring-up and closes two long-standing unknowns.
    inventory.md open items 2 and 3 are answered: the COB strip is 5V, and the
    5V supply is now two separate rails — LM2596S to the neck servos, MINI560
    to the strip. They were briefly on one rail and it did not work: at full
    brightness the strip dropped the pack from 11.13 V to 10.94 V and the
    servos audibly strained. Splitting them fixed it.
    Also recorded:
    - The LR7843 module never switched its gate and is marked failed in
    service, with the full evidence trail — the power path was fine, but no
    drive turned it on, including 5V jumpered straight to the header.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
2026-08-30 feat(wake-word): Persian "Gerdoo, baba" trigger via offline Vosk
    Listens for گردو بابا on the Brio's mic and plays a sound. Runs entirely
    offline on CPU — no audio leaves the robot, and nothing is written to disk
    unless --record or --save-hits is passed.
    Installed as wake-word.service (systemd --user, enabled at boot).
    Design notes, all of them learned the hard way:
    - Decoder grammar carries the discrimination, not the confidence threshold.
    A sweep over one recording gave 18 hits at every threshold from 0.0 to
    0.8 — confidences are bimodal, so the gate does almost nothing. It stays
    at 0.5 as insurance for noisier conditions, not because it earns its keep.
    - The grammar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
2026-08-30 docs: log 013 — audio output and the Persian wake word
    Covers getting sound out of the robot and the wake-word bring-up, plus a
    correction to a claim in this same entry that real use disproved.
    The speaker was never broken. Its ALSA hardware mixer ships at 15%
    (PCM = 39/255), which reads as a faint or dead speaker. PulseAudio's level
    rides on top of it, so amixer is the control that matters, not pactl.
    The wake word took two passes. The first detected ~70% and fired on
    unrelated speech, from two mistakes: calibrating in open-transcription mode,
    where گردو competes with every similar Persian word and the model wrote the
    phrase correctly only once in a session; and firing on partial hy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
2026-08-30 docs: design for the LiveKit voice agent
    Wake word starts a real-time voice conversation; STT, LLM and TTS all run
    on the Mac so the Jetson keeps its compute for vision and control.
    The load-bearing decision is that the robot-side LiveKit client lives in
    the face kiosk browser rather than in a Python service on the Jetson. The
    speaker plays the TTS and the Brio mic sits beside it, so without echo
    cancellation the robot transcribes its own voice and talks to itself.
    Firefox is already running in kiosk mode rendering face.html, and a browser
    gives WebRTC echo cancellation, noise suppression and auto gain for free. A
    Python client would mean implementing AEC by hand or going half-duplex and
    lo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
2026-08-30 docs: implementation plan for the LiveKit voice agent
    Seven tasks in the spec's build order, each ending in something testable on
    its own so a failure localises instead of leaving you staring at a silent
    robot. The pure decision logic — closing phrase and silence timer — is
    split into its own module and driven by tests first, because that is the
    part most unpleasant to debug through a live microphone.
    The plan front-loads verification that does not involve the robot at all:
    task 3 finishes by holding a full conversation through the `lk` CLI, so STT,
    the LLM and TTS are all proven before the Jetson is touched.
    Echo cancellation gets its own explicit test step. It is the entire reason
    th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
2026-08-30 feat(voice): session-end rules — closing phrase and silence timer
2026-08-30 feat(voice): livekit agent worker — elevenlabs stt/tts, litellm brain
2026-08-30 fix(voice): drop no-op sync shutdown callback — 1.7.1 awaits callbacks
2026-08-30 fix(voice): guard voice routes with local_only like other internal endpoints
    [app.py]
2026-08-30 fix(voice): review findings — silent audio, premature timeout, false resume
    Six issues from reviewing the branch, all found by reading against the
    installed livekit-agents 1.7.1 source rather than the docs.
    face.html: track.attach() returns a DETACHED <audio> element. Firefox will
    not autoplay one that is outside the document, and the kiosk runs Firefox —
    so the robot would have connected, shown cyan, and said nothing. Elements
    now go into a #voice-audio sink and are removed on unsubscribe and on
    leave.
    agent.py: the silence timer started at connect time, but generate_reply
    awaits playout, so the whole greeting burned the user's 30 s window before
    they could physically speak. A slow fi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
2026-08-30 feat(voice): Makefile to bring the Mac side up, and a selectable voice
    Two processes make a conversation possible and both have to be running; a
    Makefile is less to remember than two terminals and an env-loading
    incantation.
    make check preflight — every required var, the binaries, the port
    make up server + agent, idempotent
    make join talk to the agent from this Mac, no robot involved
    make voices list the ElevenLabs voices on this account
    make status / logs / down / restart / test / agent-dev
    `up` depends on `check`, so a missing key gives a named MISSING line rather
    than a stack trace four seconds later. `server` leaves an already-listening
    server alone instead of fi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
2026-09-01 fix(audio): stop the wake word and the call fighting over one microphone
    Three device-level faults, all of which presented identically: the face
    reached "listening", both participants published tracks, and the agent
    heard silence.
    wake_word.py opens the Brio through raw ALSA and held /dev/snd/pcmC2D0c for
    the entire call, so Firefox's getUserMedia succeeded and captured nothing.
    Pausing the detector was not enough — it stops decoding but never releases
    the device. It now closes the stream for the duration of a call and reopens
    afterwards.
    The 180s backstop could not tell a wedged session from a good conversation
    and reclaimed the microphone mid-sentence. It now waits indefinitely on any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
2026-09-01 fix(voice): hold the session open, and stop the robot answering itself
    The agent greeted and then went deaf until the wake word was said again.
    The entrypoint returning is what ends a job, so the coroutine simply fell
    off the end after the greeting. It now blocks on an asyncio.Event set by
    either ending.
    The greeting itself is gone — the chime already announces the wake, and a
    spoken greeting only delayed when the user could start talking. GREET=1
    brings it back.
    The 30s hang-up timer counted the robot's own speech. It only reset when the
    USER spoke, but during a story the user is silent by definition, so any
    answer longer than the timeout hung up on itself mid-sentence. The window
    now m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
    [app.py]
2026-09-01 docs: log 014 — the LiveKit voice agent, and the audio problems behind it
    The feature is the smaller half of this entry. The audio device work cost
    more time than everything else combined, and none of it was visible from the
    application layer — every fault presented identically as "connected, but the
    agent hears silence".
    Recorded because each would cost hours to rediscover: two processes holding
    one microphone; module-stream-restore silently overriding default devices
    per application; clock drift between two independent USB devices collapsing
    echo cancellation after about thirty seconds; and a USB replug resetting
    mixer levels and moving the default source to the speaker's own micropho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
2026-09-02 fix(voice): stop false wake-ups, add an off switch, make barge-in usable
    Four things, all found by reading the logs rather than guessing.
    The wake word fired on ordinary conversation — about a third of triggers.
    Matching required both words anywhere in the transcript rather than next to
    each other, so any sentence containing them woke the robot, and confidence
    did not help because the words really were recognised. Now the two words
    must be adjacent AND the whole utterance must be at most four words:
    calling the robot is short, while every false positive ran 7 to 15 words.
    Replayed against the real logged transcripts: 9/9, no false positives, no
    misses.
    Adds a Voice switch to the panel, p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
    [app.py, voice.py]
2026-09-02 docs: log 015 — the voice switch, echo, and picking a language
    Records today's fixes and, more usefully, the three things that cost the
    most time.
    A swallowed error producing a confident wrong display, for the third time
    in two days. The panel's poll got a 403 and read the missing field as
    "enabled", so it painted a state it had never actually read. Same shape as
    the empty catch{} behind the frozen face and the toggle that sprang back:
    an error path returning something falsy, and code treating falsy as valid.
    Reverting live state without reverting the script that recreates it. The
    setup script kept selecting a microphone that had been tried and rejected;
    the running system was corrected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
2026-09-02 docs: log 016 — agent tools, and the timer that hung up mid-question
    Records the two tools and, more usefully, why the search results are
    trimmed so hard: the API's own defaults are wrong for voice, and an
    untrimmed result turns a spoken answer into a recited list.
    Keeps the Jalali verification data — two Nowruz dates and two others — so a
    future change to that conversion has something to check itself against.
    The bug worth remembering is the silence timer. It hung up on a question
    that had been heard and transcribed, because it only reset when a sentence
    FINISHED rather than when speech started. That is the third distinct fault
    in the same timer, each from the same misreading of wha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
2026-09-03 feat(face): the neck follows your face during a call
    Say the wake word and the robot turns to look at you, following your face
    for the length of the call and re-centring afterwards. Replaces hand-gesture
    detection, which is removed.
    The important structural change is that tracking moved OUT of the browser.
    The old fist tracking lived in control.html, so the neck only followed
    anything while somebody happened to have the control panel open — and the
    robot's own screen shows the face, not the panel. It now runs as a systemd
    service that polls the voice state, starts the camera when a call begins,
    drives the servos directly, and stops the camera and re-centres at the end.
    The geometry is a s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
    [app.py, face_track.py, face_tracker.py, face_tracking.py, teensy_microros.ino, test_face_tracking.py]
2026-09-03 fix(servo): read the neck's position correctly
    /api/servo reported three different tilt values in six seconds while nothing
    moved, and sent me chasing a fault that did not exist.
    Five faults in one short function. It spawned `cat` and `bash -c echo` per
    call and slept 450ms. It never flushed the input, so output buffered before
    the command was read as its answer. It matched any line containing SERVO and
    "set", which meant echoes of earlier commands. It held no lock, so
    concurrent requests interleaved on one serial port. It hardcoded the board's
    serial number in the device path — the exact thing this project has been
    bitten by three times. And it interpolated the command into a shell strin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
    [app.py, teensy.py, test_teensy.py]
2026-09-04 chore: repo cleanup for the public release
    Remove internal working files: the dated action plan, the stale Nano
    pinout, the problem write-ups, the agent prompt scratch, the workflow
    artifacts and the legacy Arduino Nano sketches. Fix the references
    left behind. Slim the readme to match.
    [camera.py, teensy_bringup.ino]
2026-09-15 feat(audio): XVF3800 mic and speaker with hardware echo cancellation
    The reSpeaker Flex XVF3800 replaces the Brio microphone and the USB
    speaker. Capture and playback now share one clock and echo is cancelled
    in hardware, so every software echo workaround is gone:
    - audio-setup.sh: expose XVF3800 channel 0 (processed) as the mono
    default source gerdoo_mic, default sink the XVF3800, unload
    module-echo-cancel, set both PCM playback controls (PCM,1 shipped at
    -20 dB and capped the volume)
    - agent: remove the transcript echo filter and raised interruption
    thresholds; LiveKit defaults
    - wake word: listen via PulseAudio at 16 kHz, gain 1.0; no chime wait
    - inventory and log 018
    Co-Author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
2026-09-18 docs: design for video playback on the robot's screen
    Send a YouTube URL or search phrase, with an optional start time, from
    the control panel or the voice agent. It plays fullscreen over the kiosk
    face via mpv + yt-dlp, driven through mpv's IPC socket. A call pauses it
    and it resumes afterwards; "گردو بسه" stops it and the face returns.
    Approved design, not yet implemented.
    Claude-Session: https://claude.ai/code/session_018crvdtkzscJBpM3kZT2NbR
2026-09-18 docs: implementation plan for video playback
    Ten tasks, TDD throughout: pure parsing, the mpv IPC client against a fake
    socket, yt-dlp resolution, the player service, Flask routes with token auth,
    pause-for-a-call, the panel card, the گردو بسه stop phrase, the agent tools,
    and the end-to-end bench checks.
    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
2026-09-18 feat(video): talk to mpv over its IPC socket
    Adds video.command(), play_url(), stop(), pause(), resume(), and
    status(): a fresh unix-socket connection per command, skipping async
    events to find the reply that matches our request_id, raising
    VideoError when the player is not there or does not answer.
    Also adds robot-face/tests/conftest.py, pinning pytest's basetemp to
    /tmp/gerdoo-pytest. Without it, the fake mpv socket in test_video.py
    binds under macOS's default tmp path (pytest-of-<user>/pytest-N/<long
    test name>N/mpv.sock), which regularly exceeds the ~104-byte AF_UNIX
    path limit and fails with OSError before the client is ever exercised
    -- unrelated to video.py itself.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
    [test_video.py, video.py]
2026-09-18 test(video): keep the fake mpv socket path short without a global conftest
    FakeMpv now binds its socket inside a directory made with
    tempfile.mkdtemp(dir="/tmp"), created and torn down by the fake_mpv
    fixture itself, instead of pytest's tmp_path. That keeps the fix scoped
    to the one fixture that needs a short path for the ~104-byte sockaddr_un
    limit, rather than relocating pytest's temp root for the whole suite
    (robot included) via a conftest.py, which is removed.
    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
    [test_video.py]
2026-09-18 feat(video): resolve a URL or a search phrase with yt-dlp
    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
    [test_video.py, video.py]
2026-09-18 fix(video): constant-time token check, and cover every way in
    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
    [app.py, test_video_routes.py]
2026-09-18 fix(video): a failed resume must not leave a video pending forever
    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
    [app.py, test_video_routes.py]
2026-09-18 feat(wake): گردو بسه stops the video
    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
2026-09-18 fix(video): reach the panel without a password, and yield a loading video
    - control.html: api() lived inside the {% if has_password %} guard, but the
    Video card sits outside it and calls api() — with no panel password set,
    api() never rendered, so refreshVideo() threw ReferenceError into its own
    catch ("unreachable" forever) and Play toasted "api is not defined".
    video_guard() has no password_is_set() check, unlike sensor_guard(), so
    the card is meant to work with no password — moved api() above the guard.
    - app.py _video_yield_to_call(): keyed the yield decision off status()
    ["playing"] (mpv's idle-active), which stays false for seconds after
    play_url() while ytdl_hook re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
    [app.py, test_video_routes.py]
2026-09-18 feat(video): deploy playback, and fix what deployment exposed
    Video playback is live on the robot: a URL or a search phrase from the
    panel or spoken to the agent plays fullscreen over the kiosk face. The
    bench check log 019 could not make — whether mpv's window really covers
    the face — passes, once fullscreen is set per file rather than on a
    window that does not exist yet.
    Four faults found by running it for real:
    - The search answered in seconds and then ran for minutes; we waited for
    the process to exit, so it timed out anyway. -I 1 processes only the
    first result: 3-4s, measured.
    - gerdoo_mic vanished mid-session and nothing put it back, so the browser
    fell back to the raw six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
    [app.py, test_video.py, video.py]
2026-09-19 fix(face): stop the kiosk page taking the robot down
    fetch() rejects asynchronously, so the try/catch around jslog's fetch
    caught nothing: a failed log became an unhandled rejection, the rejection
    handler called jslog, and that fetched again. Every failure manufactured
    another failure. The instant the server was slow enough to fail one
    request, the kiosk page attacked it — and Flask's thread-per-connection
    dev server turned that into 1019 threads and 1024 file descriptors, an
    accept storm, and a panel that stopped answering. It took the robot down
    twice, and with it the wake word, because /api/voice/wake lives on the
    same server.
    jslog now catches its own rejection, refuses to re-enter wh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
2026-09-19 feat(audio): heal the microphone when the board re-enumerates
    The XVF3800 re-enumerated four times in one afternoon. Each time
    PulseAudio destroyed gerdoo_mic — the remapped source carrying the
    board's processed channel — and the wake-word detector, which holds its
    capture stream open across that, ended up on the RAW six-channel input.
    PulseAudio downmixes those six to mono for it, averaging one good
    channel with four un-cancelled microphones: structurally clean audio, at
    a plausible level, with every gain maxed, and four times too quiet to
    recognise. The robot stopped answering to its name while every service
    reported healthy and nothing logged an error.
    gerdoo-audio-repair.sh rebuilds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
2026-09-19 fix(audio): the speaker goes to maximum, and a log of the day the board died
    The owner asked for maximum volume. The 85% setting that stood in the way was
    defended by a comment claiming the canceller cannot keep up at full output --
    but reading the controls showed that claim had never been in force. PulseAudio
    drives PCM,0 to 100% on its own whenever it sets sink volume, so SPK_LEVEL only
    ever held back PCM,1. The system had been running one control at 0 dB and the
    other at -9 dB, under a documented "85%" that was fiction on half the path.
    Both controls are at 0 dB now, and the default is 100% so the audio repair
    watchdog stops undoing it on every rebuild. The comment now says what is known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
2026-09-19 feat(panel): a volume slider, and battery bars that are no longer blank
    Volume had to be set over ssh, which is not a feature. The panel now has an
    Audio card: a slider that reads /api/audio and writes it back on release.
    audio.py enforces in code what log 023 learned the hard way -- set_volume()
    writes BOTH of the board's playback controls, and get_volume() reports the
    quieter of the two, because that one is what actually limits the sound. A
    control that moved only PCM,1 would have displayed 85% while PulseAudio held
    PCM,0 at 100%, which is precisely the fiction that setting was living in.
    Same auth tier as the neck servos: a session is enough. Camera and lidar stay
    held higher -- a loud r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
    [app.py, audio.py, test_audio.py, test_audio_routes.py]
2026-09-19 feat(voice): a Wake button, because the robot cannot hear you over itself
    At 90% volume the wake word stopped working entirely. It is not the echo
    canceller: the voice is absent from the RAW microphone too, with the AEC and
    the suppressor bypassed. The music masks it at the membrane, and nothing
    downstream can recover what the air destroyed.
    music at the raw mics ~300 RMS
    shout, normal distance ~300-400 RMS -> 0-2 dB SNR
    10% -> 90% volume 13.5 dB at the mics
    So shouting is out, and the screen has to do it instead. Adds a floating
    "Wake!" button to the kiosk face: a circular FAB that starts a voice session,
    becoming End during one. Transparent and click-through, so th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
2026-09-19 fix(voice): stop the Wake button starting two sessions at once
    Every trigger began failing with "can't connect" minutes after the button
    shipped. The server was fine throughout — agent up, HTTP 200 from the robot in
    11ms, the WebSocket endpoint correctly 401ing without a token.
    Two joinVoice() calls were running concurrently over one shared `room`:
    22:54:30 connected; enabling mic
    22:54:30 joinVoice FAILED: room is null
    22:54:36 joinVoice FAILED: room.connect timed out after 15000ms <- began :21
    The button calls joinVoice() directly; that POSTs /api/voice/wake, which sets
    the server to `connecting`, which arrives over SSE, which makes apply() call
    joinVoice() again. The `if (r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
2026-09-19 feat(kiosk): put the Wake button over the video, where it is actually needed
    The button only mattered during playback — that is when shouting fails — and
    that is exactly where it was invisible. mpv covered it.
    Sizing mpv to leave a strip was not enough: xfwm4 stacks the kiosk browser's
    _NET_WM_STATE_FULLSCREEN above mpv's _NET_WM_STATE_ABOVE, so the face covered
    the video instead. --ontop does not beat fullscreen and --kiosk re-asserts it
    after it is stripped, so the browser had to stop being fullscreen:
    - deploy/firefox-userChrome.css hides the chrome that --kiosk used to hide,
    with toolkit.legacyUserProfileCustomizations.stylesheets to load it
    - deploy/start-kiosk.sh launches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
2026-09-20 feat(video): draw the controls inside mpv, so the video keeps the whole screen
    Reserving a strip for the kiosk page's toolbar worked, but cost 190px of picture
    on a five-inch screen and only after dropping the browser out of fullscreen to
    win a stacking fight with xfwm4.
    mpv draws them instead: an ASS overlay with a translucent "Wake!" circle
    bottom-centre and pause/stop beside it, at 50% fill alpha so the video reads
    through. Taps are hit-tested against the same coordinates they are drawn at, so
    unlike the seek handler this needs no AXIS/INVERT — seek has to know which side
    is physically left, a button does not.
    mpv returns to plain --fullscreen. Wake only POSTs /api/voice/wake; the ser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
2026-09-20 fix(kiosk): put the browser back in --kiosk; the screen froze without it
    Taking the browser out of fullscreen was only ever scaffolding for a reserved
    strip, and the strip is gone — mpv draws the controls itself now. Keeping the
    workaround cost a blank robot.
    After a video stopped, the last frame stayed on the display with the controls
    still painted on it. mpv's window was destroyed and mpv was idle; the browser
    never repainted. There is no compositor (xfwm4 use_compositing is false), so X
    relies on Expose events, and the SPLASH-type window did not act on them.
    xrefresh cleared the stale frame to white and the face still did not come back.
    Reverts start-kiosk.sh, firefox-userChrome.css a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
2026-09-20 feat(ui): the wake control becomes a face-coloured dome on the bottom edge
    Was a small green circle floating above the bottom. Now a wide, shallow,
    transparent dome rising from the screen edge, in whatever colour the face
    currently is.
    The colour is read from the face element rather than kept in a second table, so
    it follows the robot through every voice state — cyan idle, amber connecting,
    red on error — and there is nothing to keep in sync.
    Both surfaces get the same shape: the page's own button for the idle face, and
    mpv's ASS overlay for when a video is playing. 740x185 in both, with the
    ellipse centre on the bottom edge so the flat side IS the screen edge and every
    pixel of it is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
2026-09-20 docs(log): record the wake control's final shape in log 025
    The entry still described the first version — a small green circle floating
    above the bottom edge. What shipped is a wide, shallow, transparent dome rising
    from the edge itself, in the face's own colour.
    Adds the two shape notes that each cost a round trip: CSS clamps a single
    border-radius to the box height and silently gives a rounded rectangle instead
    of an ellipse, and the matching ASS path needs rx and ry separately.
2026-10-14 feat(camera): the arm cameras on the control panel, one toggle each
    Both gripper cameras (OV9281) get a row on a new Arm cameras card, served by
    /api/cameras/<name>/status|start|stop and /cameras/<name>/stream.mjpg behind
    the same sensor guard as the head camera. The original /api/camera/ routes
    are unchanged, because the face tracker uses them.
    - Addressed by USB port path. Both modules report serial SN0001, so
    /dev/v4l/by-id/ keeps a single link for the pair.
    - 640x400. With the Brio running, any arm camera at 720p makes the third
    stream fail with "No space left on device".
    - Capped at 30 fps by publishing every Nth frame, counted from the rate the
    driver negotiated. A clock-based c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
2026-10-14 docs: logs 026 and 027, arm bus wiring, and a UVC quirk that never applied
    026: the kiosk's voice-session guard wedged for 20 days on one unbounded
    room.disconnect().
    027: the arm cameras. It covers:
    - two modules sharing serial SN0001
    - one module shipped with 2022 firmware offering 210 fps only. A frame
    cannot be exposed longer than it lasts, so that camera was dark indoors.
    - reflashing it with the other camera's 2024 firmware using Arducam's
    CommonBurnerAP. The flash is 256 KB, and Linux can only read the first
    128 KB over USB.
    - two smudged lenses, made measurable with a live sharpness readout
    Corrections:
    - uvcvideo quirks=128 (UVC_QUIRK_FIX_BANDWIDTH) is guarded by
    !UVC_FMT_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
2026-10-15 fix(teensy): flash over Dual Serial with the 134-baud bootloader trigger
    teensy_loader_cli -s sends its soft reboot over HID, and the Dual Serial USB
    type exposes two CDC interfaces and no HID, so -s waited forever. Opening the
    primary CDC at 134 baud is the Teensy core's own bootloader trigger and needs
    no HID or pyserial. The micro-ROS agent holds the port open, so it is stopped
    first, and the caller restarts it.
    This copy had been running on the robot without reaching the repo.
2026-10-15 feat(teensy): drive both ElRobot arms over the servo bus on Serial7
    A Waveshare Bus Servo Adapter (A) in UART mode sits between Teensy Serial7
    (pins 28/29) and both arms' STS3215 chains. Console commands:
    - BUS SCAN [port], read-only. Sends PING and READ only, never to the
    broadcast ID, and counts every byte received. That separates "nothing
    wired" from "no servo answering".
    - BUS READ <id> <addr> <len>: one raw READ, for diagnosis.
    - BUS SETID <from> <to>: the only bus write.
    - It refuses unless exactly one servo answers at <from> (five clean reads)
    and nothing answers at <to>.
    - It touches only the EEPROM lock and ID registers.
    - It reads the new ID back.
    - ARM <L|R> STATE |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
2026-10-15 feat(panel): a card per arm, with its camera, torque, speed and eight joints
    Left and right arm cards on the control panel:
    - the arm's gripper camera
    - Enable torque / Release
    - a speed slider (50-3000 steps/s)
    - eight joint sliders, 0-4095
    While torque is off, the sliders follow the arm, so turning a joint by hand
    shows which slider is which. While it is on, a moving slider is sent at most
    every 120 ms, and once more on release.
    /api/arm/<left|right>, /torque, /speed and /move sit behind the cameras'
    sensor guard: a password must exist before the arms can be used from the LAN.
    Moves and speeds are range-checked before they reach the Teensy. A move the
    firmware refuses comes back as 409 r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
2026-10-15 docs: log 028, both arms on the servo bus
    Covers:
    - the board's A/B jumper, proven by counting received bytes
    - a whole chain still at factory ID 1, where identical pings overlap
    cleanly and differing reads collide
    - assigning 16 IDs on assembled arms, one unplugged link per step
    - the first moves straining against a 30% torque cap and the 0/4095 seam
    Also a Teensy restart and a light sensor that lost power during wiring.
    The inventory now records:
    - the adapter as built: jumper modes, UART header, wiring to Serial7
    - the arms' final IDs: left 1-8, right 11-18
2026-10-15 docs(log): a photo of the day both arms first moved
    Gerdoo with both ElRobot arms mounted and wired, added to log 028 as a history
    note. Re-encoded before committing, so it carries no EXIF, GPS or device
    metadata.
2026-10-16 feat(teensy): drive the arms in multi-turn mode, with limits in the Teensy's EEPROM
    Most joints' encoder rollover sits inside their travel: the servos were
    mounted without being centred. In single-turn mode a servo can never drive
    through that point. It took the long way round into its end stop instead (a
    small nudge on left J7 ran it to the stop at 30% load), and calibration
    cannot move the rollover.
    Every servo now runs with multi-turn feedback (Phase bit 4) and angle limits
    0/0, which counts straight through it. The firmware:
    - Shows positions mod 4096, the calibrated display readings the panel uses.
    - Sends a move as a distance from where the joint is now, so it takes the
    physical sh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
2026-10-16 feat(panel): calibrate, set strength, and see the seam guard on each arm card
    - Calibrate…: move every joint by hand from end stop to end stop. Each row
    shows its span against ElRobot's URDF spec, with ✓ within 15%. The
    tracking follows readings through 0/4095. Save asks before writing any
    joint off spec, and skips joints that barely moved.
    - Sliders span each joint's calibrated range once one is stored.
    - A Strength slider (10-100%) per arm, applied while holding.
    - A toast names any joint the firmware's seam watchdog stopped.
    - New routes /api/arm/<side>/calibrate and /strength, range-checked before
    they reach the Teensy. A firmware refusal or rollback comes back as 409.
    STAT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
2026-10-16 docs(log): 028 follow-up — the encoder rollover inside the travel, and multi-turn mode
    - the seam guard
    - calibration, including a first save that half-applied because the check
    read the offset 20 ms after writing it
    - the cause underneath: the encoder rollover sits inside the travel on six of
    seven joints, where single-turn mode can never drive through it
    - the multi-turn experiment on left J7: continuous counting by hand, then
    powered moves through the old rollover both ways
    - the rollout to all 16 servos
    - per-arm strength
    The inventory now notes to centre a servo before fitting its horn.
    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
2026-11-07 feat: drive, ultrasonic, light and reactor screen; arm sides relabelled (0.5.1)
    - Teensy firmware 0.5.0/0.5.1: timed motor runs with bridges off at boot,
    hardware quadrature encoders, four staggered HC-SR04P sensors, PINTEST,
    pack voltage from the servos (register 62) as a fallback for A0, LIGHT
    reports its manual level, and the arm sides relabelled (left = IDs 11-18,
    right = 1-8, limits stay per ID).
    - Control panel: Wheels & ultrasonic, Light and Reactor screen cards, with
    route tests; the arc-reactor LCD driven from the Jetson's SPI header as a
    user service.
    - Arm cameras on their new USB paths after the 2nd floor went on.
    - Console commands start with a newline so echoed hear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
2026-11-07 feat(print): final print plates, per-part STLs and a print guide
    - print/3mf: the 16 final Bambu A1 plates (robot body and dock).
    - print/stl: 41 STLs cut from those plates in print orientation, one per
    unique part, with counts in the guide.
    - print/README.md: materials, supports, inserts, re-sliced times and the
    log behind each plate.
    - sim/: the browser simulator, physics model and the plate/3MF tools,
    including export_print_stls.py.
2026-11-07 docs: logs 029-059, corrections, and the as-built charging notes
    - Logs 029-047 (Oct 16-29) and 048-059, back-filled per day from 21 Oct to
    7 Nov: spacers, beam clash, charge-path diodes, motor wiring, Jetson power
    drops, neck servos, the dead step-down, the 45 W supply overload, arm
    relabel, and the step-down current limit bypassed by the shared ground.
    - Corrections: 042 (the topple was the neck), 045 (dock sign slice),
    046 (beam clash reference), 011 (30SQ050 is 3 A), 040 (washers fixed it).
    - inventory.md: as-built charging, 90 W supply, dead XL4015s, ground link
    not fitted, replacement charger ordered.
    - Removed a LAN address, a home path and a company name from the docs.
    Co-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
